rowan-walsh/BruteforceIgnorance/README.md

BruteforceIgnorance
===================

This repository is for all things related to the BruteforceIgnorance team.
Commit here, commit often: stuff saved here will be visible to all team members.

Keep the files well organised too.  Add, sort, use subfolders.
