rowan-walsh/BruteforceIgnorance/Documentation/Design Proposal/Hardware Design/Drive System Graphic.png

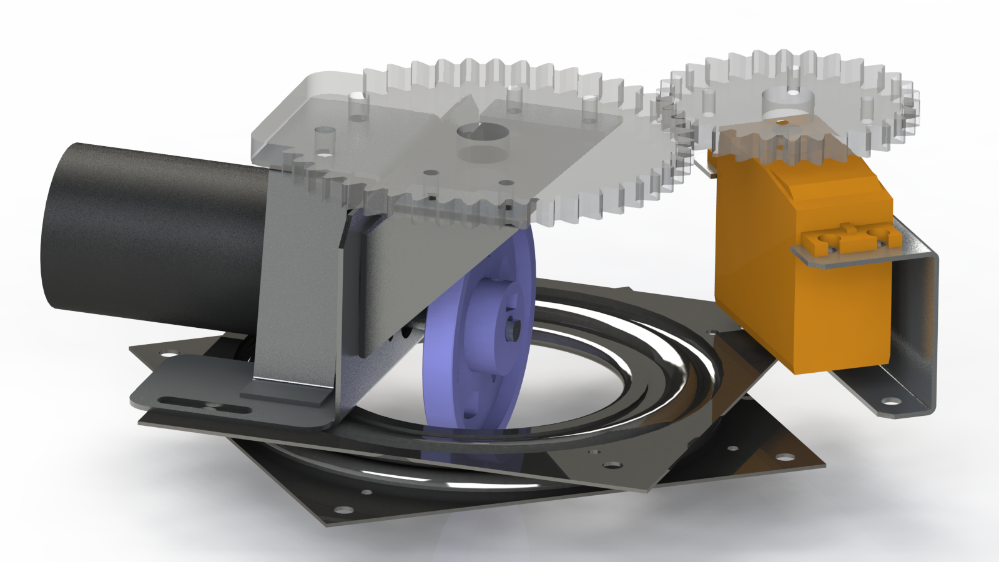
Documentation/Design Proposal/Hardware Design/Drive System Graphic.png
