rowan-walsh/BruteforceIgnorance/Documentation/Design Proposal/Hardware Design/Lazy Susan Bearing Graphic.png

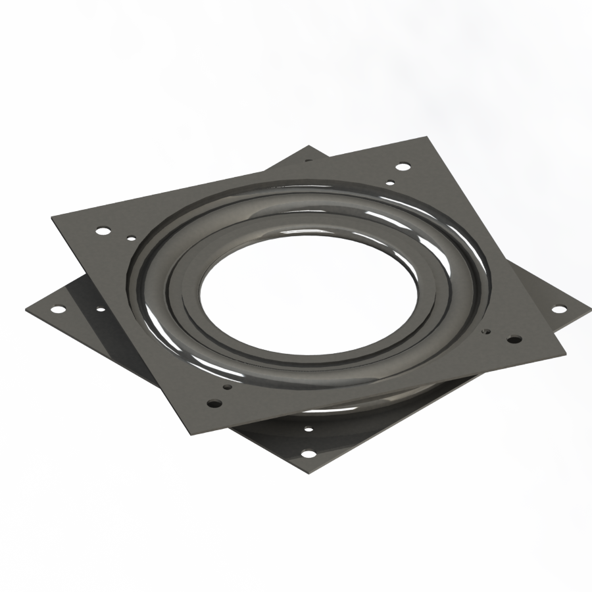
Documentation/Design Proposal/Hardware Design/Lazy Susan Bearing Graphic.png
