rowan-walsh/BruteforceIgnorance/Documentation/Design Proposal/Software Code and Algorithm/Scott Robot State Diagram.png

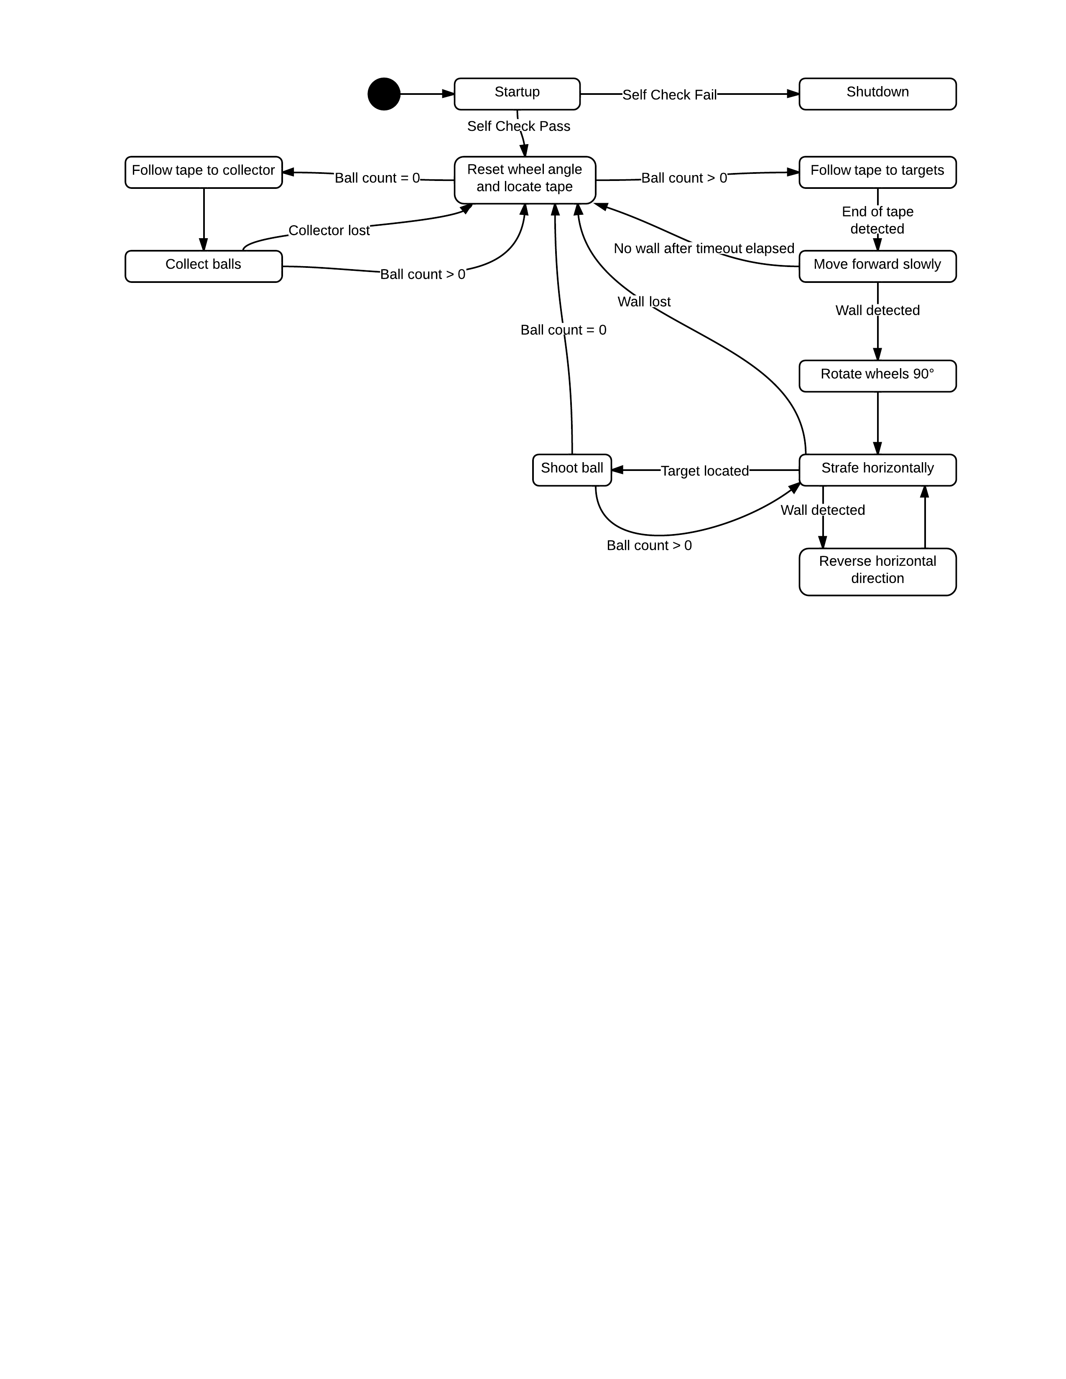
Documentation/Design Proposal/Software Code and Algorithm/Scott Robot State Diagram.png
