rowan-walsh/BruteforceIgnorance/Documentation/Design Proposal/Software Code and Algorithm/ShootingFlowchart.png

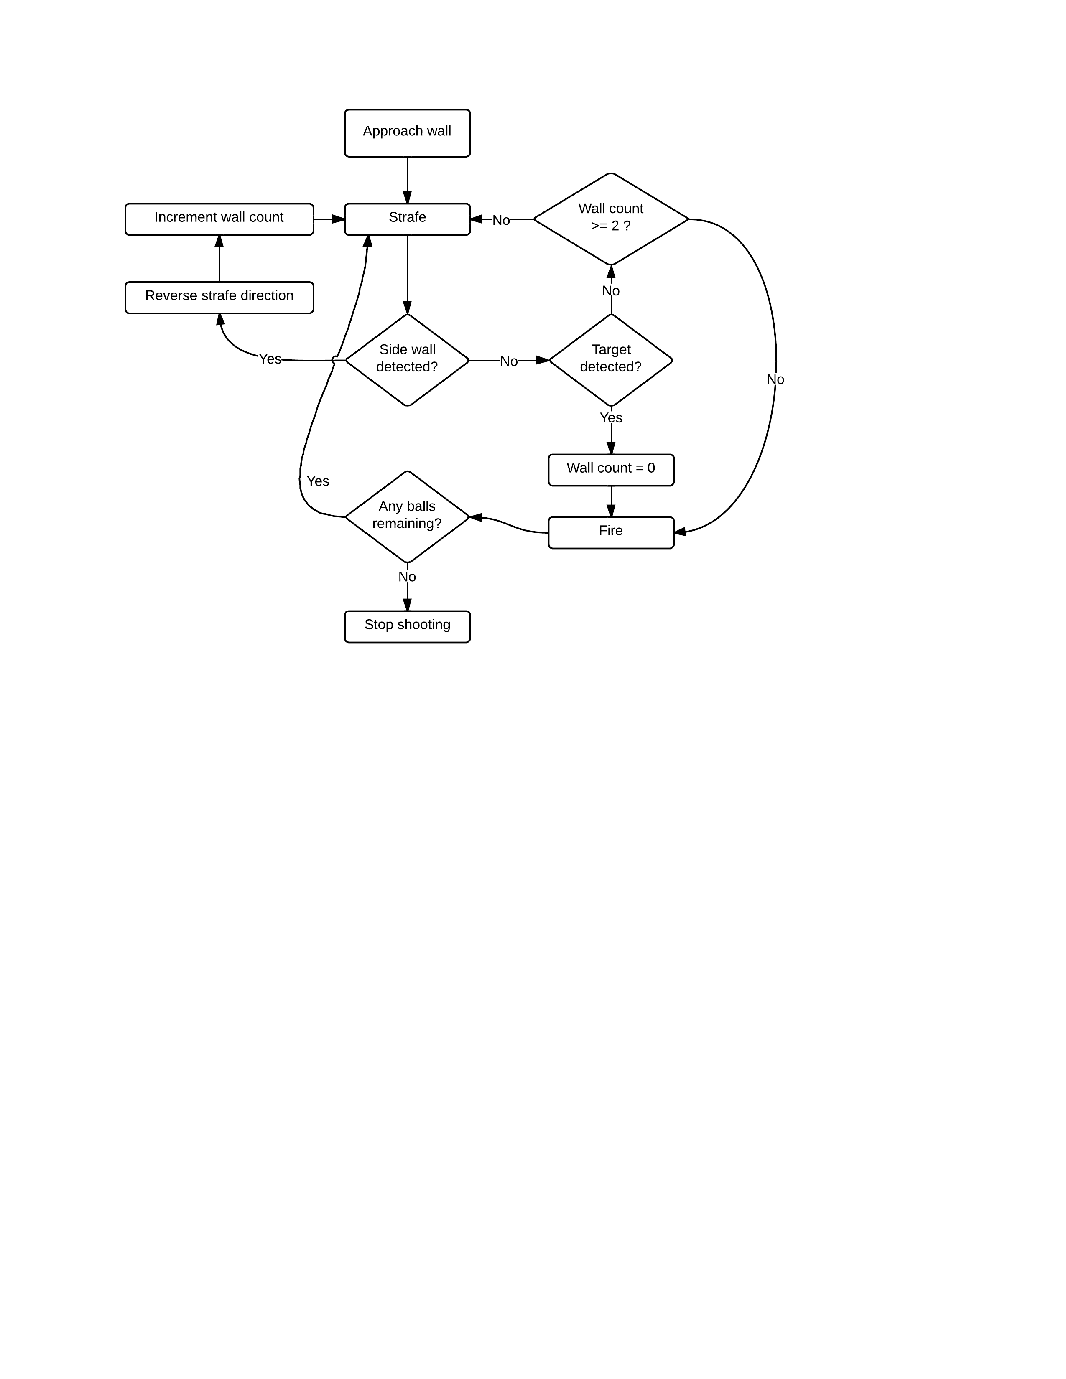
Documentation/Design Proposal/Software Code and Algorithm/ShootingFlowchart.png
