rowan-walsh/BruteforceIgnorance/Documentation/Liam's photos/Brush Closeup.jpg

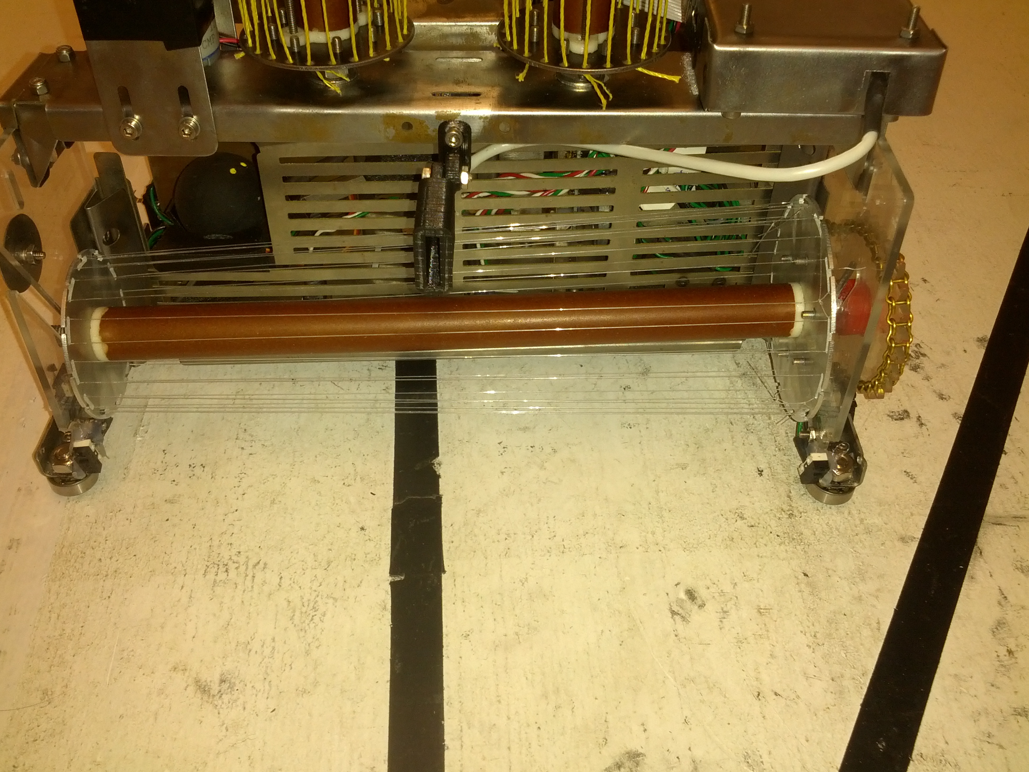
Documentation/Liam's photos/Brush Closeup.jpg
