rowan-walsh/BruteforceIgnorance/Documentation/Liam's photos/Drive closeup.jpg

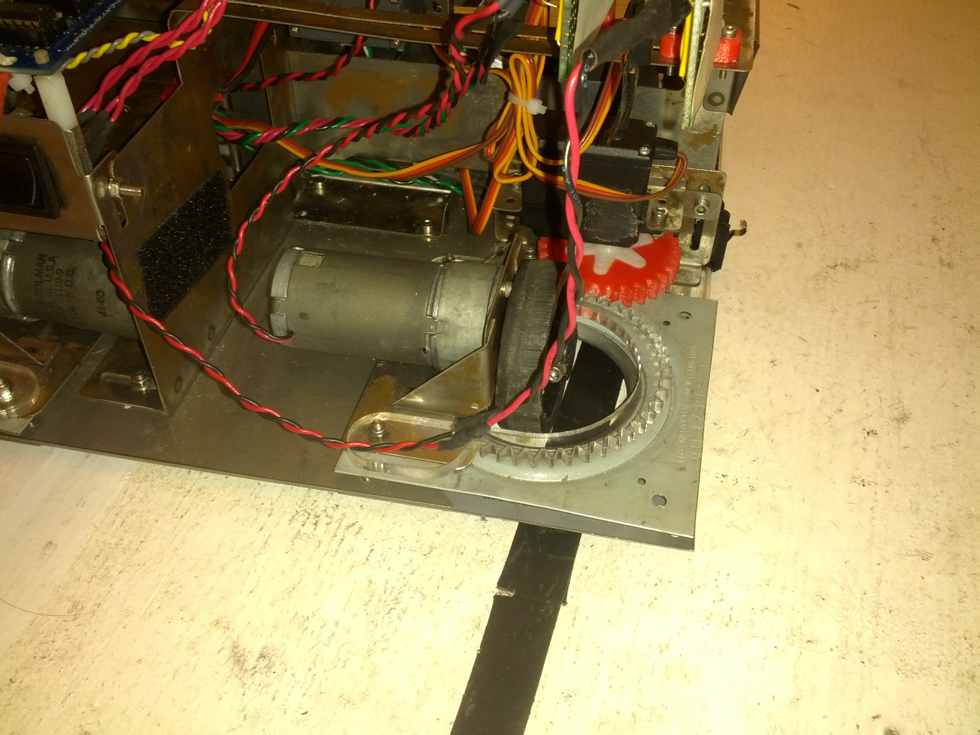
Documentation/Liam's photos/Drive closeup.jpg
