rowan-walsh/BruteforceIgnorance/Documentation/Liam's photos/Firing closeup.jpg

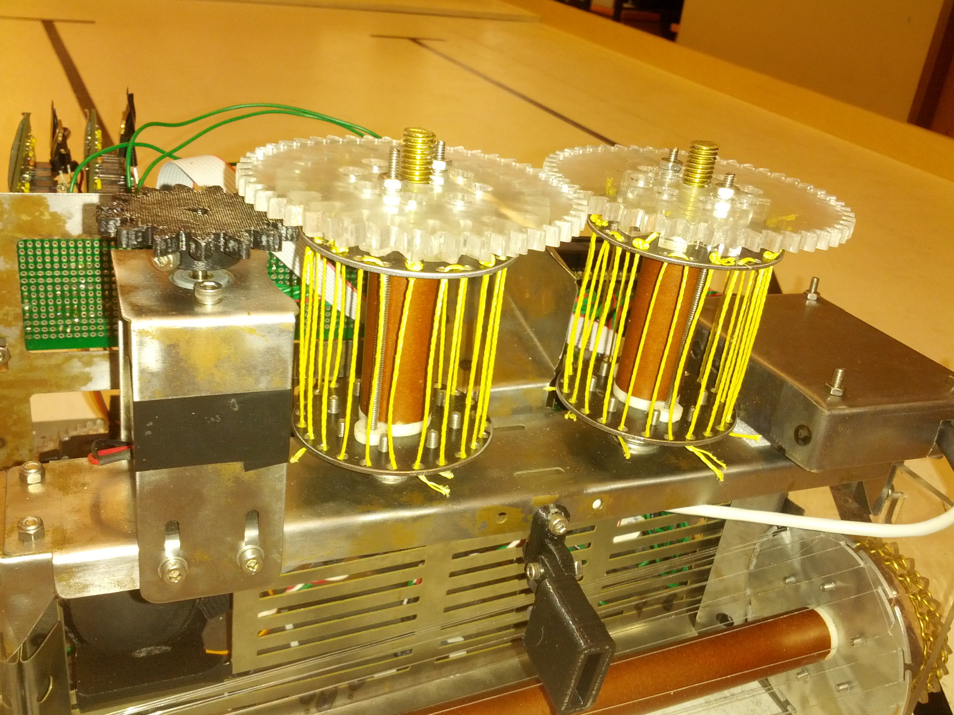
Documentation/Liam's photos/Firing closeup.jpg
