rowan-walsh/BruteforceIgnorance/Documentation/Liam's photos/Iso back.jpg

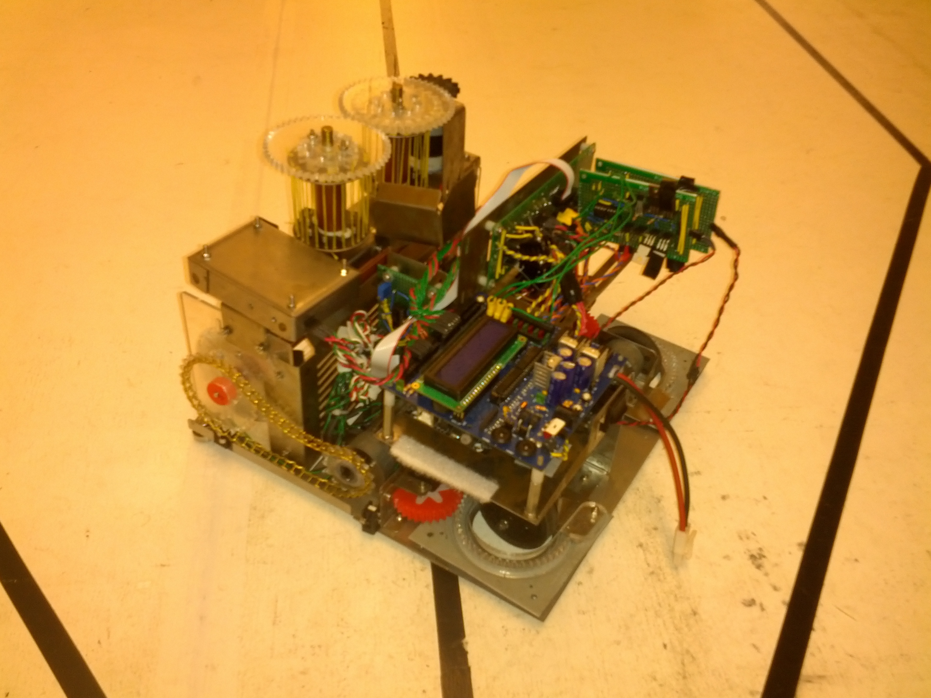
Documentation/Liam's photos/Iso back.jpg
