rowan-walsh/BruteforceIgnorance/Documentation/Liam's photos/Iso front.jpg

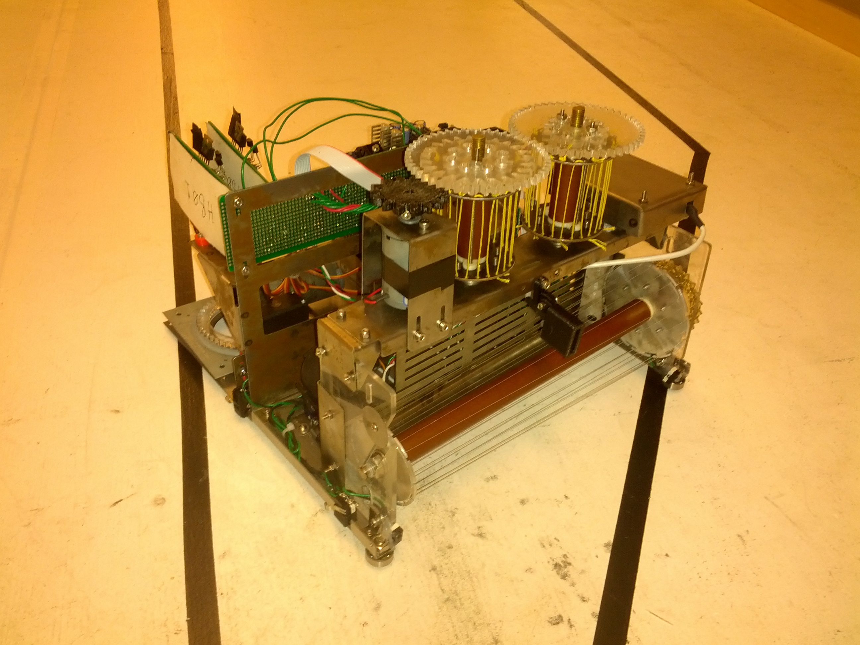
Documentation/Liam's photos/Iso front.jpg
