rowan-walsh/BruteforceIgnorance/Documentation/Liam's photos/Loading closeup.jpg

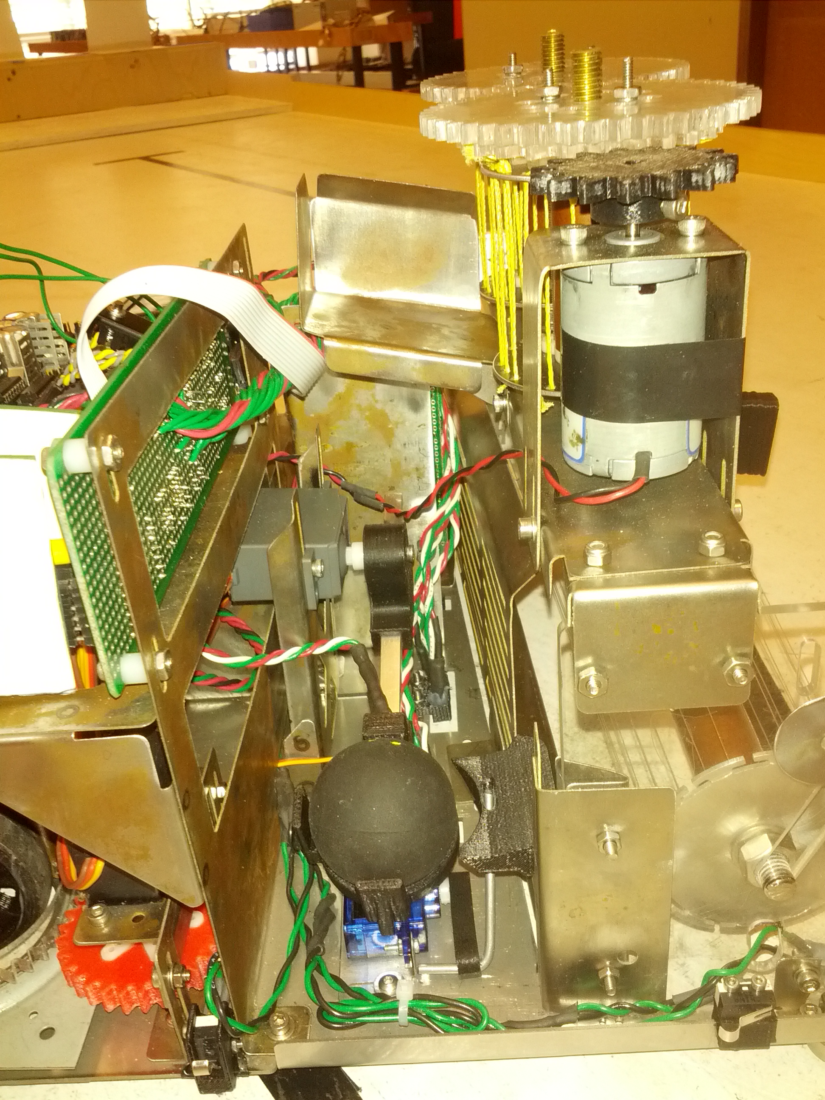
Documentation/Liam's photos/Loading closeup.jpg
