rowan-walsh/BruteforceIgnorance/Documentation/Liam's photos/Top.jpg

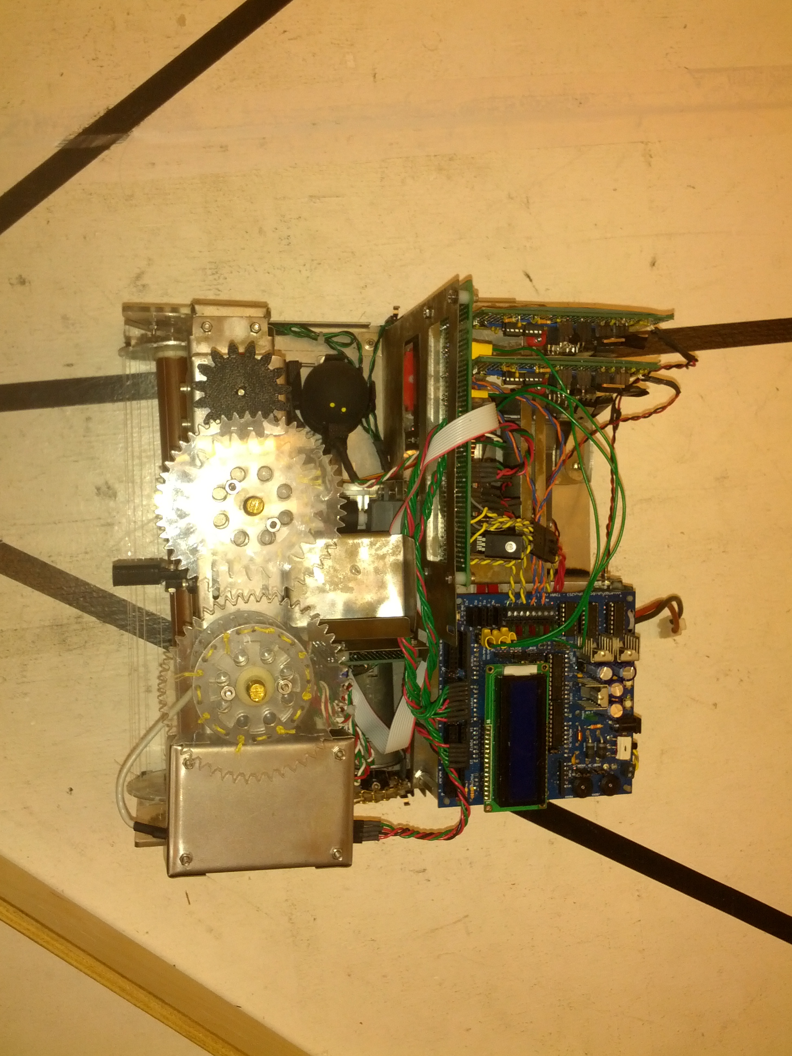
Documentation/Liam's photos/Top.jpg
