rowan-walsh/BruteforceIgnorance/Documentation/Liam's photos/Transparent.png

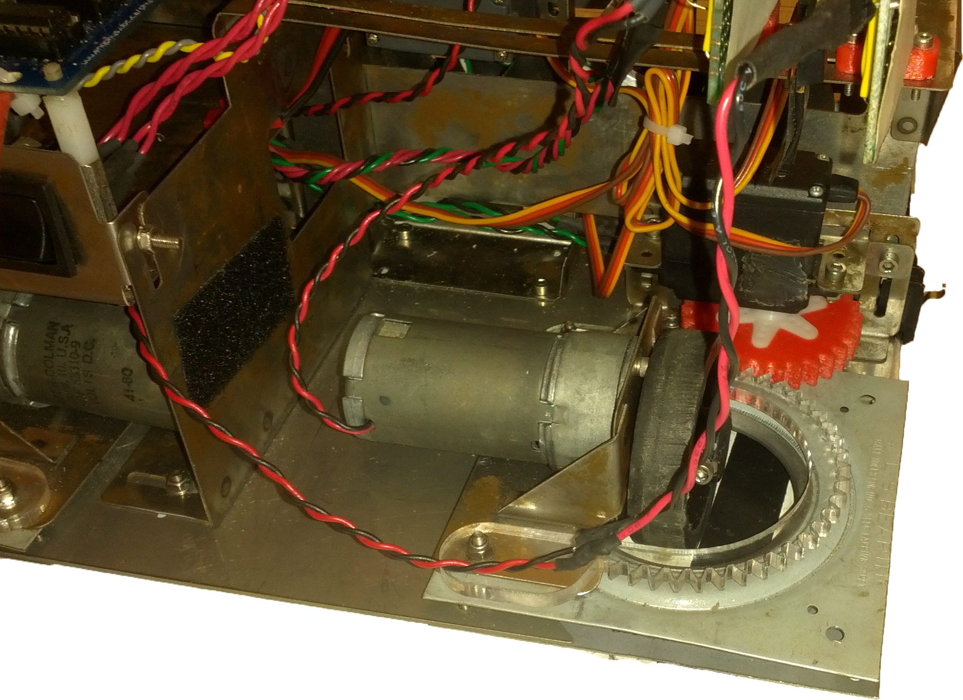
Documentation/Liam's photos/Transparent.png
