rowan-walsh/BruteforceIgnorance/Documentation/Renders/Early Firing System.png

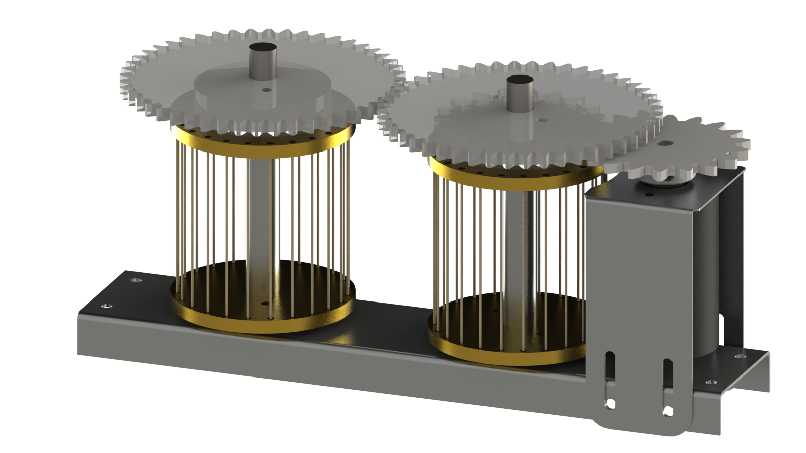
Documentation/Renders/Early Firing System.png
