rowan-walsh/BruteforceIgnorance/Documentation/Scott's photos/IMG_20130802_181802.jpg

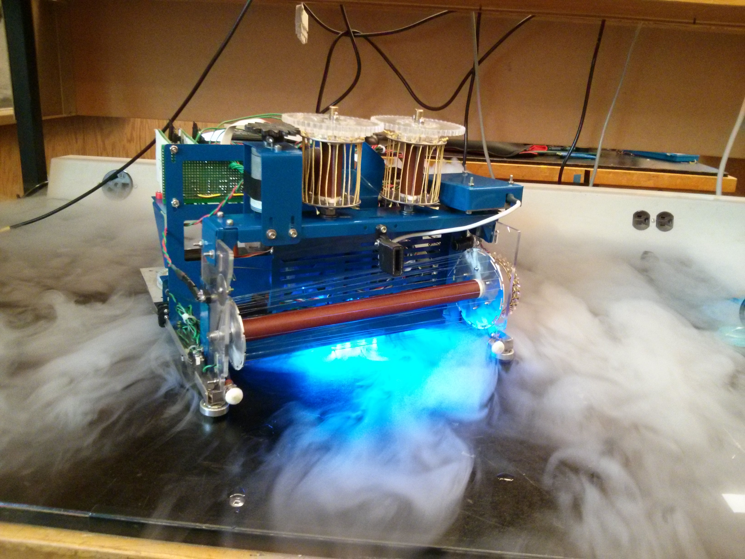
Documentation/Scott's photos/IMG_20130802_181802.jpg
