rowan-walsh/BruteforceIgnorance/Documentation/Scott's photos/IMG_20130802_181812.jpg

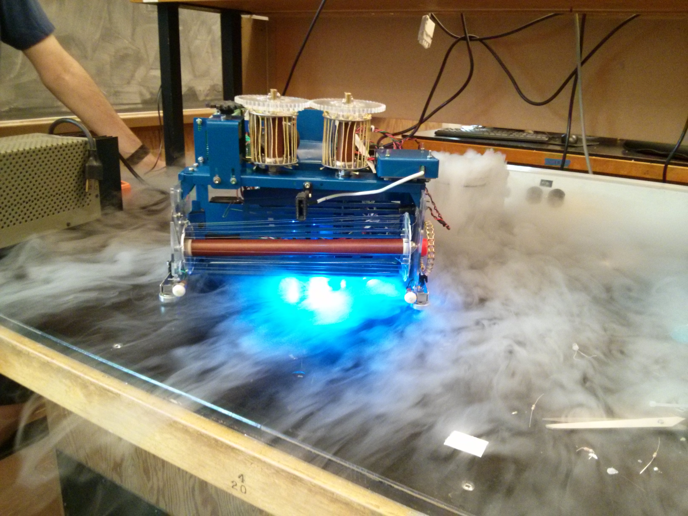
Documentation/Scott's photos/IMG_20130802_181812.jpg
