rowan-walsh/BruteforceIgnorance/Documentation/Scott's photos/IMG_20130802_181825.jpg

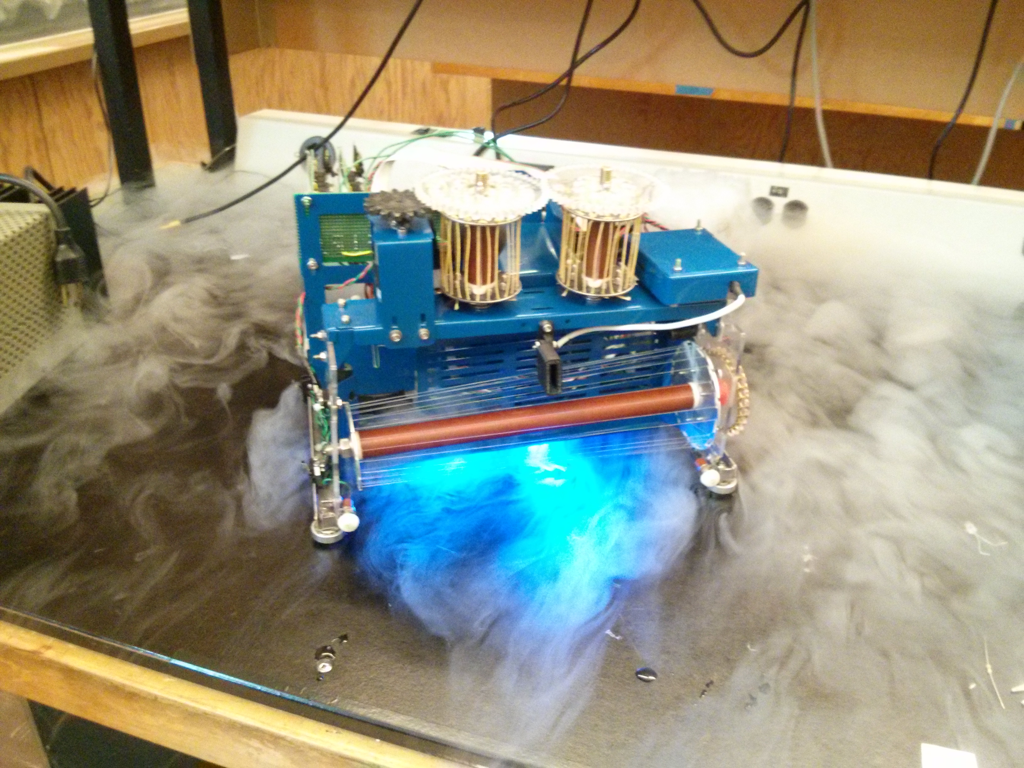
Documentation/Scott's photos/IMG_20130802_181825.jpg
