rowan-walsh/BruteforceIgnorance/Documentation/Scott's photos/IMG_20130802_181956.jpg

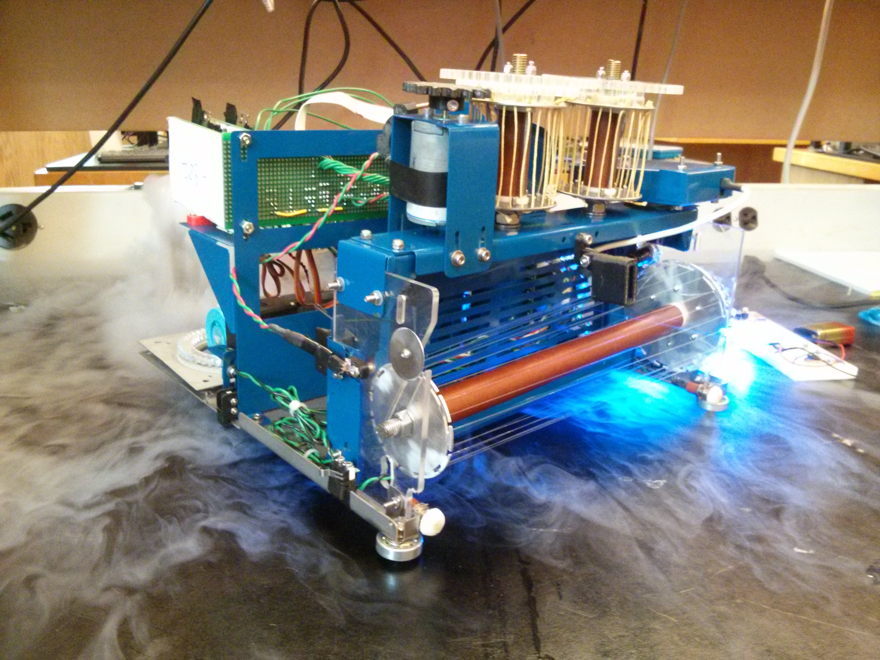
Documentation/Scott's photos/IMG_20130802_181956.jpg
