rowan-walsh/BruteforceIgnorance/Documentation/Scott's photos/IMG_20130802_182054.jpg

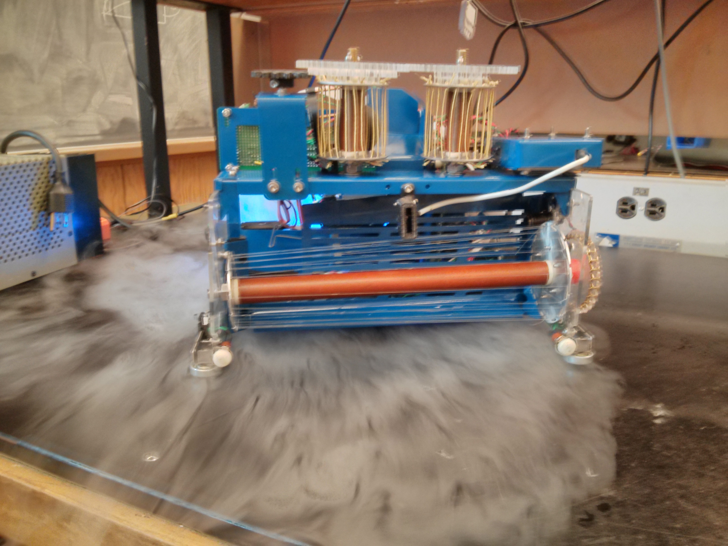
Documentation/Scott's photos/IMG_20130802_182054.jpg
