rowan-walsh/BruteforceIgnorance/Documentation/Scott's photos/IMG_20130802_182110.jpg

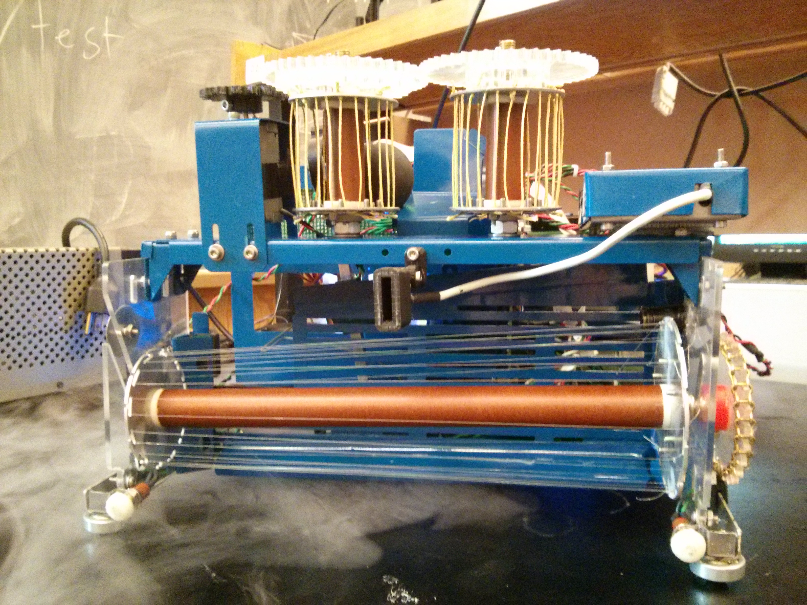
Documentation/Scott's photos/IMG_20130802_182110.jpg
