rowan-walsh/BruteforceIgnorance/Documentation/Scott's photos/IMG_20130802_182121.jpg

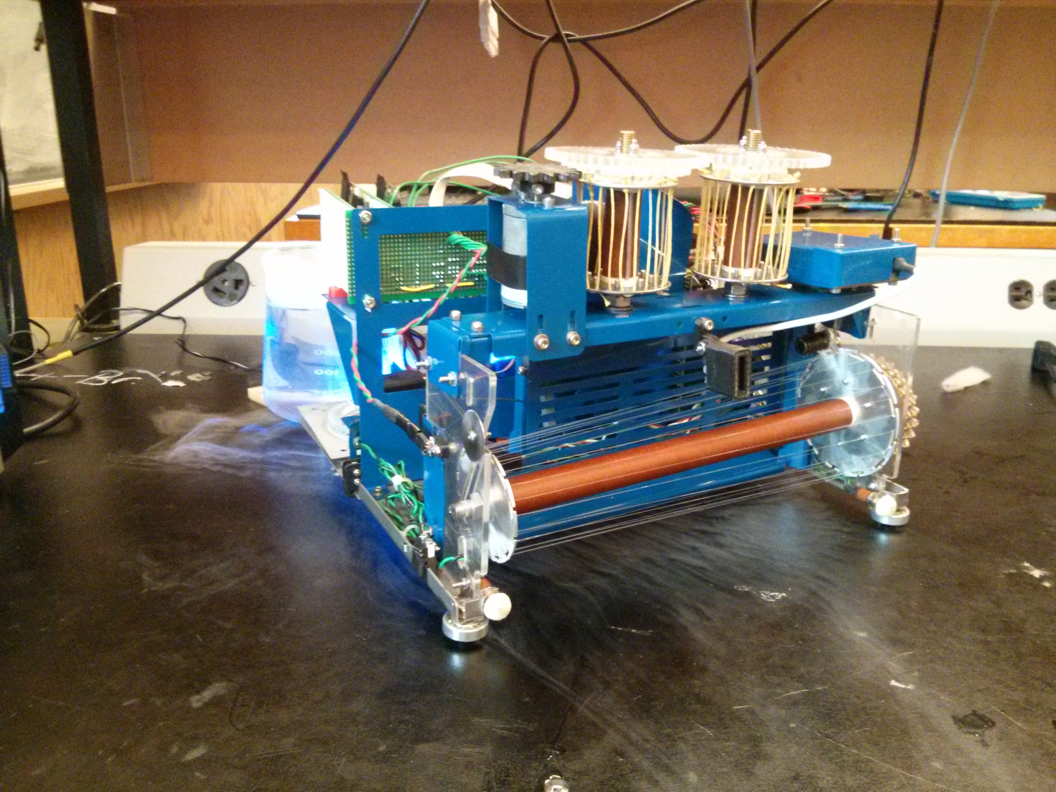
Documentation/Scott's photos/IMG_20130802_182121.jpg
