rowan-walsh/BruteforceIgnorance/Documentation/Scott's photos/IMG_20130802_185343.jpg

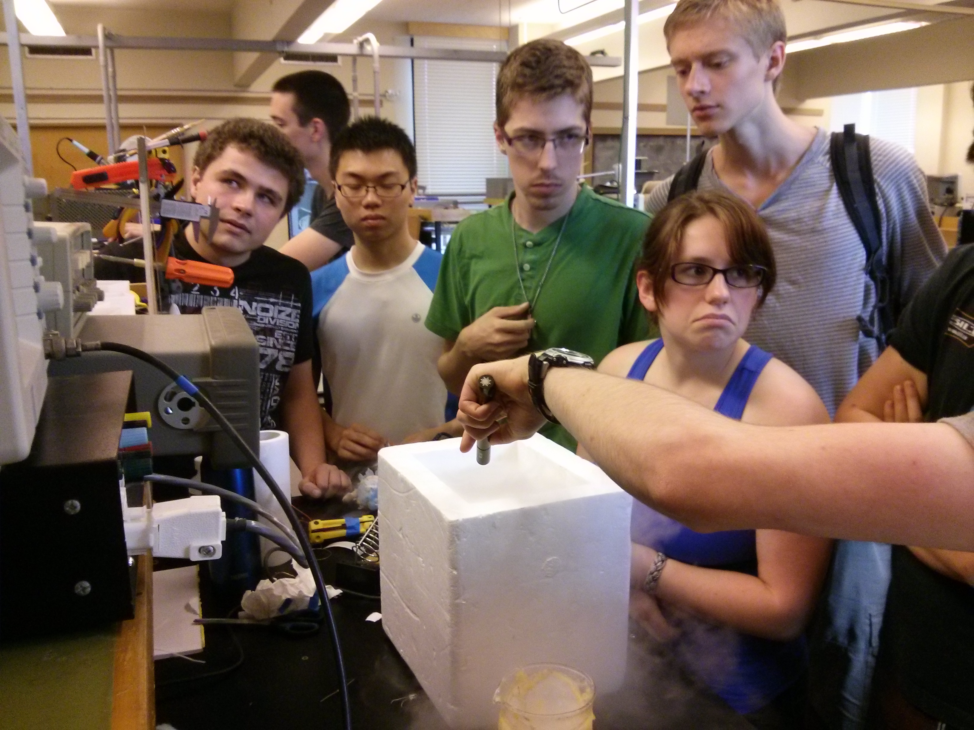
Documentation/Scott's photos/IMG_20130802_185343.jpg
