rowan-walsh/BruteforceIgnorance/Documentation/Scott's videos/Random wall follow picture.jpg

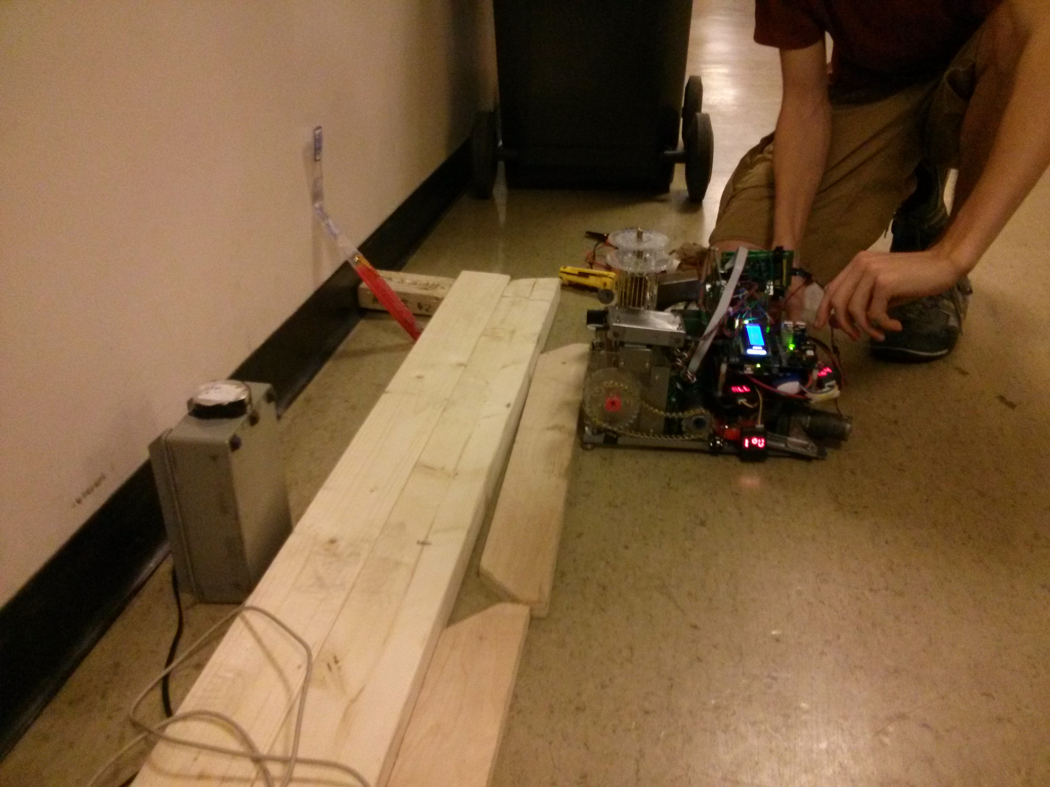
Documentation/Scott's videos/Random wall follow picture.jpg
