rowan-walsh/BruteforceIgnorance/Hardware/Supplied Component Models/solarbotics-gm7-solid-model/Solarbotics_GM7.jpg

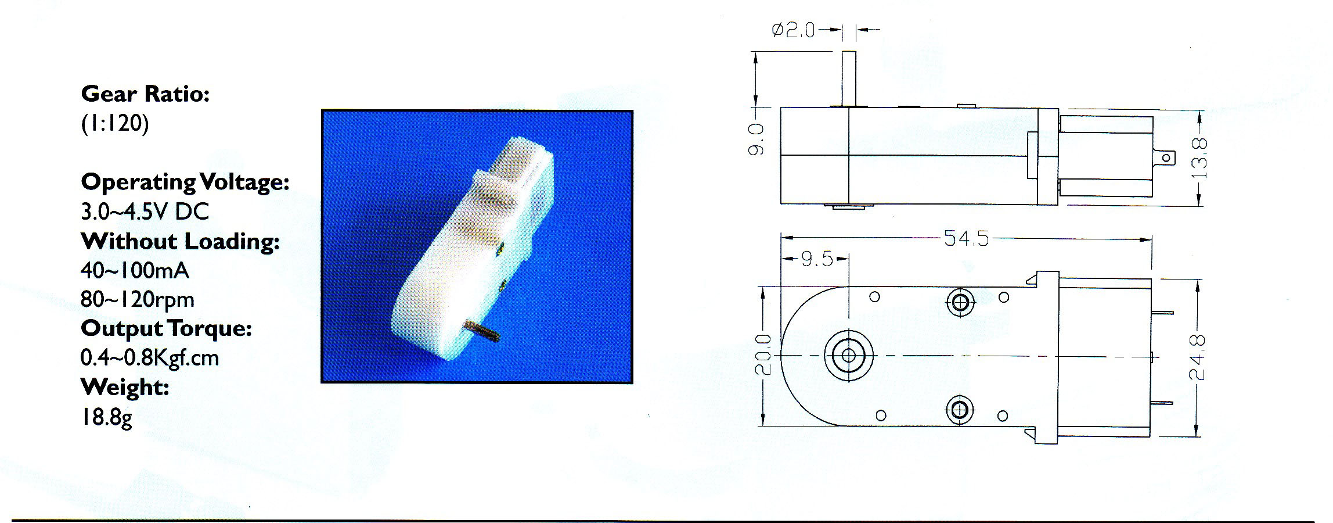
Hardware/Supplied Component Models/solarbotics-gm7-solid-model/Solarbotics_GM7.jpg
