rowan-walsh/BruteforceIgnorance/Hardware/Firing mechanism/00 Emitter.SLDASM

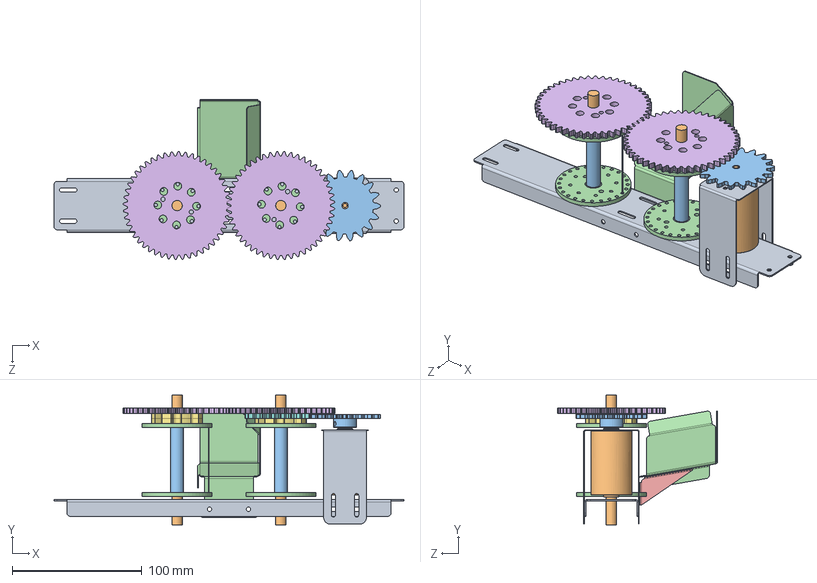
[picture p50: CAD file, 2013-07-26]
Hardware/Firing mechanism/00 Emitter.SLDASM
270.0 x 100.0 x 123.6 mm
Roller Bracket
Roller Axle x 2
Roller Spacer x 2
Roller Plate x 4
Roller Gear x 2
Roller Gear Spacer x 3
Motor-Roller Gear
Upright Motor Bracket
Motor BarbCole Ungeared
Printed Motor-Roller Gear
Upper Ramp 2
Ramp Brace
