rowan-walsh/BruteforceIgnorance/Hardware/IR Sensor/OP 805 Blinder/Blinder.SLDASM

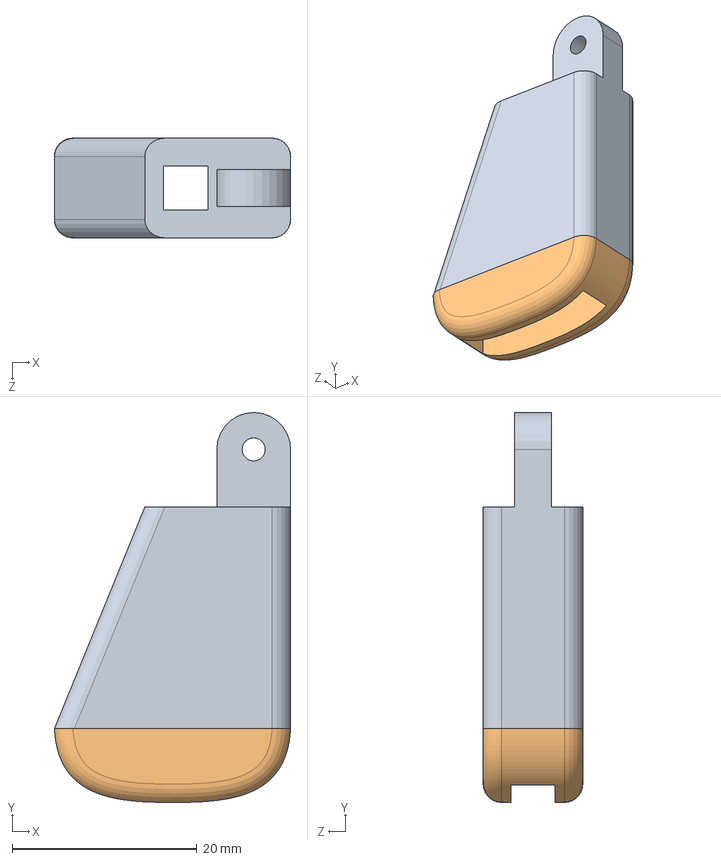
[picture p51: CAD file, 2013-07-30]
Hardware/IR Sensor/OP 805 Blinder/Blinder.SLDASM
25.6 x 42.2 x 10.8 mm
GLaDOS blinder
GLaDOS faceplate
