rowan-walsh/BruteforceIgnorance/Hardware/Laser range finder/Laser range finder assembly.SLDASM

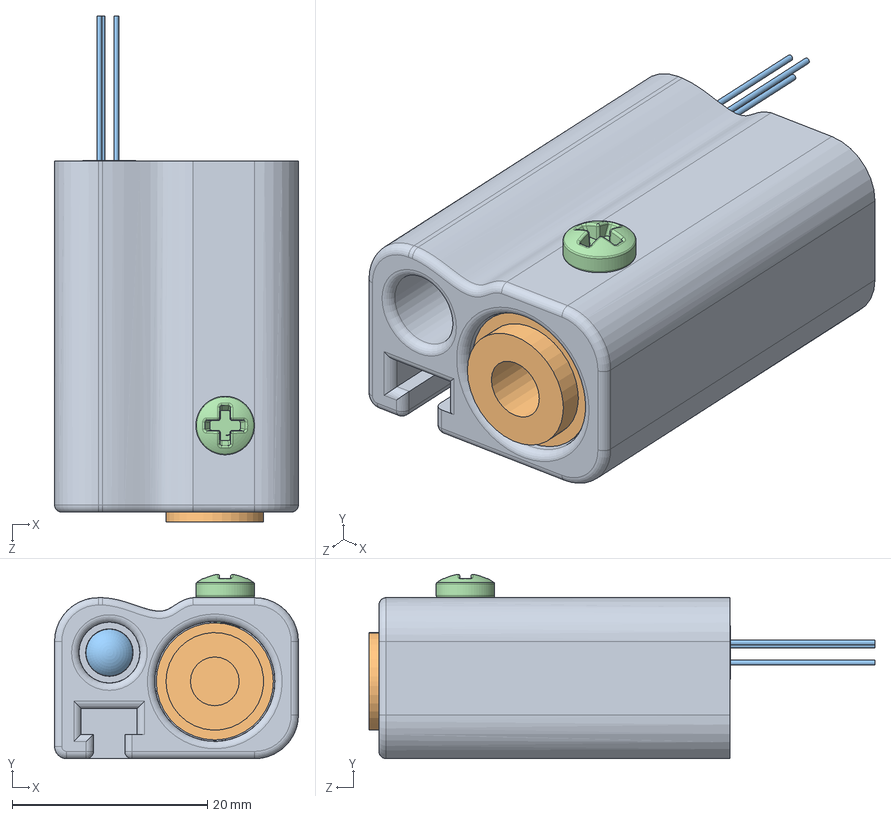
[picture p52: CAD file, 2013-06-26]
Hardware/Laser range finder/Laser range finder assembly.SLDASM
25.0 x 18.9 x 51.8 mm
Laser Range Finder
Laser pointer
OP805
Screw UNI8112_M3
