rowan-walsh/BruteforceIgnorance/Hardware/Robot Assembly.SLDASM

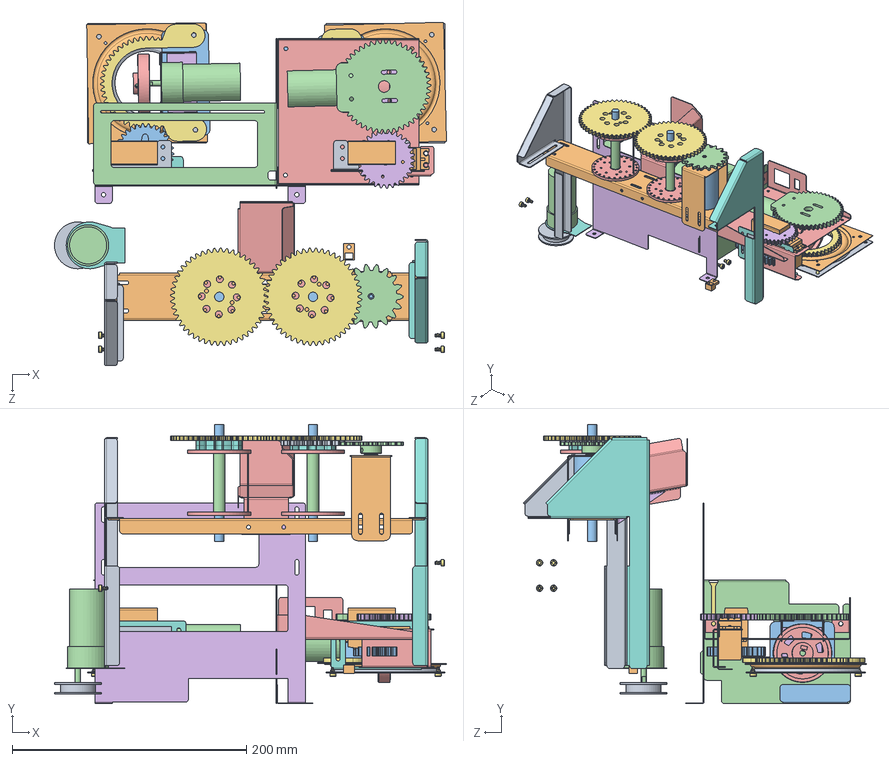
[picture p53: CAD file, 2013-07-30]
Hardware/Robot Assembly.SLDASM
334.5 x 238.5 x 293.1 mm
4inch Turntable Bottom x 2
4inch Turntable Top x 2
Motor Bracket x 2
Motor Barber Coleman geared x 3
Wheel x 2
Gear Bracket x 4
Lower Turntable Gear x 2
Servo Bracket 2.1 x 2
Servo Bracket 2.2 x 2
Servo Futaba S3003 x 3
Printed Servo Gear x 2
Turntable Gear
Servo Bracket
Servo Gear (30t)
Screw SC M3 x 5 x 10
Brush Drive Motor Mount
Brush Motor Belt Gear
QRD Holder
base right flange
battery harness mount
battery tinah mount
back support
end support
Firing Mounting Bracket
Mirrored Firing Mounting Bracket
Roller Bracket
Roller Axle x 2
Roller Spacer x 2
Roller Plate x 4
Roller Gear x 2
Roller Gear Spacer x 3
Motor-Roller Gear
Upright Motor Bracket
Motor BarbCole Ungeared
Printed Motor-Roller Gear
Upper Ramp 2
Ramp Brace
