rowan-walsh/BruteforceIgnorance/Hardware/Supplied Component Models/solarbotics_gm2_solid_models/GM2_assembly.IGS

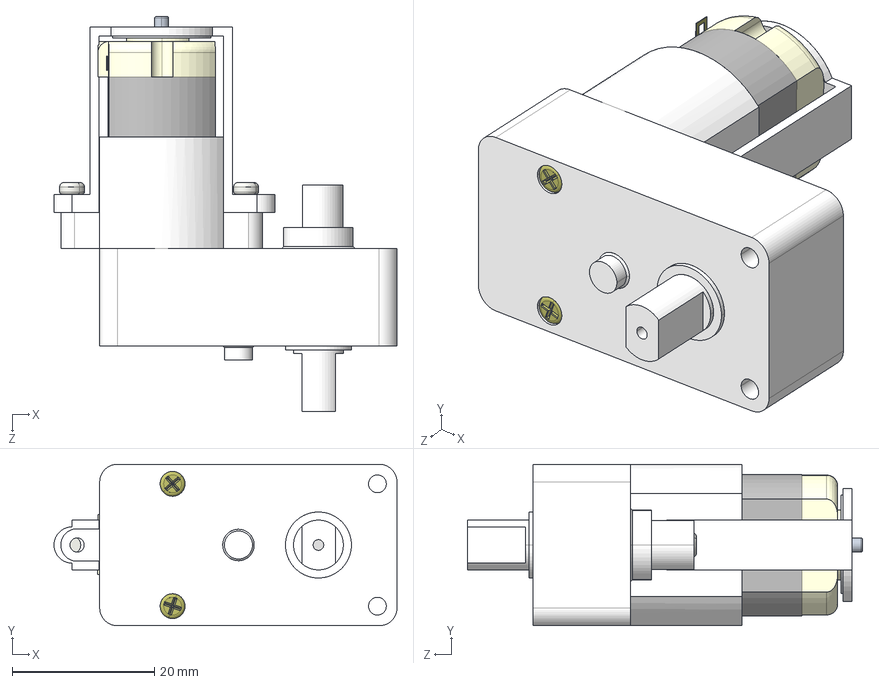
[picture p54: CAD file, 2013-05-31]
Hardware/Supplied Component Models/solarbotics_gm2_solid_models/GM2_assembly.IGS
48.2 x 22.7 x 55.6 mm
