rowan-walsh/BruteforceIgnorance/Hardware/Ball Collector/Brush_Assembly.SLDASM

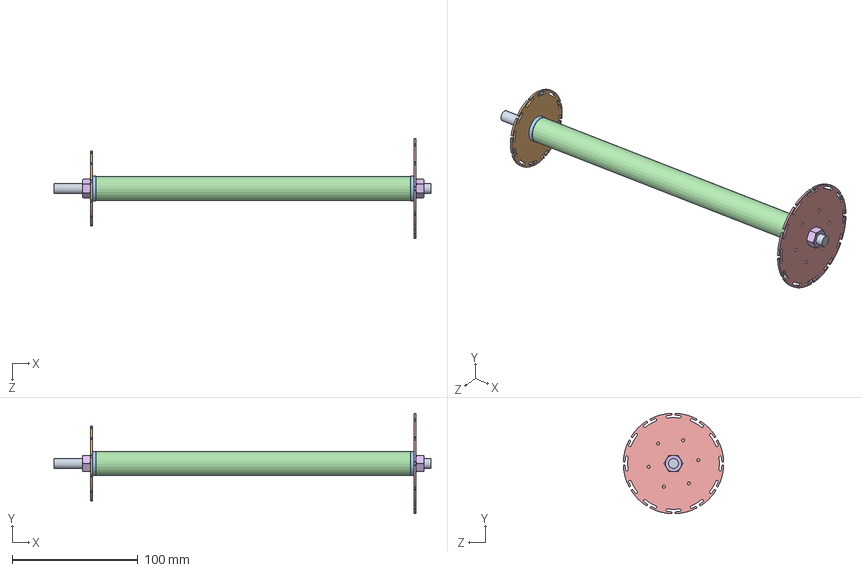
[picture p55: CAD file, 2013-07-25]
Hardware/Ball Collector/Brush_Assembly.SLDASM
300.0 x 80.0 x 80.0 mm
Brush_Rod
Brush_Wheel_Small
Space Rod Cap x 2
Spacer Tube
Brush_Wheel_Tensioner
M8 Washer x 2
