rowan-walsh/BruteforceIgnorance/Hardware/Ferris Wheel/Ferris Assembly.SLDASM

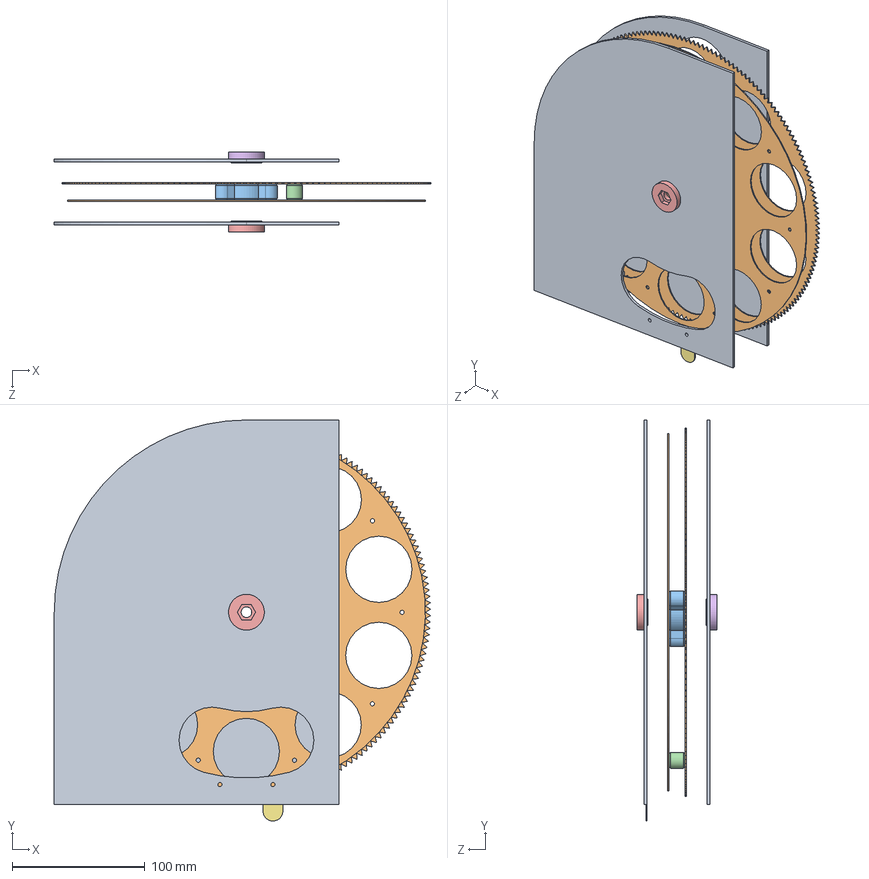
[picture p56: CAD file, 2013-06-09]
Hardware/Ferris Wheel/Ferris Assembly.SLDASM
284.0 x 302.5 x 60.0 mm
Containment Plate
Axle Bolt Head Holder
Insertion Ramp
