rowan-walsh/BruteforceIgnorance/Hardware/Firing mechanism/01 Firing Assembly.SLDASM

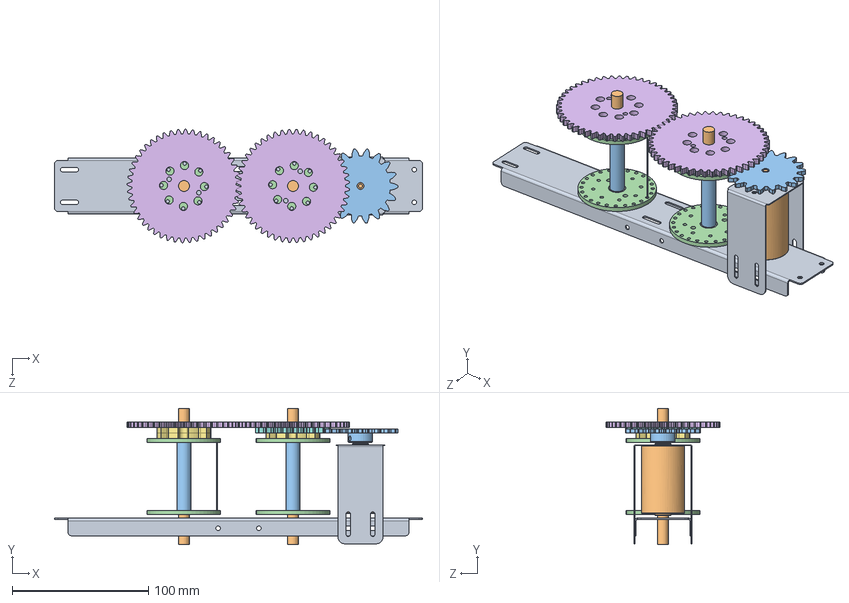
[picture p57: CAD file, 2013-07-26]
Hardware/Firing mechanism/01 Firing Assembly.SLDASM
270.0 x 100.0 x 83.3 mm
Roller Bracket
Roller Axle x 2
Roller Spacer x 2
Roller Plate x 4
Roller Gear x 2
Roller Gear Spacer x 3
Motor-Roller Gear
Upright Motor Bracket
Motor BarbCole Ungeared
Printed Motor-Roller Gear
