rowan-walsh/BruteforceIgnorance/Hardware/IR Sensor/IR Box.SLDASM

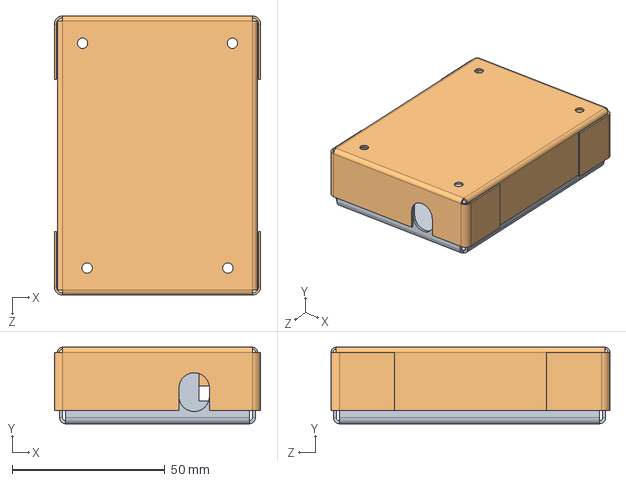
[picture p58: CAD file, 2013-08-08]
Hardware/IR Sensor/IR Box.SLDASM
67.5 x 25.1 x 91.2 mm
IR Box Bottom
IR Box Top
