rowan-walsh/BruteforceIgnorance/Hardware/Mars Rover Wheels/00 Mars Rover Wheel Assembly.SLDASM

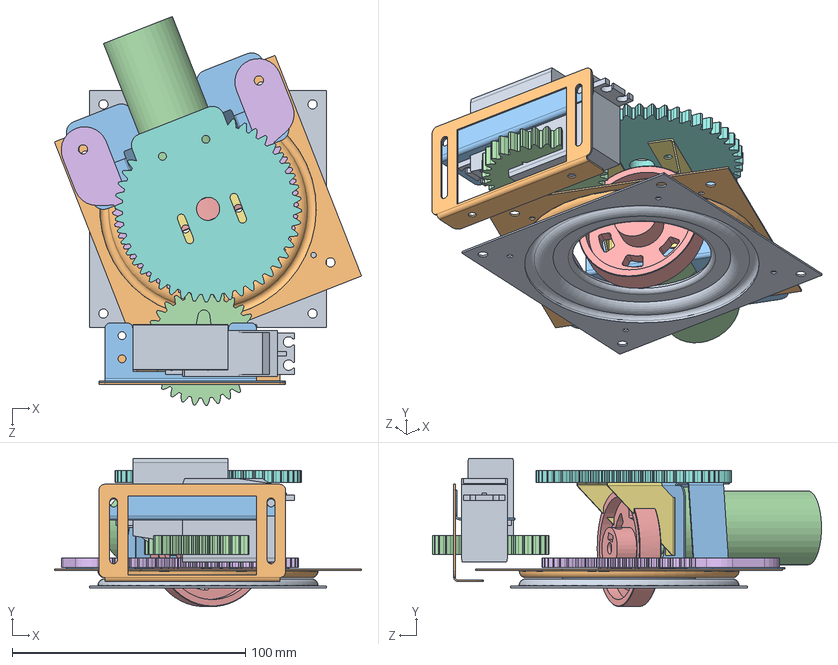
[picture p59: CAD file, 2013-07-16]
Hardware/Mars Rover Wheels/00 Mars Rover Wheel Assembly.SLDASM
131.7 x 63.5 x 166.8 mm
4inch Turntable Bottom
4inch Turntable Top
Motor Bracket
Motor Barber Coleman geared
Wheel
Lower Turntable Gear
Gear Bracket x 2
Turntable Gear
Servo Futaba S3003 x 2
Servo Bracket 2.1
Servo Bracket 2.2
Printed Servo Gear
