rowan-walsh/BruteforceIgnorance/Hardware/Wall Bearing/Wall Bearing Assembly.SLDASM

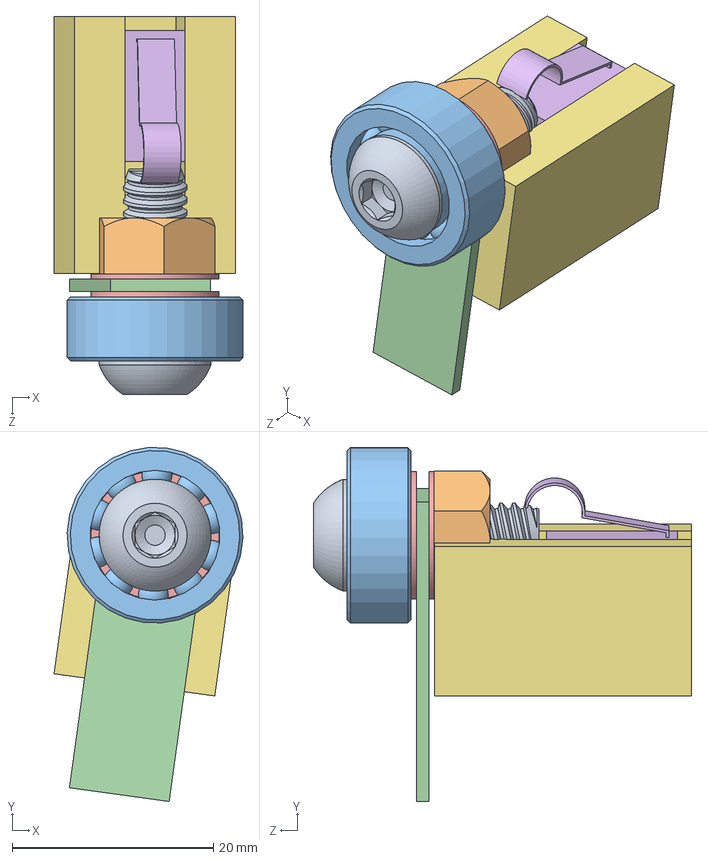
[picture p60: CAD file, 2013-07-25]
Hardware/Wall Bearing/Wall Bearing Assembly.SLDASM
18.8 x 35.1 x 37.5 mm
Screw 1-4in 3-4in long
Nut 1-4-20
Bearing 1-4in ID 11-16in OD
chassis arm
Washer 0.26ID 0.5OD x 2
Touch Sensor
Touch Sensor Holder
