rowan-walsh/BruteforceIgnorance/Hardware/Firing mechanism/Camshaft loader/Camshaft circle.SLDASM

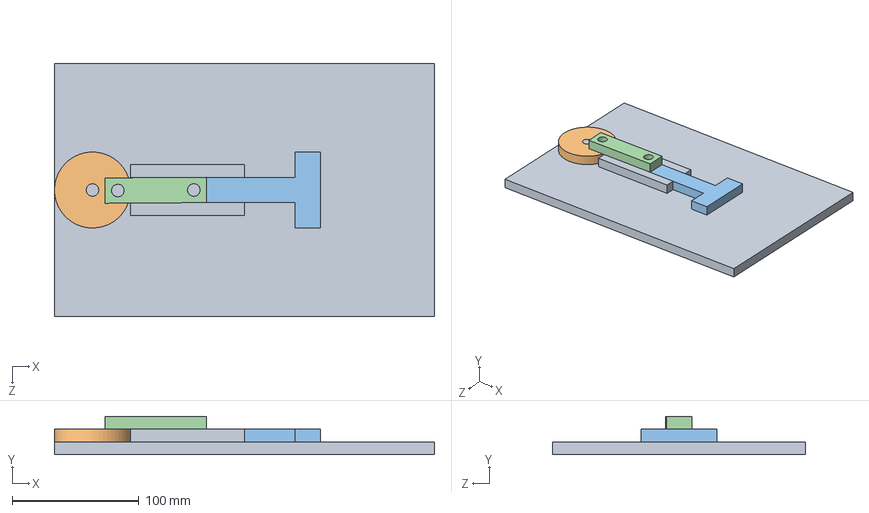
[picture p61: CAD file, 2013-06-15]
Hardware/Firing mechanism/Camshaft loader/Camshaft circle.SLDASM
300.0 x 30.0 x 200.0 mm
Camshaft base
Cam
Pusher
Shaft
