rowan-walsh/BruteforceIgnorance/Hardware/Mars Rover Wheels/01 Motor Assembly.SLDASM

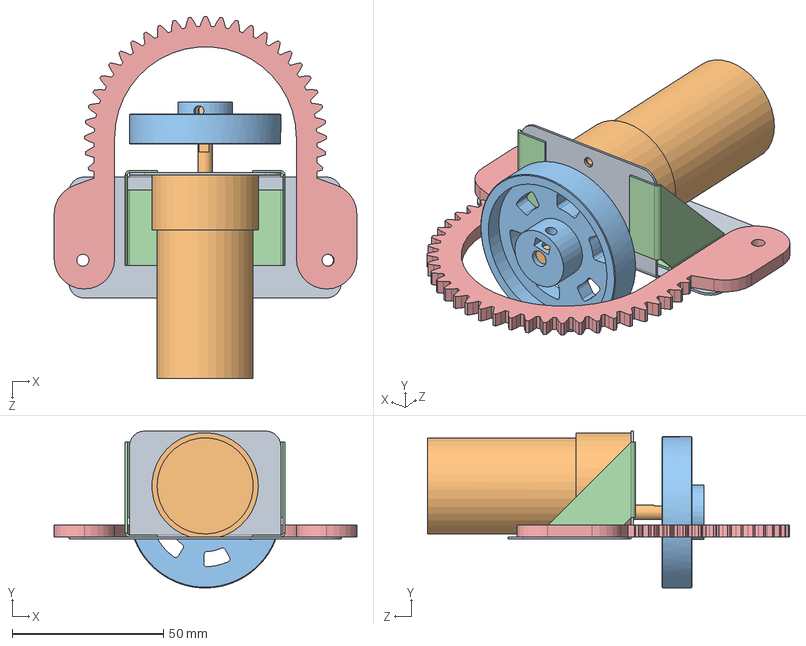
[picture p62: CAD file, 2013-07-06]
Hardware/Mars Rover Wheels/01 Motor Assembly.SLDASM
100.0 x 51.8 x 119.6 mm
Motor Bracket
Motor Barber Coleman geared
Wheel
Gear Bracket x 2
Lower Turntable Gear
