rowan-walsh/BruteforceIgnorance/Hardware/Rough Layout/Collection 2 Rough Assembly.SLDASM

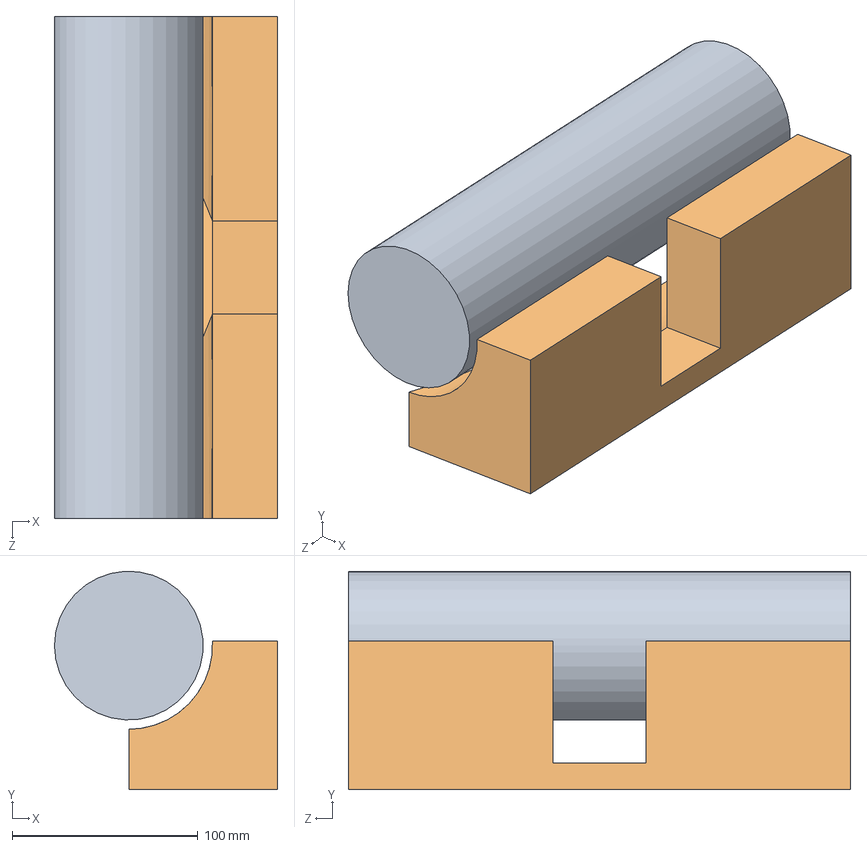
[picture p63: CAD file, 2013-06-08]
Hardware/Rough Layout/Collection 2 Rough Assembly.SLDASM
120.0 x 117.5 x 270.0 mm
Brush - rough
Ball Guide 2 - rough
