rowan-walsh/BruteforceIgnorance/Hardware/Supplied Component Models/Servo/Servo Assembly Futaba S3003.SLDASM

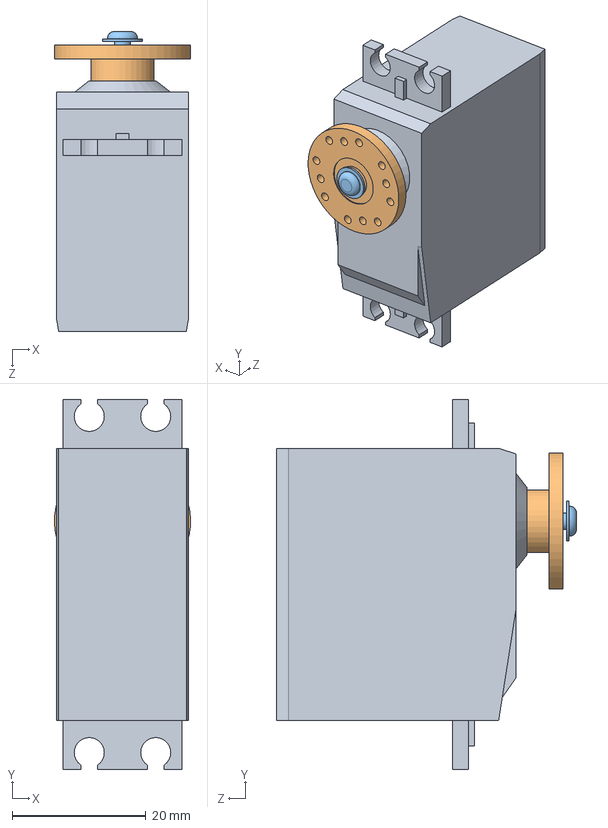
[picture p64: CAD file, 2013-06-15]
Hardware/Supplied Component Models/Servo/Servo Assembly Futaba S3003.SLDASM
20.3 x 55.3 x 44.8 mm
Servo Futaba S3003
Servo Rotor
Servo Spindle
