rowan-walsh/BruteforceIgnorance/Hardware/Supplied Component Models/worm and gear assembly.SLDASM

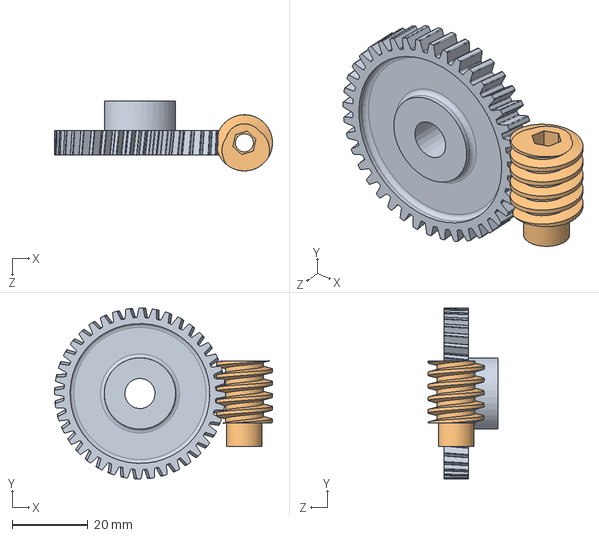
[picture p65: CAD file, 2013-06-15]
Hardware/Supplied Component Models/worm and gear assembly.SLDASM
57.4 x 45.0 x 18.4 mm
helical gear 40 teeth
worm for helical gear
