rowan-walsh/BruteforceIgnorance/Hardware/Ball Collector/Brush Drive.SLDASM

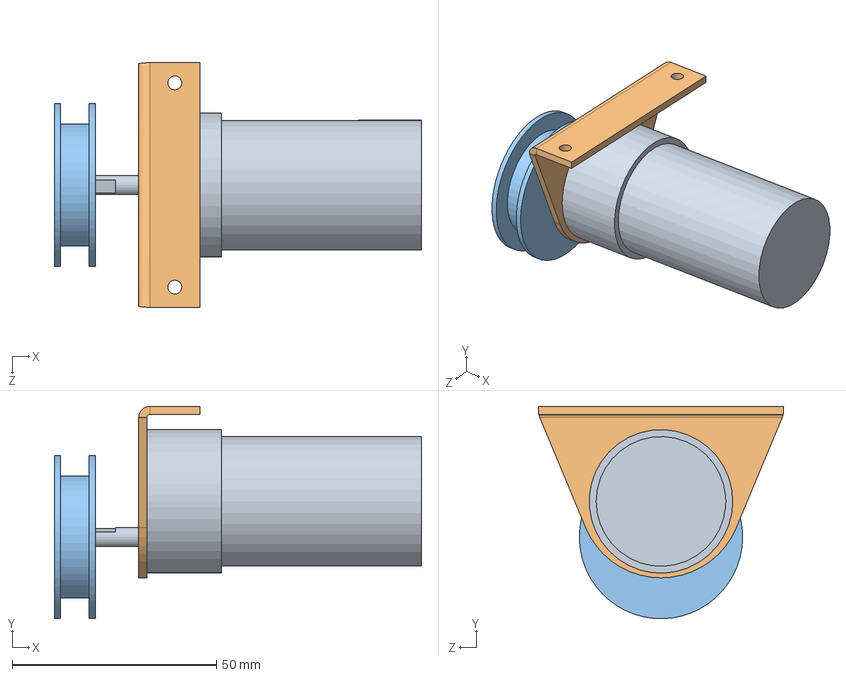
[picture p66: CAD file, 2013-07-09]
Hardware/Ball Collector/Brush Drive.SLDASM
89.9 x 52.0 x 60.0 mm
Motor Barber Coleman geared
Brush Drive Motor Mount
Brush Motor Belt Gear
