rowan-walsh/BruteforceIgnorance/Hardware/Firing mechanism/02 Roller Assembly.SLDASM

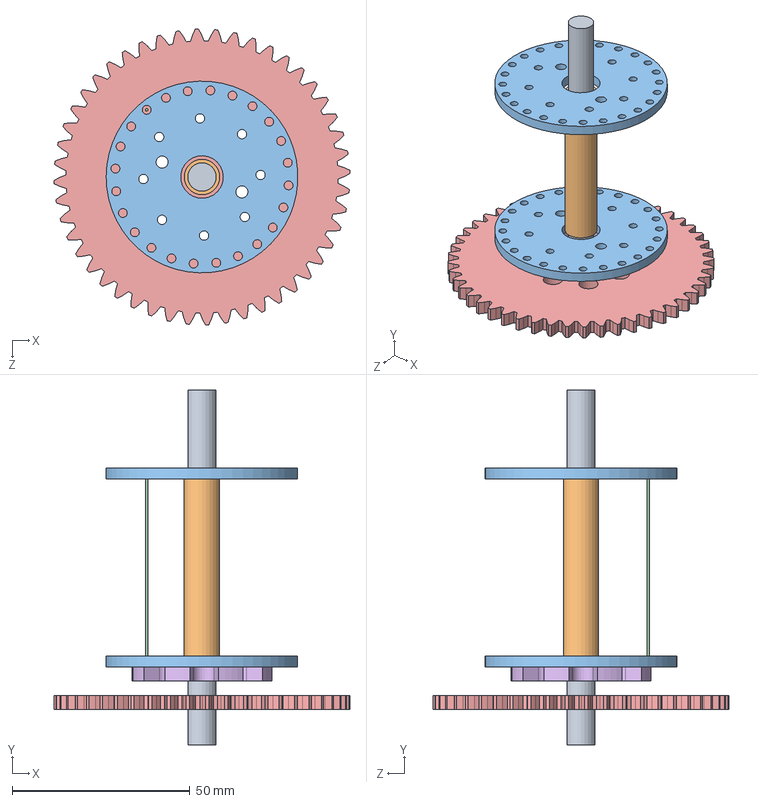
[picture p67: CAD file, 2013-07-25]
Hardware/Firing mechanism/02 Roller Assembly.SLDASM
83.3 x 100.0 x 83.3 mm
Roller Axle
Roller Spacer
Roller Plate x 2
Roller Gear
Roller Gear Spacer
