rowan-walsh/BruteforceIgnorance/Hardware/Rough Layout/Drive Wheel Rough Assembly.SLDASM

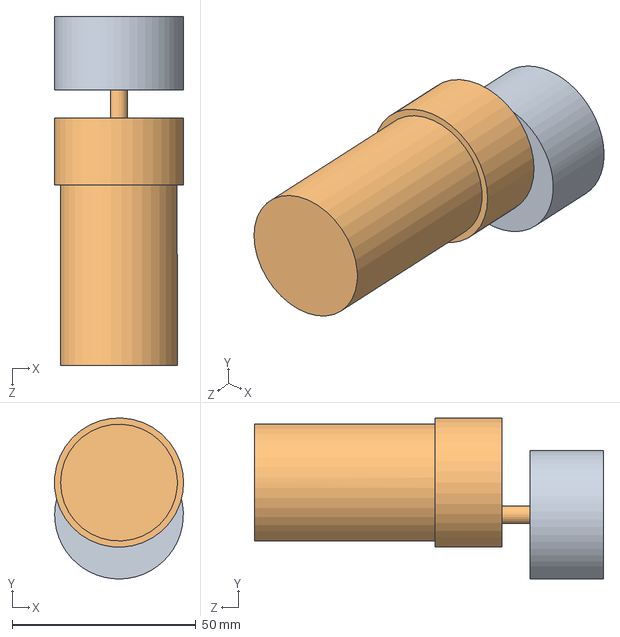
[picture p68: CAD file, 2013-06-06]
Hardware/Rough Layout/Drive Wheel Rough Assembly.SLDASM
35.1 x 43.8 x 94.9 mm
Wheel - rough
Motor Barber Coleman geared
