rowan-walsh/BruteforceIgnorance/Hardware/Chassis/000 Chassis Assembly.SLDASM

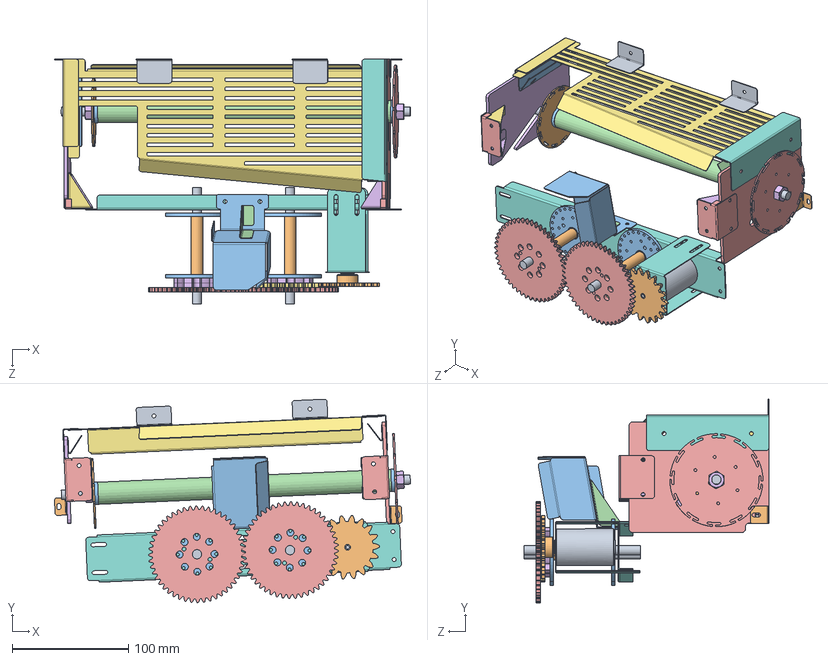
[picture p69: CAD file, 2013-07-26]
Hardware/Chassis/000 Chassis Assembly.SLDASM
305.8 x 174.8 x 210.1 mm
Brush_Rod
Brush_Wheel_Small
Space Rod Cap x 2
Spacer Tube
Brush_Wheel_Tensioner
M8 Washer x 2
021 Collector Wall Back
031 Big Corner Flange
flange wall back x 2
flange wall side x 2
small corner guard
large corner guard
022 Brush Shaft Holder Large
023 Brush Shaft Holder Small
Small Corner Flange
Roller Bracket
Roller Axle x 2
Roller Spacer x 2
Roller Plate x 4
Roller Gear x 2
Roller Gear Spacer x 3
Motor-Roller Gear
Upright Motor Bracket
Motor BarbCole Ungeared
Printed Motor-Roller Gear
Upper Ramp 2
Ramp Brace
Firing Support x 2
Firing Support Support x 2
Firing Support Support (mirror) x 2
