rowan-walsh/BruteforceIgnorance/Hardware/Ferris Wheel/Wheel Assembly.SLDASM

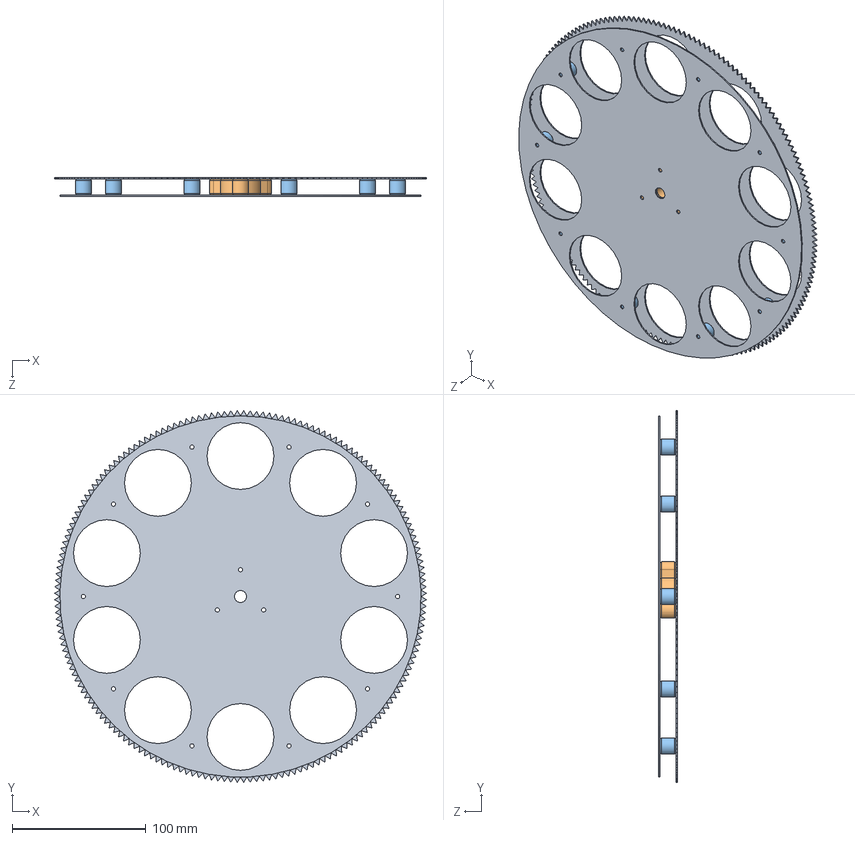
[picture p70: CAD file, 2013-06-09]
Hardware/Ferris Wheel/Wheel Assembly.SLDASM
278.1 x 278.1 x 14.0 mm
Ferris Plate x 2
Center Spacer
Perimeter Spacer x 10
