rowan-walsh/BruteforceIgnorance/Hardware/Mars Rover Wheels/01 Servo Assembly v2.SLDASM

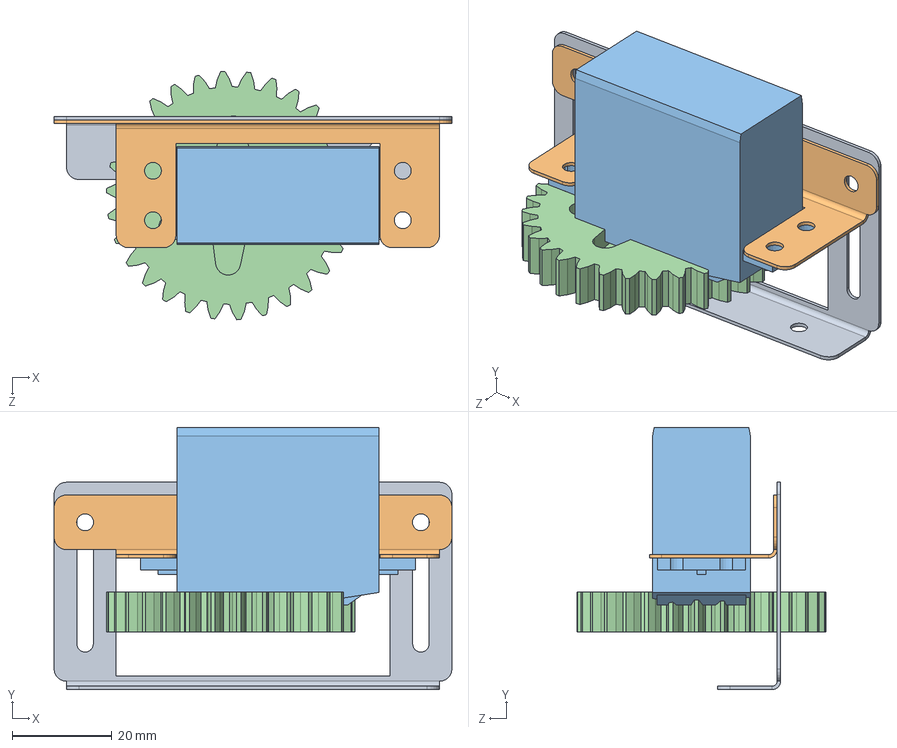
[picture p71: CAD file, 2013-07-06]
Hardware/Mars Rover Wheels/01 Servo Assembly v2.SLDASM
80.0 x 52.7 x 50.0 mm
Servo Bracket 2.1
Servo Bracket 2.2
Servo Futaba S3003
Printed Servo Gear
