rowan-walsh/BruteforceIgnorance/Hardware/Electrical Mounting/electrical mounting assembly.SLDASM

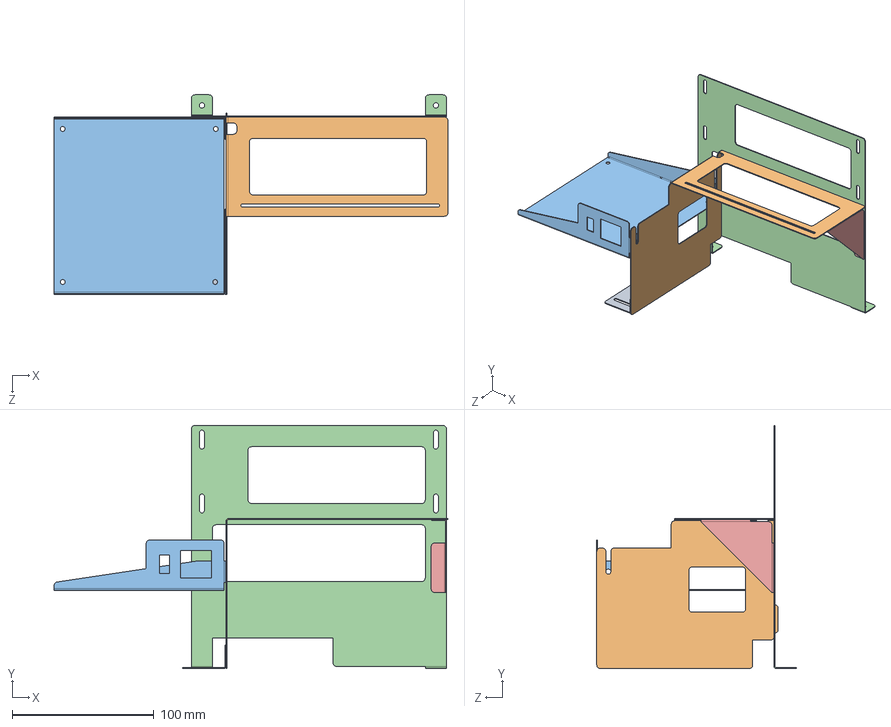
[picture p72: CAD file, 2013-07-19]
Hardware/Electrical Mounting/electrical mounting assembly.SLDASM
277.9 x 171.4 x 140.7 mm
base right flange
battery harness mount
battery tinah mount
back support
end support
