rowan-walsh/BruteforceIgnorance/Hardware/Rough Layout/Collection Rough Assembly.SLDASM

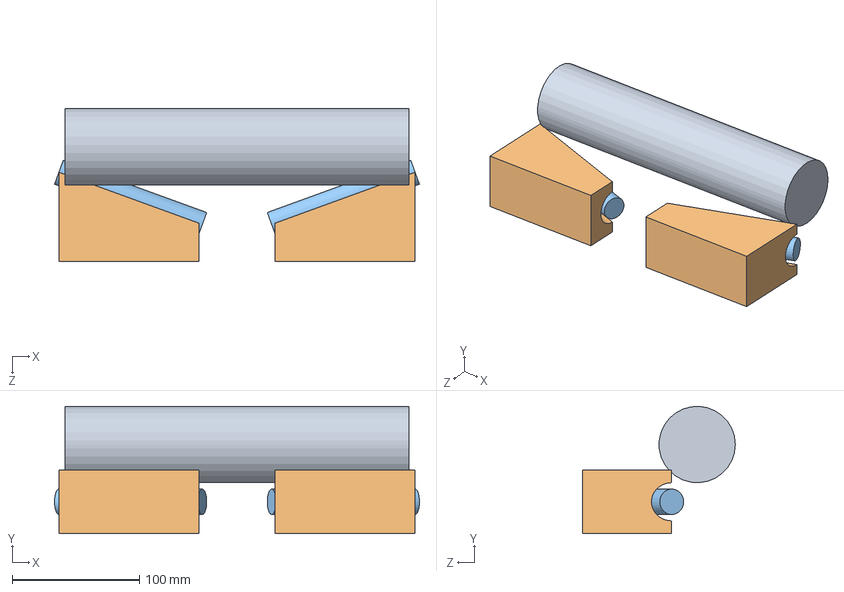
[picture p73: CAD file, 2013-06-06]
Hardware/Rough Layout/Collection Rough Assembly.SLDASM
286.8 x 100.0 x 120.0 mm
Brush - rough
Ball Guides - rough x 2
Ball Guide Roller - rough x 2
