rowan-walsh/BruteforceIgnorance/Hardware/Chassis/020 Collector Assembly.SLDASM

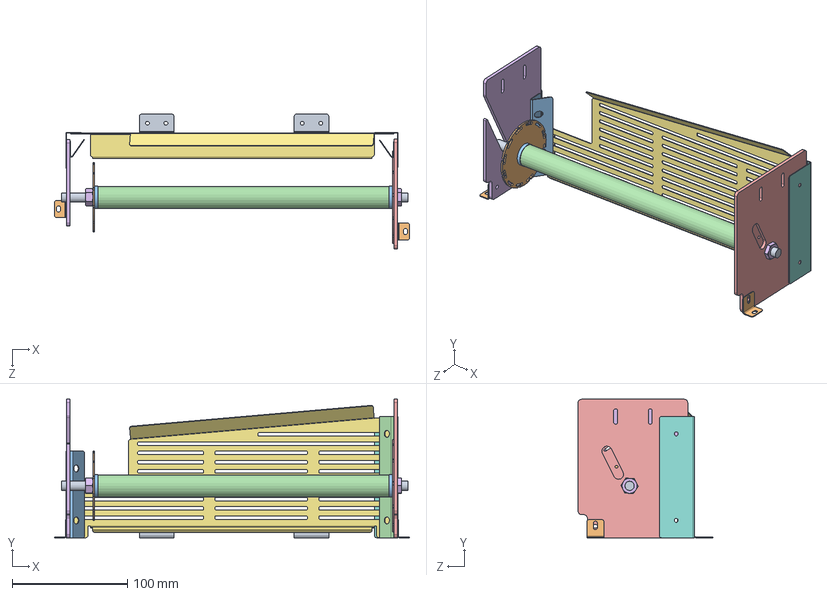
[picture p74: CAD file, 2013-07-26]
Hardware/Chassis/020 Collector Assembly.SLDASM
307.5 x 120.0 x 116.8 mm
Brush_Rod
Brush_Wheel_Small
Space Rod Cap x 2
Spacer Tube
Brush_Wheel_Tensioner
M8 Washer x 2
021 Collector Wall Back
031 Big Corner Flange
flange wall back x 2
flange wall side x 2
small corner guard
large corner guard
022 Brush Shaft Holder Large
023 Brush Shaft Holder Small
Small Corner Flange
