rowan-walsh/BruteforceIgnorance/Hardware/Internal Ball Handling/00 Ball Handler 2.SLDASM

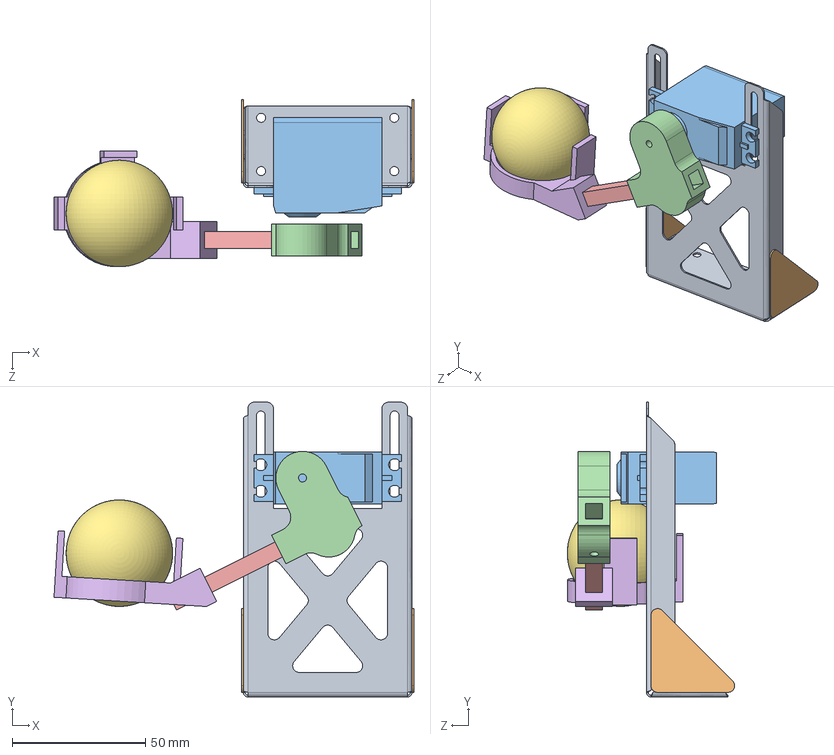
[picture p75: CAD file, 2013-07-30]
Hardware/Internal Ball Handling/00 Ball Handler 2.SLDASM
135.2 x 110.7 x 62.9 mm
Lifting Servo Bracket 2
Corner Brace x 2
Servo Futaba S3003
Arm-Servo Mount
Arm Rod
Arm Hoop
SquashBall
