rowan-walsh/BruteforceIgnorance/Hardware/Rough Layout/Rough Layout Assembly.SLDASM

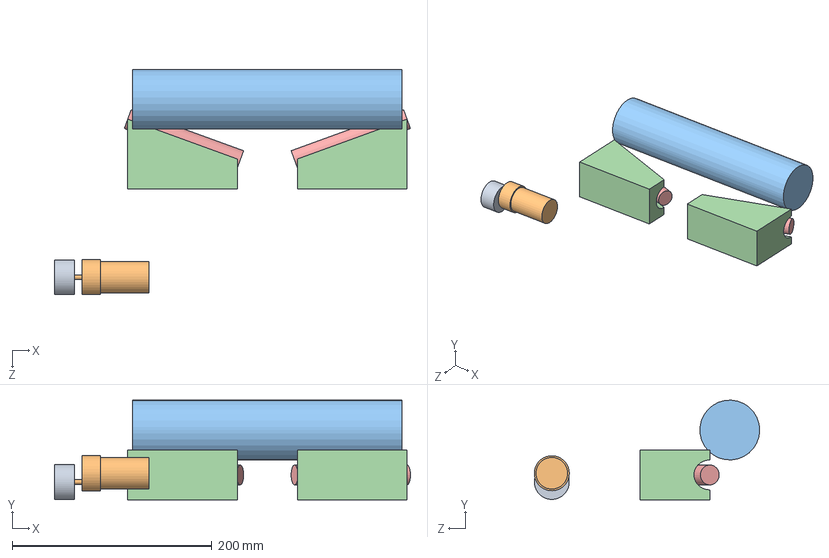
[picture p76: CAD file, 2013-06-06]
Hardware/Rough Layout/Rough Layout Assembly.SLDASM
356.8 x 100.0 x 225.9 mm
Wheel - rough
Motor Barber Coleman geared
Brush - rough
Ball Guides - rough x 2
Ball Guide Roller - rough x 2
