rowan-walsh/BruteforceIgnorance/Hardware/Firing mechanism/02 Motor Assembly.SLDASM

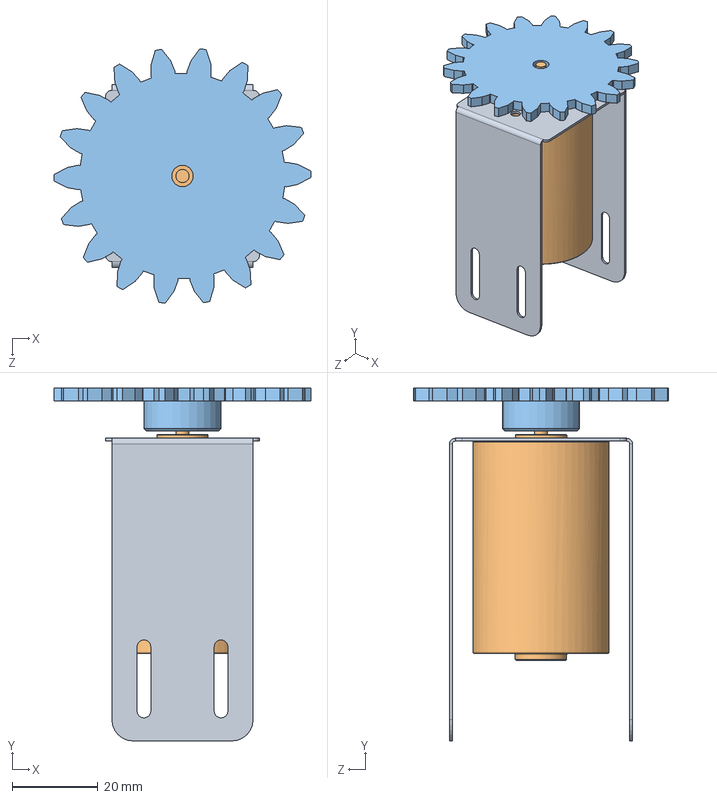
[picture p77: CAD file, 2013-07-05]
Hardware/Firing mechanism/02 Motor Assembly.SLDASM
60.0 x 82.4 x 59.4 mm
Upright Motor Bracket
Motor BarbCole Ungeared
Printed Motor-Roller Gear
