rowan-walsh/BruteforceIgnorance/Hardware/Internal Ball Handling/02 Arm Assembly.SLDASM

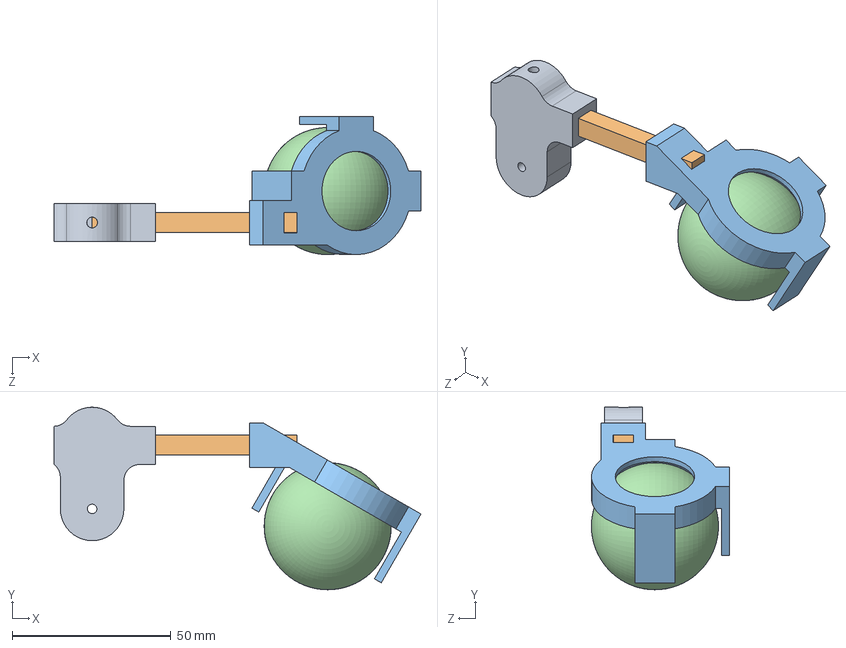
[picture p78: CAD file, 2013-07-16]
Hardware/Internal Ball Handling/02 Arm Assembly.SLDASM
115.5 x 57.4 x 43.5 mm
Arm-Servo Mount
Arm Rod
Arm Hoop
SquashBall
