rowan-walsh/BruteforceIgnorance/Hardware/Electrical Mounting/main vertical support.SLDPRT

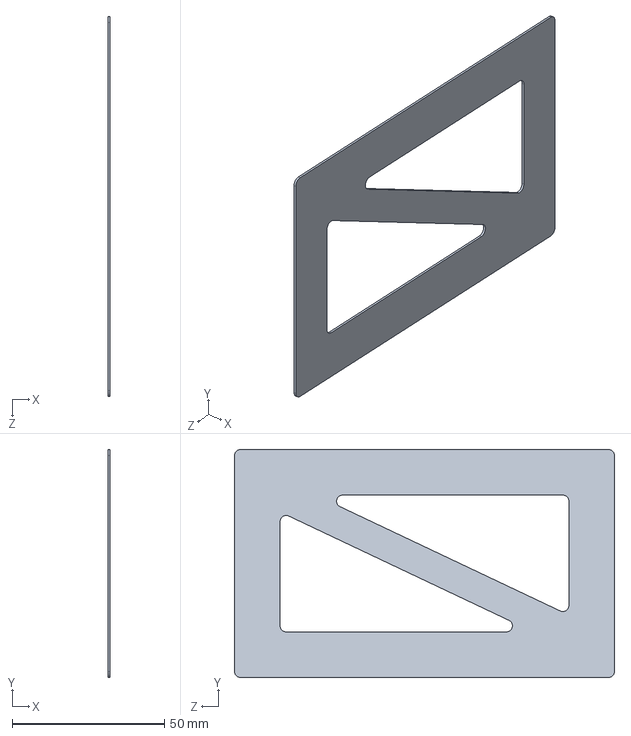
[picture p79: CAD file, 2013-06-26]
Hardware/Electrical Mounting/main vertical support.SLDPRT
0.7 x 75.0 x 125.0 mm
