rowan-walsh/BruteforceIgnorance/Hardware/Mars Rover Wheels/01 4inch Turntable Assembly.SLDASM

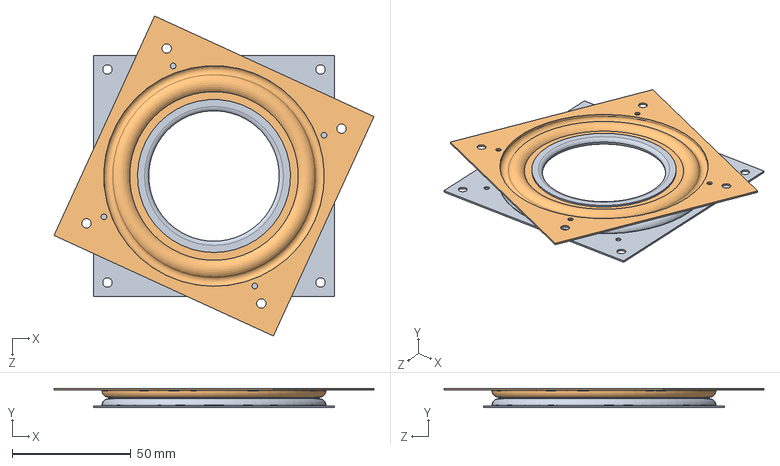
[picture p80: CAD file, 2013-06-16]
Hardware/Mars Rover Wheels/01 4inch Turntable Assembly.SLDASM
134.7 x 8.13 x 134.7 mm
4inch Turntable Bottom
4inch Turntable Top
