rowan-walsh/BruteforceIgnorance/Hardware/Internal Ball Handling/01 Lifting Assembly.SLDASM

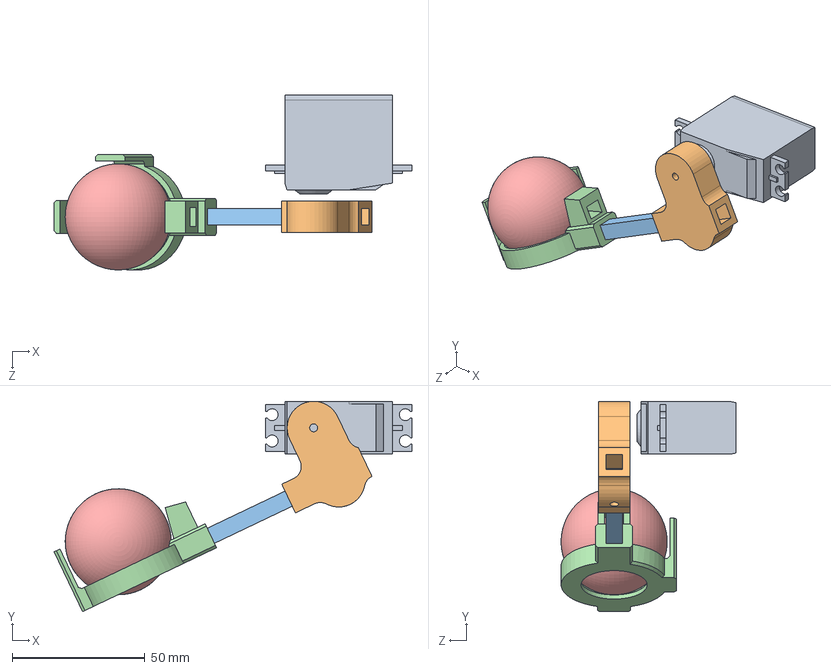
[picture p81: CAD file, 2013-07-11]
Hardware/Internal Ball Handling/01 Lifting Assembly.SLDASM
135.0 x 79.3 x 65.9 mm
Servo Futaba S3003
Arm-Servo Mount
Arm Rod
Arm Hoop
SquashBall
