rowan-walsh/BruteforceIgnorance/Hardware/Internal Ball Handling/00 Ball Handler.SLDASM

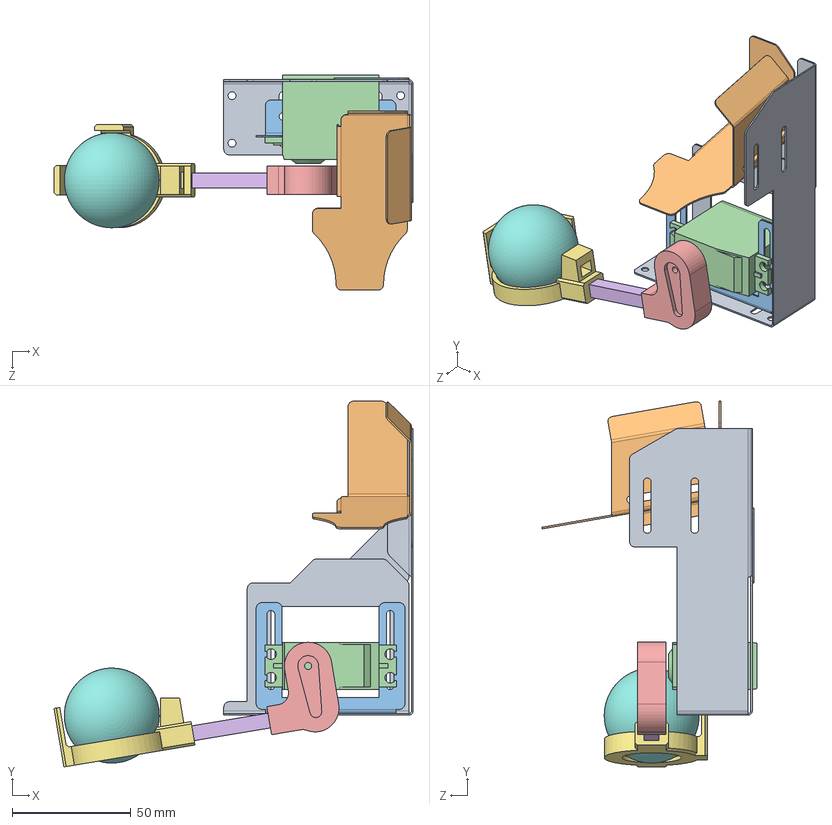
[picture p82: CAD file, 2013-07-09]
Hardware/Internal Ball Handling/00 Ball Handler.SLDASM
151.1 x 154.1 x 90.7 mm
Base Plate
Upper Ramp
Lifting Servo Bracket
Servo Futaba S3003
Arm-Servo Mount
Arm Rod
Arm Hoop
SquashBall
Corner Brace
