rowan-walsh/BruteforceIgnorance/Hardware/Ball Collector/Omni_Bearing.SLDASM

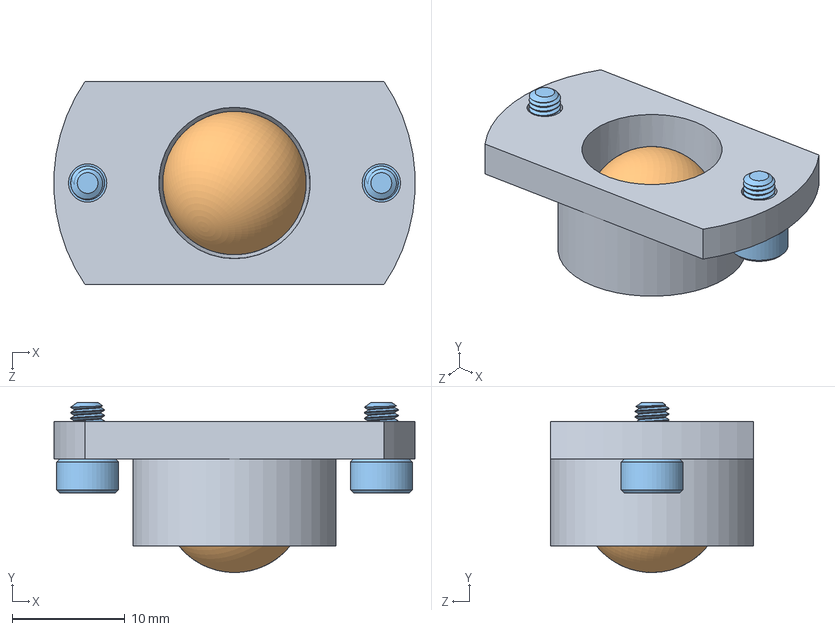
[picture p83: CAD file, 2013-06-25]
Hardware/Ball Collector/Omni_Bearing.SLDASM
32.0 x 15.0 x 18.0 mm
Omni_Bearing_Holder
Ball Bearing 1cm
Screw SC M3 x 5 x 2
