rowan-walsh/BruteforceIgnorance/Hardware/Firing mechanism/Roller Assembly.SLDASM

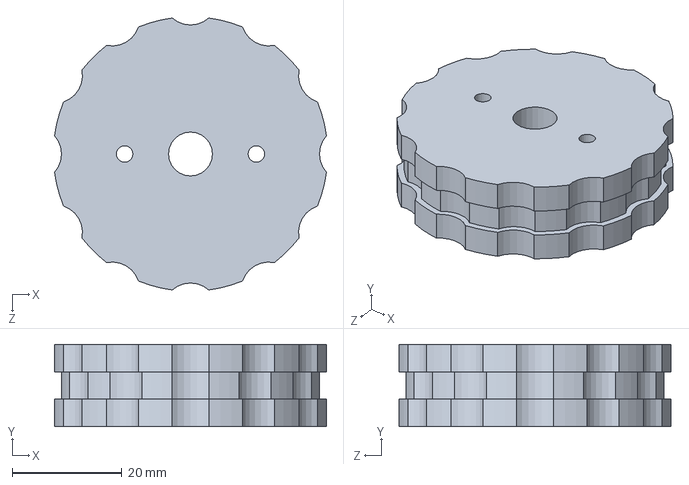
[picture p84: CAD file, 2013-06-15]
Hardware/Firing mechanism/Roller Assembly.SLDASM
49.6 x 15.0 x 49.6 mm
Roller Section x 3
