rowan-walsh/BruteforceIgnorance/Hardware/Ball Collector/Fancy Brush Assembly.SLDASM

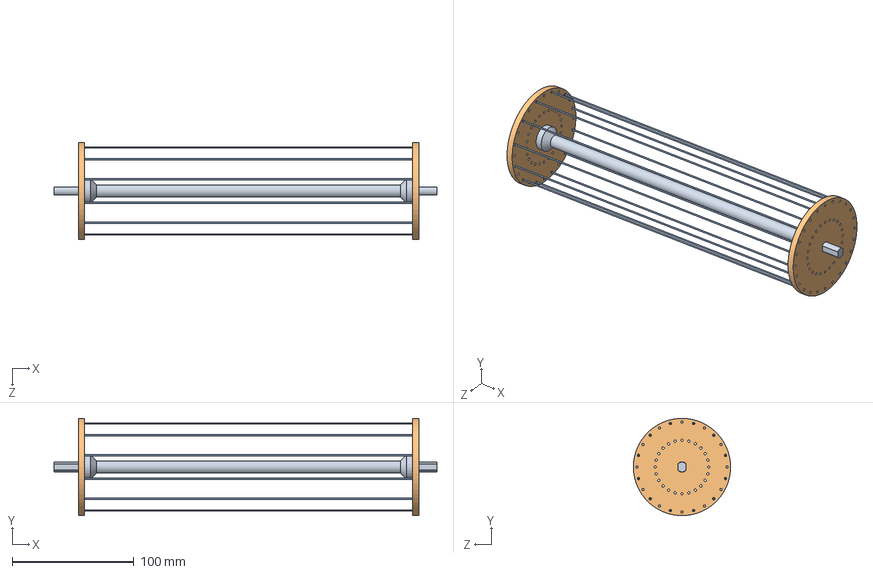
[picture p85: CAD file, 2013-06-09]
Hardware/Ball Collector/Fancy Brush Assembly.SLDASM
315.0 x 80.0 x 80.0 mm
Brush Axle
Brush Wheel x 2
String x 12
