rowan-walsh/BruteforceIgnorance/Base Plate.SLDPRT

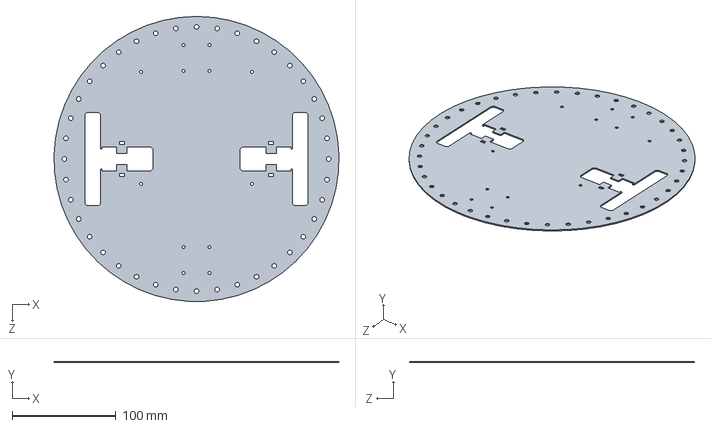
[picture p86: CAD file, 2013-06-01]
Base Plate.SLDPRT
274.9 x 1.20 x 275.0 mm
