rowan-walsh/BruteforceIgnorance/Enviroment/SquashBall.SLDPRT

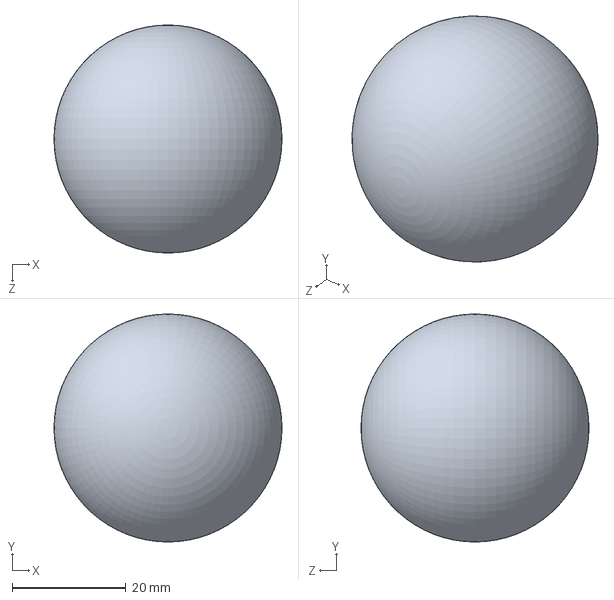
[picture p87: CAD file, 2013-06-17]
Enviroment/SquashBall.SLDPRT
40.0 x 40.0 x 40.0 mm
