rowan-walsh/BruteforceIgnorance/Hardware/Ball Collector/Brush Drive Motor Mount.SLDPRT

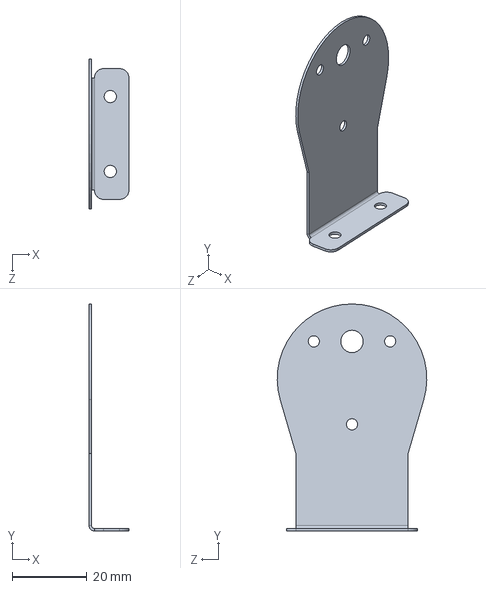
[picture p88: CAD file, 2013-07-31]
Hardware/Ball Collector/Brush Drive Motor Mount.SLDPRT
10.7 x 60.7 x 40.0 mm
