rowan-walsh/BruteforceIgnorance/Hardware/Chassis/Small Corner Flange.SLDPRT

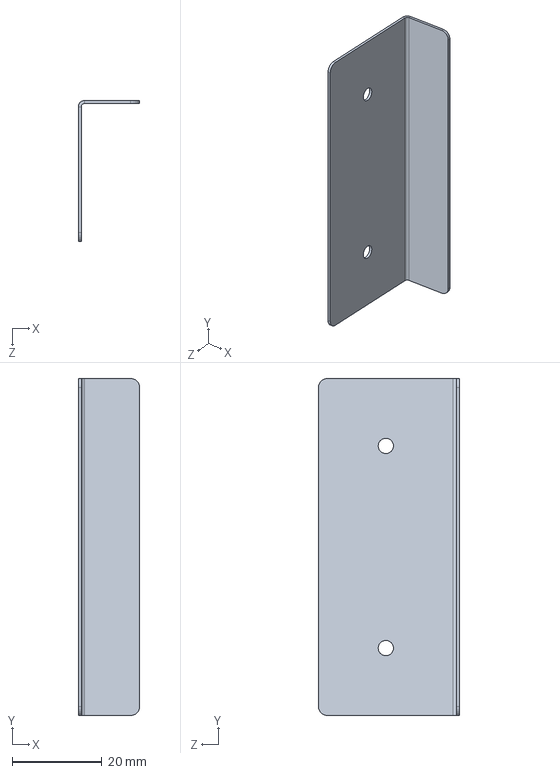
[picture p89: CAD file, 2013-07-26]
Hardware/Chassis/Small Corner Flange.SLDPRT
13.7 x 75.0 x 31.4 mm
