rowan-walsh/BruteforceIgnorance/Hardware/Deployable Microswitch holder/DeployableMicroswitchHolder.SLDPRT

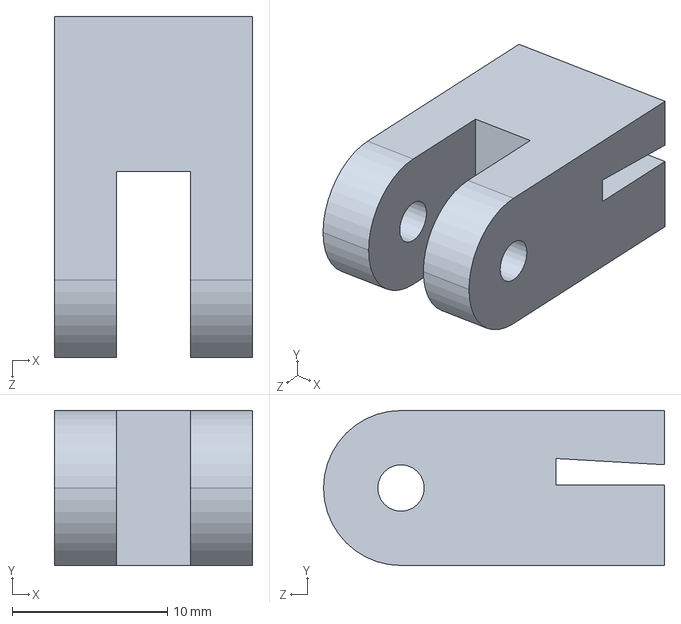
[picture p90: CAD file, 2013-08-06]
Hardware/Deployable Microswitch holder/DeployableMicroswitchHolder.SLDPRT
12.8 x 10.0 x 22.0 mm
