rowan-walsh/BruteforceIgnorance/Hardware/Electrical Mounting/Capacitor mount.SLDPRT

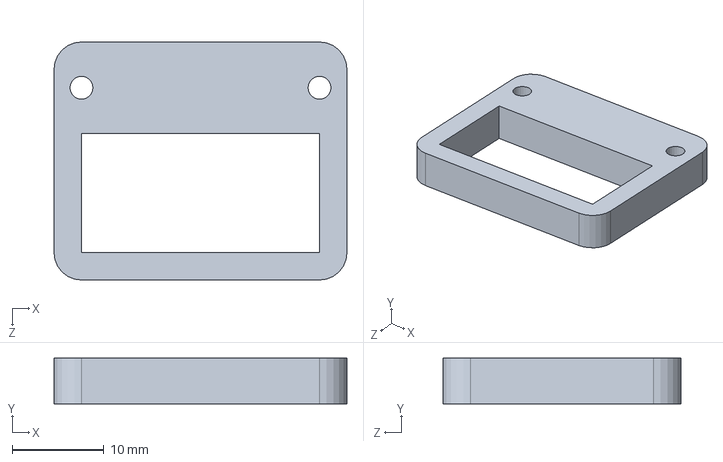
[picture p91: CAD file, 2013-08-07]
Hardware/Electrical Mounting/Capacitor mount.SLDPRT
32.0 x 5.00 x 26.0 mm
