rowan-walsh/BruteforceIgnorance/Hardware/Firing mechanism/Camshaft loader/Pusher.SLDPRT

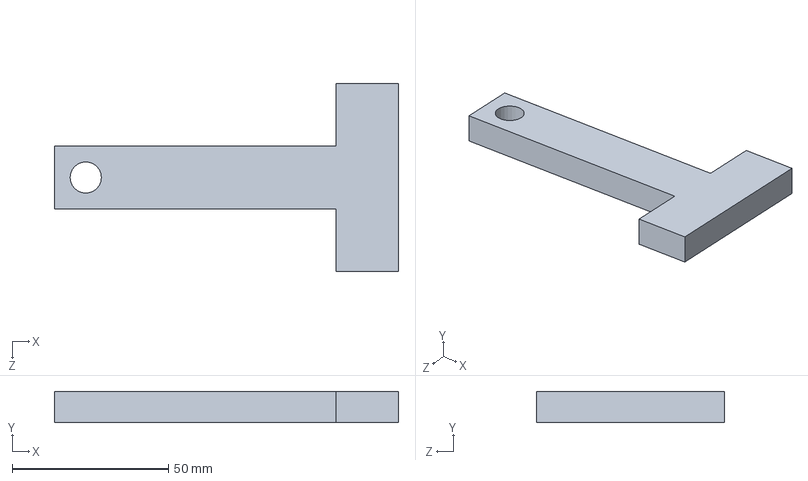
[picture p92: CAD file, 2013-06-15]
Hardware/Firing mechanism/Camshaft loader/Pusher.SLDPRT
110.0 x 10.0 x 60.0 mm
