rowan-walsh/BruteforceIgnorance/Hardware/Firing mechanism/Kicker Tests/Kicker arm test bed.SLDPRT

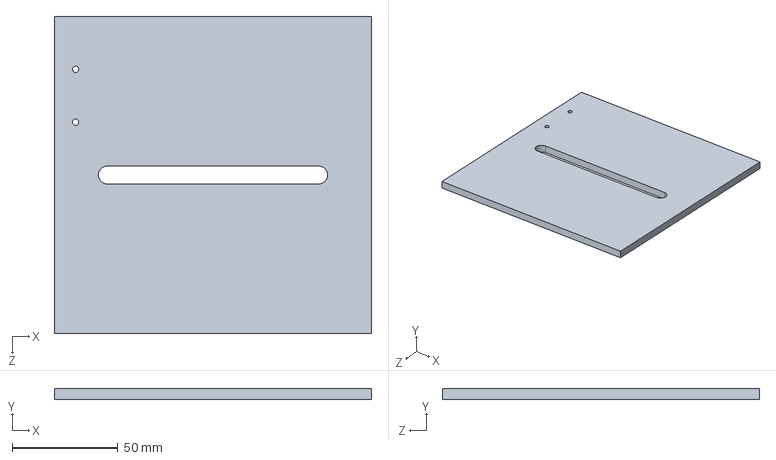
[picture p93: CAD file, 2013-06-15]
Hardware/Firing mechanism/Kicker Tests/Kicker arm test bed.SLDPRT
150.0 x 5.00 x 150.0 mm
