rowan-walsh/BruteforceIgnorance/Hardware/Internal Ball Handling/Lower Ramp 5.SLDPRT

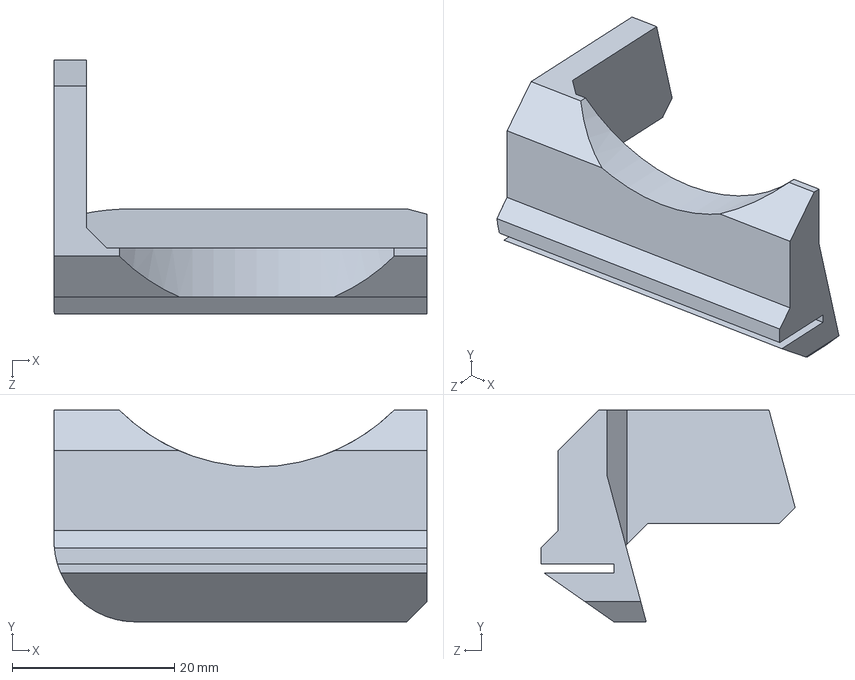
[picture p94: CAD file, 2013-08-06]
Hardware/Internal Ball Handling/Lower Ramp 5.SLDPRT
46.0 x 26.1 x 31.4 mm
