rowan-walsh/BruteforceIgnorance/Hardware/IR Sensor/IR Box Bottom.SLDPRT

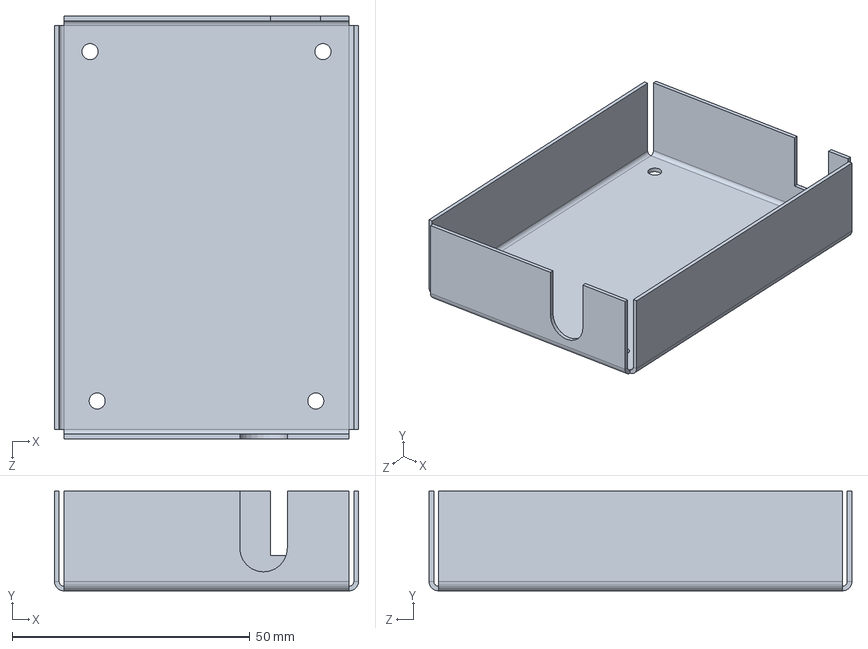
[picture p95: CAD file, 2013-08-08]
Hardware/IR Sensor/IR Box Bottom.SLDPRT
64.0 x 21.0 x 89.0 mm
