rowan-walsh/BruteforceIgnorance/Hardware/Mars Rover Wheels/Lower Turntable Gear.SLDPRT

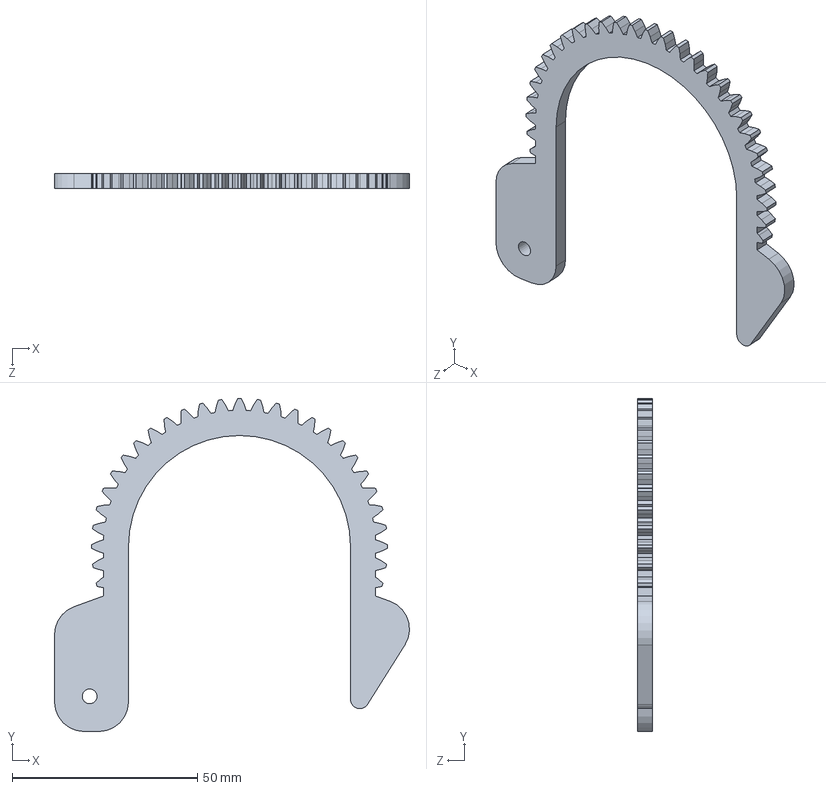
[picture p96: CAD file, 2013-08-06]
Hardware/Mars Rover Wheels/Lower Turntable Gear.SLDPRT
95.9 x 90.0 x 4.00 mm
