rowan-walsh/BruteforceIgnorance/Hardware/Microswitch holder/MicroswitchHolder.SLDPRT

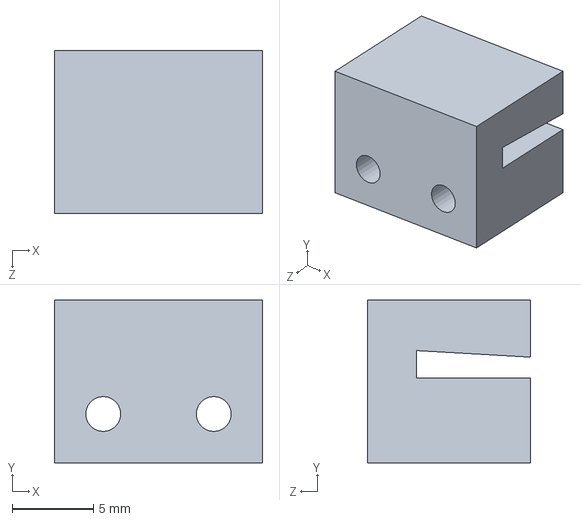
[picture p97: CAD file, 2013-07-31]
Hardware/Microswitch holder/MicroswitchHolder.SLDPRT
12.8 x 10.0 x 10.0 mm
