rowan-walsh/BruteforceIgnorance/Hardware/Rough Layout/Ball Guide 2 - rough.SLDPRT

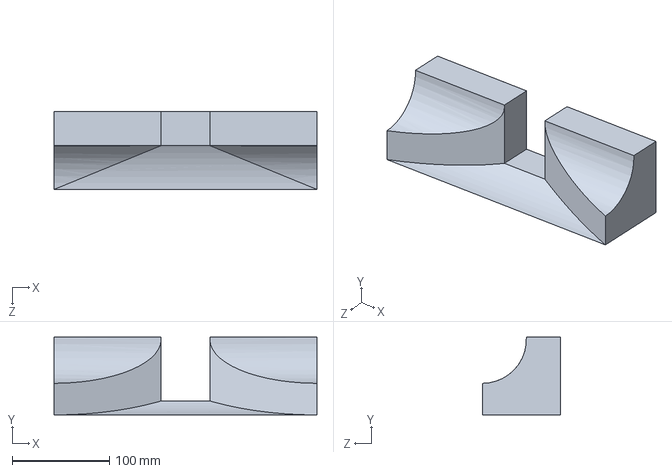
[picture p98: CAD file, 2013-06-09]
Hardware/Rough Layout/Ball Guide 2 - rough.SLDPRT
270.0 x 80.0 x 80.0 mm
