rowan-walsh/BruteforceIgnorance/Hardware/Supplied Component Models/Motor BarbCole Ungeared.SLDPRT

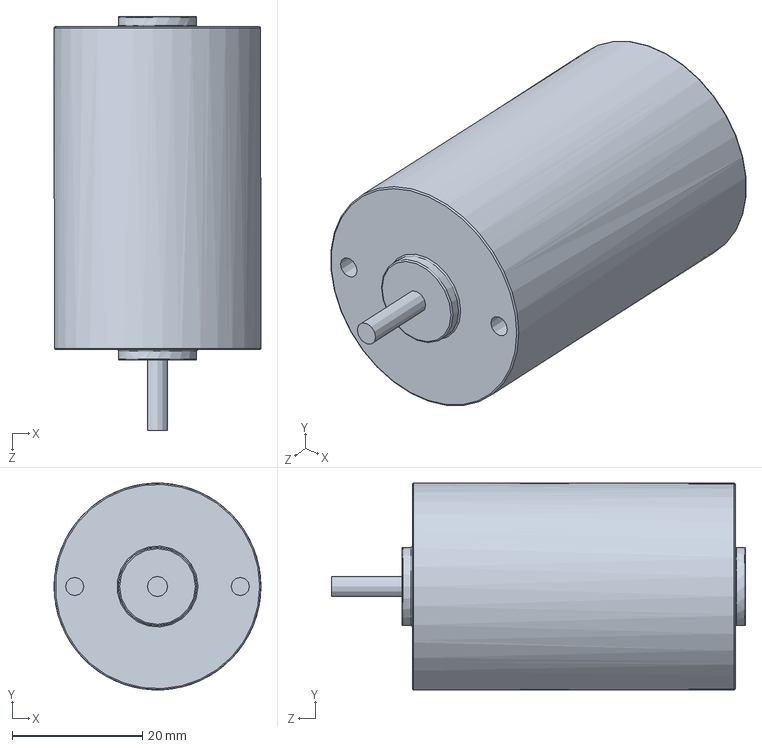
[picture p99: CAD file, 2013-06-25]
Hardware/Supplied Component Models/Motor BarbCole Ungeared.SLDPRT
31.8 x 31.7 x 63.6 mm
