rowan-walsh/BruteforceIgnorance/Hardware/Supplied Component Models/Servo/Servo Futaba S3003.SLDPRT

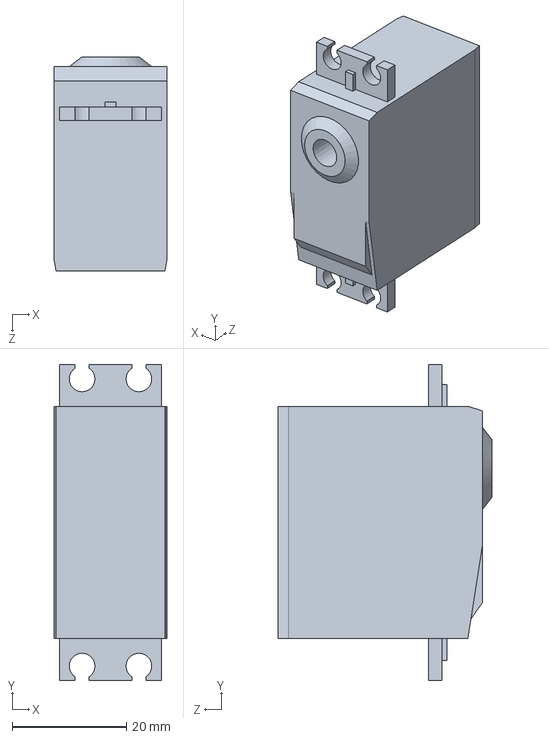
[picture p100: CAD file, 2013-07-06]
Hardware/Supplied Component Models/Servo/Servo Futaba S3003.SLDPRT
19.7 x 55.3 x 37.4 mm
