rowan-walsh/BruteforceIgnorance/Enviroment/Official Play Surface/side shape 19mm.SLDPRT

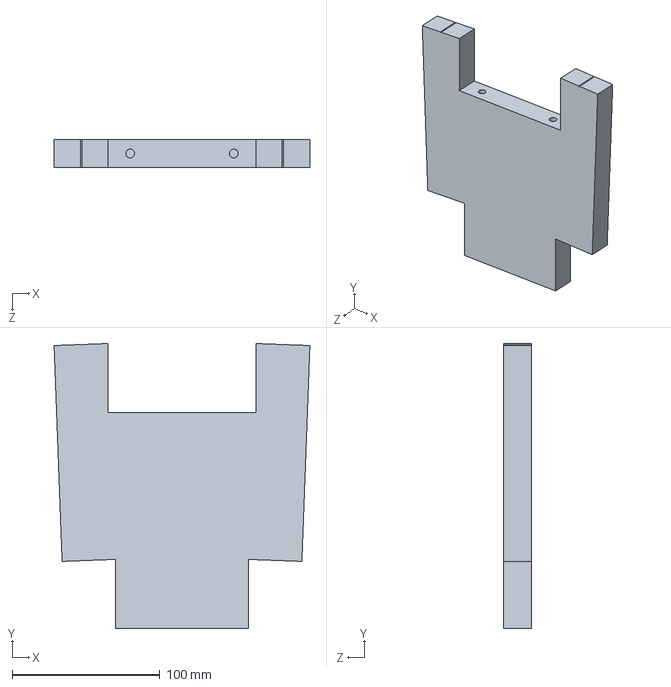
[picture p101: CAD file, 2013-06-11]
Enviroment/Official Play Surface/side shape 19mm.SLDPRT
173.0 x 192.7 x 19.0 mm
