rowan-walsh/BruteforceIgnorance/Enviroment/PlaySurfaceToScale.SLDPRT

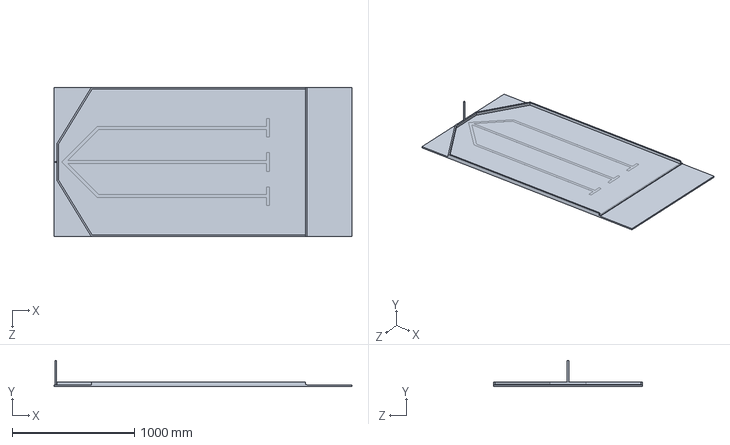
[picture p102: CAD file, 2013-06-01]
Enviroment/PlaySurfaceToScale.SLDPRT
2438.4 x 215.9 x 1219.2 mm
