rowan-walsh/BruteforceIgnorance/Hardware/Chassis/Firing Support Support.SLDPRT

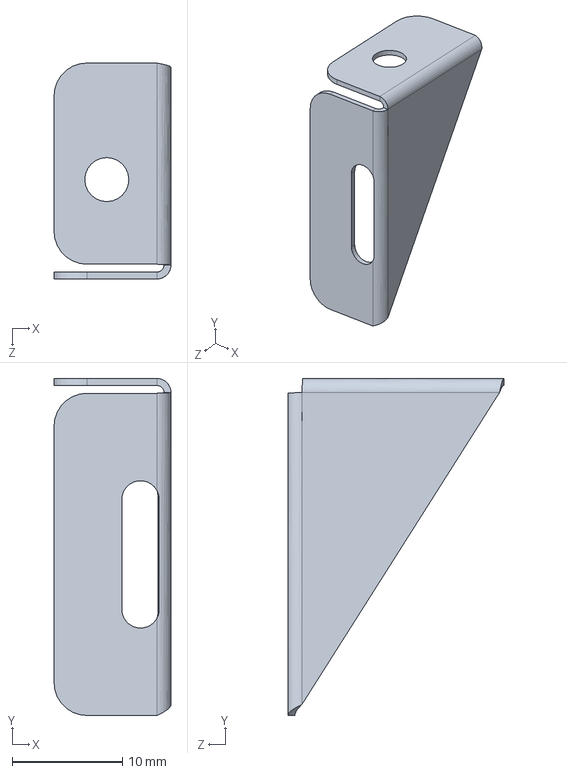
[picture p103: CAD file, 2013-07-26]
Hardware/Chassis/Firing Support Support.SLDPRT
10.6 x 30.6 x 19.6 mm
