rowan-walsh/BruteforceIgnorance/Hardware/Deployable Microswitch holder/DeployableMicroswitch.SLDPRT

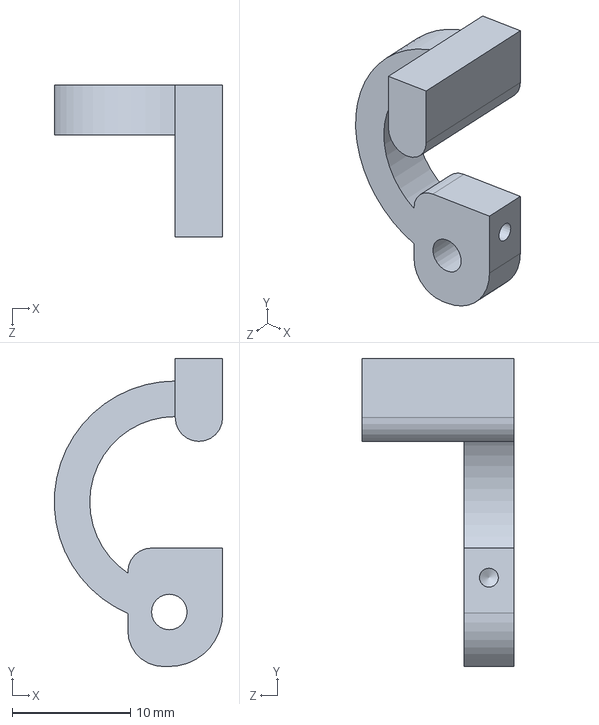
[picture p104: CAD file, 2013-08-06]
Hardware/Deployable Microswitch holder/DeployableMicroswitch.SLDPRT
14.2 x 26.0 x 12.8 mm
