rowan-walsh/BruteforceIgnorance/Hardware/Electrical Mounting/Regulator mount.SLDPRT

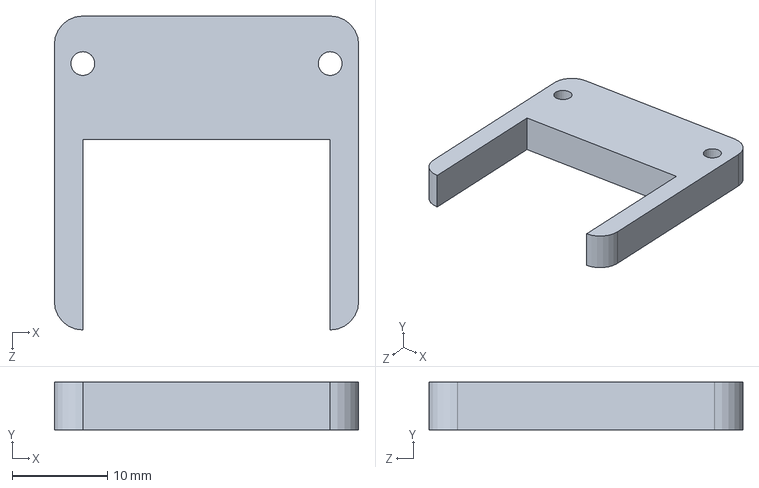
[picture p105: CAD file, 2013-08-07]
Hardware/Electrical Mounting/Regulator mount.SLDPRT
32.0 x 5.00 x 33.0 mm
