rowan-walsh/BruteforceIgnorance/Hardware/Firing mechanism/Camshaft loader/Shaft.SLDPRT

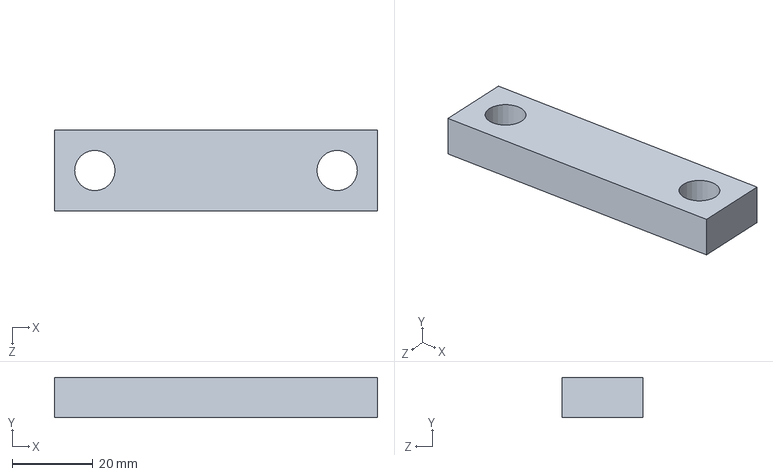
[picture p106: CAD file, 2013-06-15]
Hardware/Firing mechanism/Camshaft loader/Shaft.SLDPRT
80.0 x 10.0 x 20.0 mm
