rowan-walsh/BruteforceIgnorance/Hardware/Firing mechanism/Kicker Tests/Kicker arm.SLDPRT

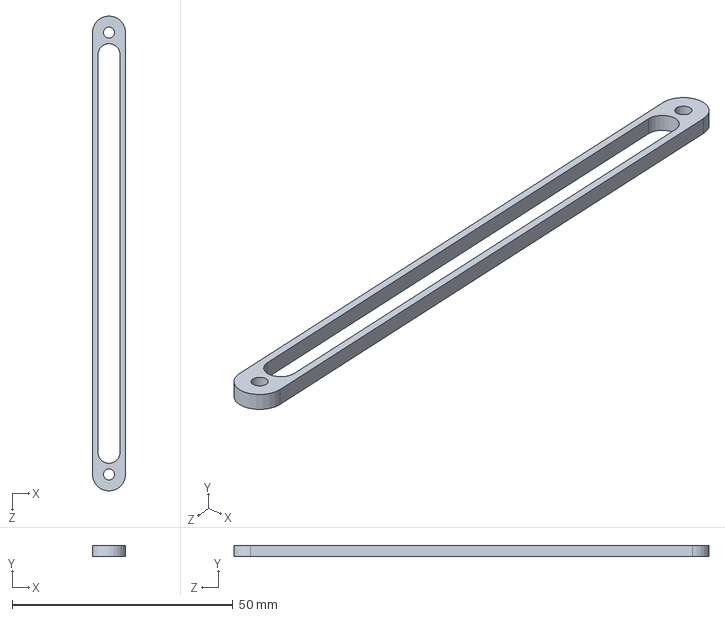
[picture p107: CAD file, 2013-06-15]
Hardware/Firing mechanism/Kicker Tests/Kicker arm.SLDPRT
7.50 x 2.50 x 107.5 mm
