rowan-walsh/BruteforceIgnorance/Hardware/Internal Ball Handling/Breakbeam Laser Holder.SLDPRT

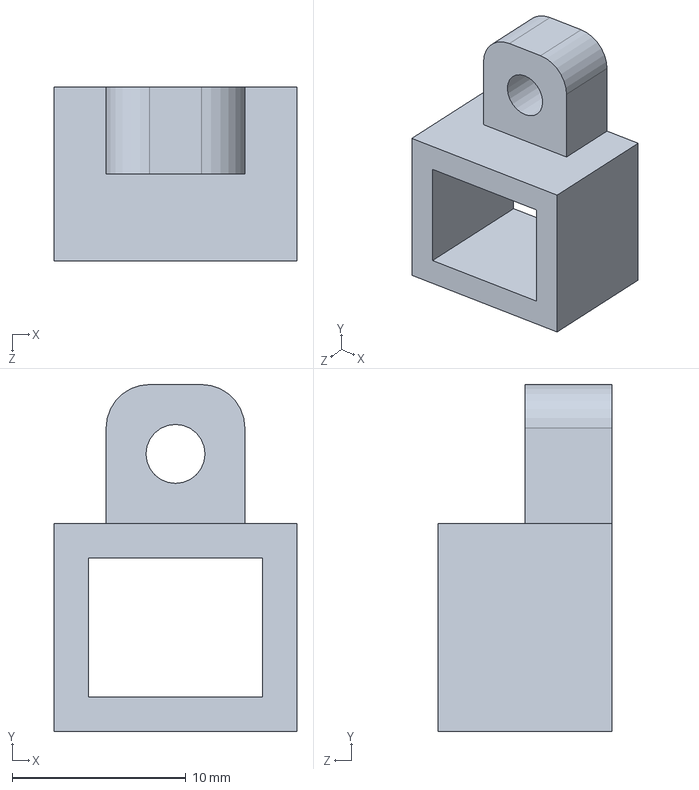
[picture p108: CAD file, 2013-08-02]
Hardware/Internal Ball Handling/Breakbeam Laser Holder.SLDPRT
14.0 x 20.0 x 10.0 mm
