rowan-walsh/BruteforceIgnorance/Hardware/IR Sensor/OP 805 Blinder/GLaDOS blinder.SLDPRT

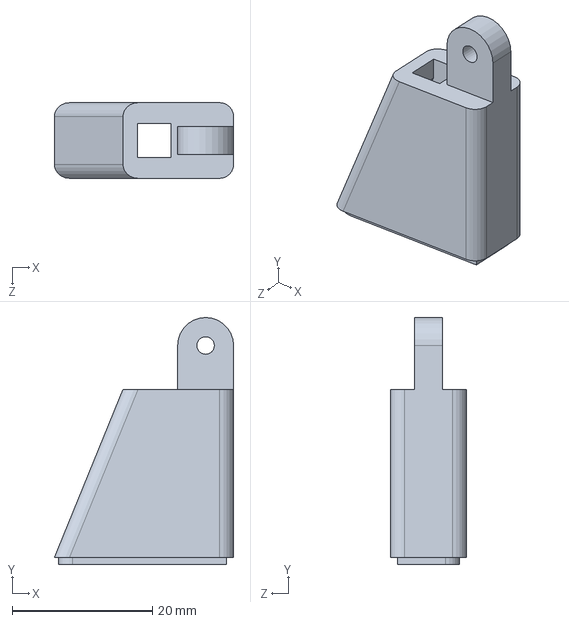
[picture p109: CAD file, 2013-07-30]
Hardware/IR Sensor/OP 805 Blinder/GLaDOS blinder.SLDPRT
25.6 x 35.2 x 10.8 mm
