rowan-walsh/BruteforceIgnorance/Hardware/Laser range finder/Laser Range Finder.SLDPRT

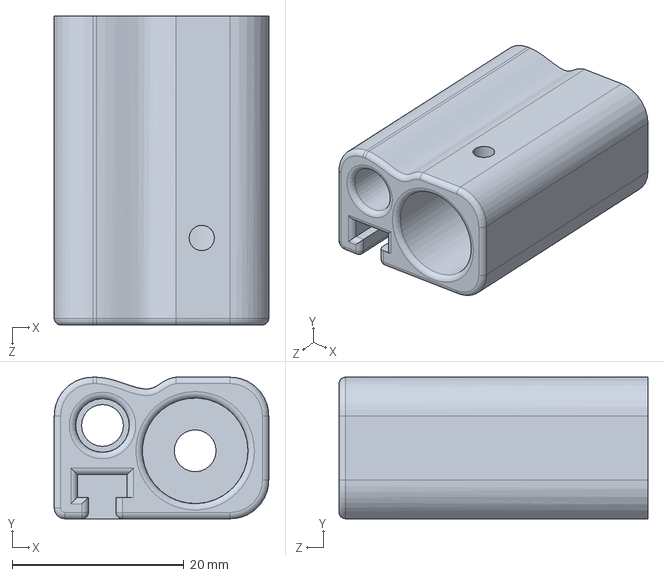
[picture p110: CAD file, 2013-06-26]
Hardware/Laser range finder/Laser Range Finder.SLDPRT
25.0 x 16.5 x 36.0 mm
