rowan-walsh/BruteforceIgnorance/Hardware/Rough Layout/String Wheel.DXF

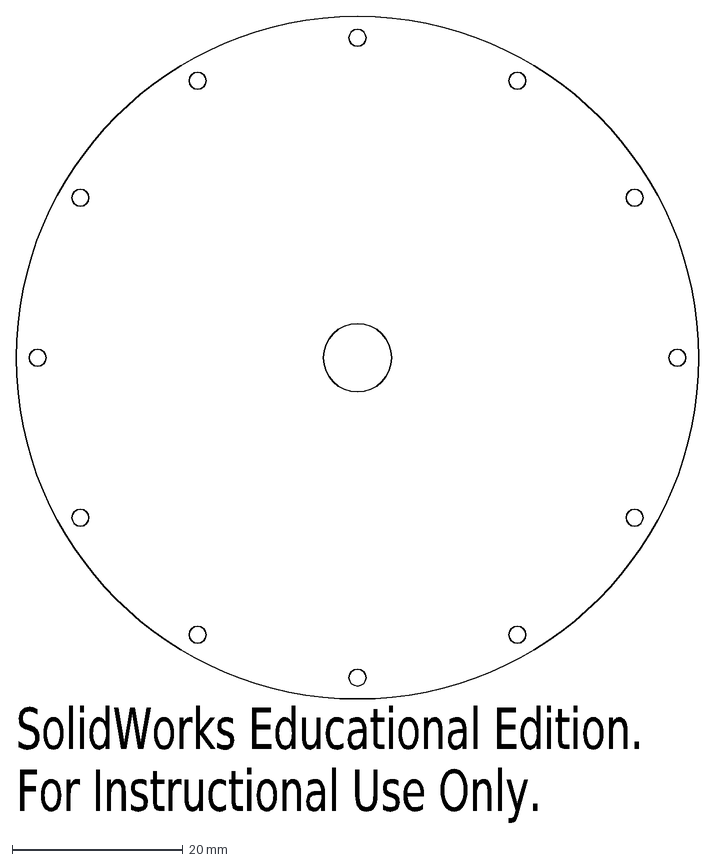
[picture p111: CAD file, 2013-06-08]
Hardware/Rough Layout/String Wheel.DXF
SolidWorks Educational Edition.
For Instructional Use Only.
