rowan-walsh/BruteforceIgnorance/Hardware/Supplied Component Models/Servo/Servo Rotor.SLDPRT

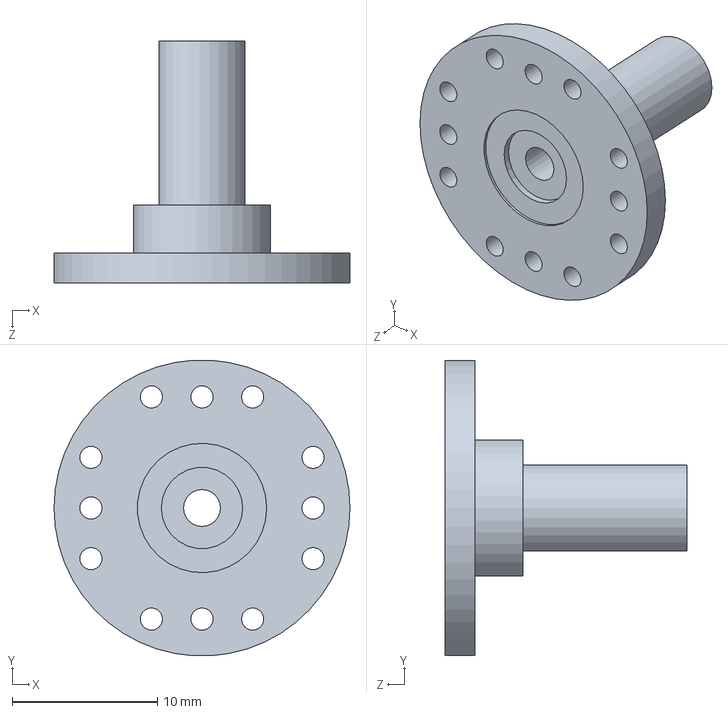
[picture p112: CAD file, 2013-06-15]
Hardware/Supplied Component Models/Servo/Servo Rotor.SLDPRT
20.3 x 20.3 x 16.7 mm
