rowan-walsh/BruteforceIgnorance/Hardware/Supplied Component Models/solarbotics_gm2_solid_models/Solarbotics gm2.STL

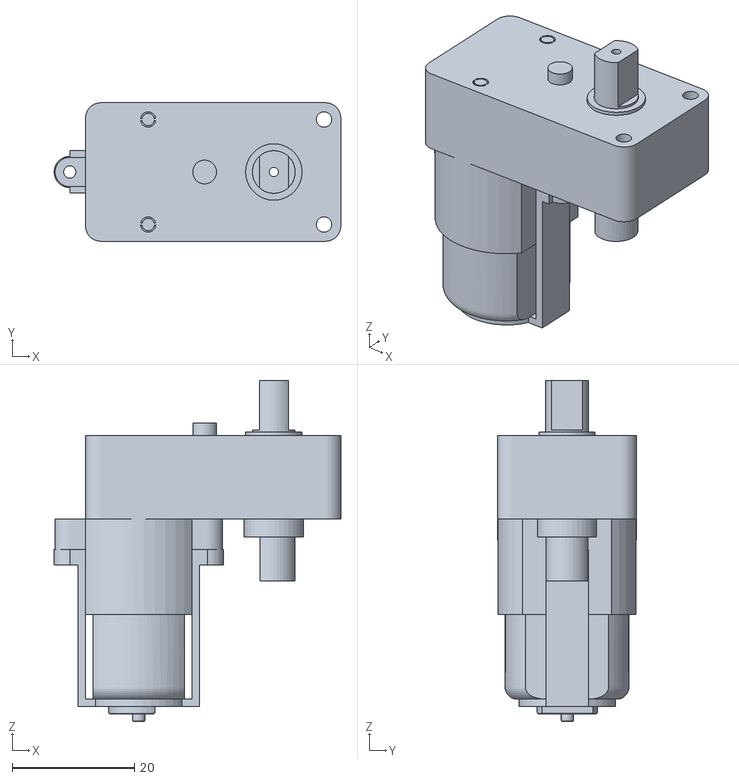
[picture p113: CAD file, 2013-05-31]
Hardware/Supplied Component Models/solarbotics_gm2_solid_models/Solarbotics gm2.STL
46.9 x 22.7 x 55.8
