rowan-walsh/BruteforceIgnorance/Hardware/Supplied Component Models/Tinah Board representation.SLDPRT

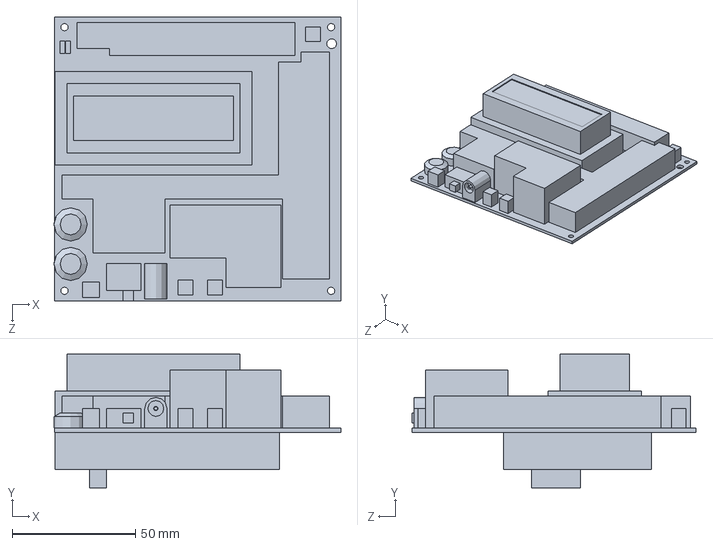
[picture p114: CAD file, 2013-06-16]
Hardware/Supplied Component Models/Tinah Board representation.SLDPRT
116.2 x 54.2 x 115.0 mm
