rowan-walsh/BruteforceIgnorance/Rough Shape 2.SLDPRT

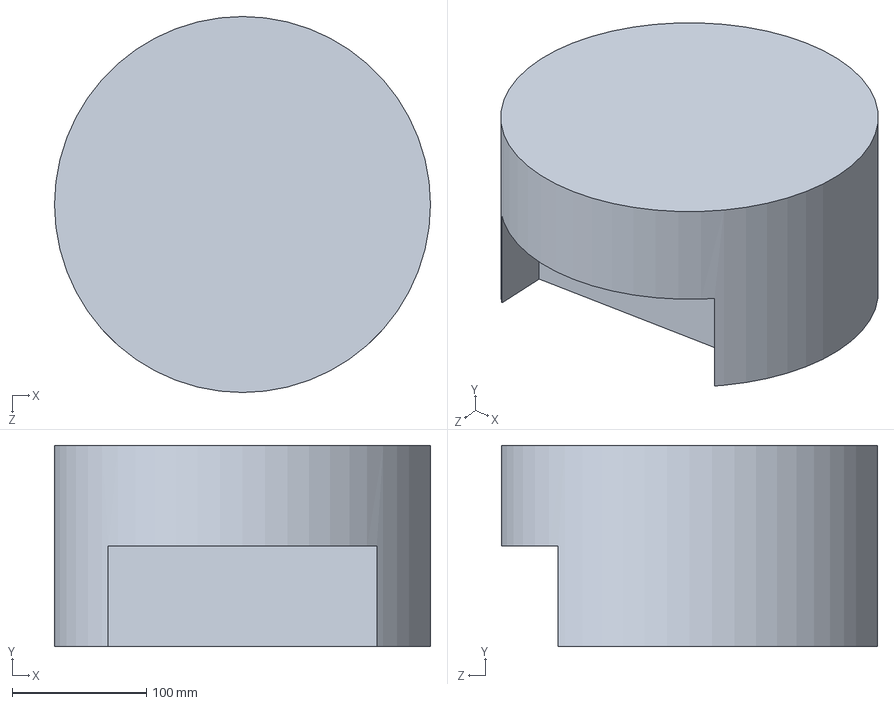
[picture p115: CAD file, 2013-05-31]
Rough Shape 2.SLDPRT
280.0 x 150.0 x 280.0 mm
