rowan-walsh/BruteforceIgnorance/Enviroment/Official Play Surface/LED holder 1.SLDPRT

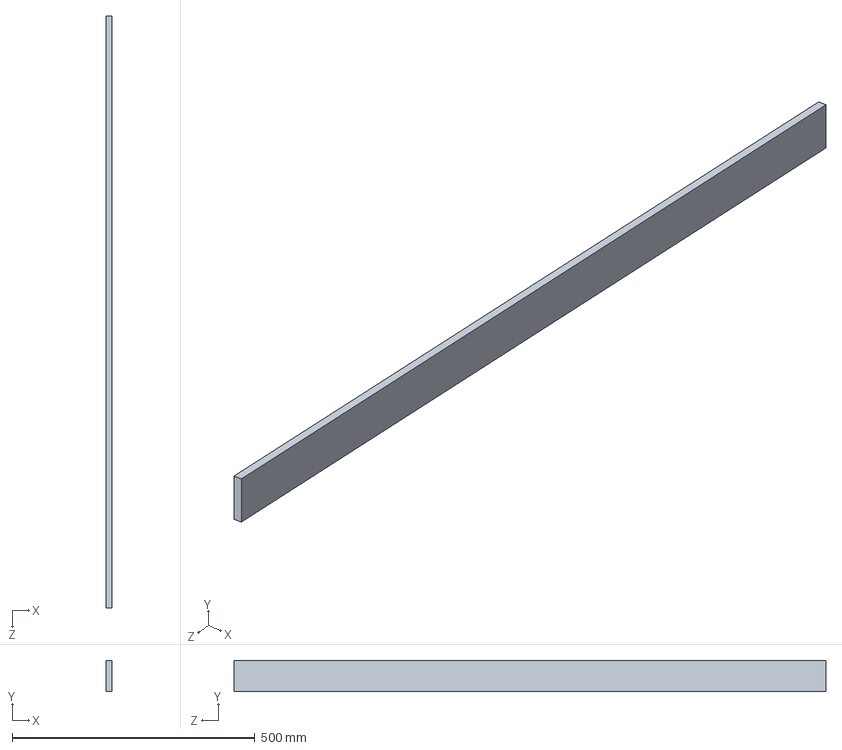
[picture p116: CAD file, 2013-06-11]
Enviroment/Official Play Surface/LED holder 1.SLDPRT
12.0 x 64.0 x 1220.0 mm
