rowan-walsh/BruteforceIgnorance/Hardware/Ball Collector/Brush_Rod.SLDPRT

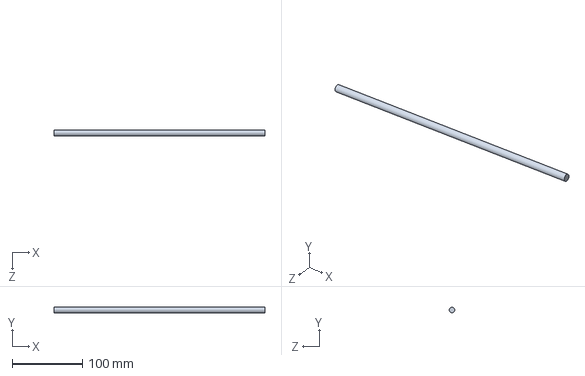
[picture p117: CAD file, 2013-07-25]
Hardware/Ball Collector/Brush_Rod.SLDPRT
300.0 x 8.00 x 8.00 mm
