rowan-walsh/BruteforceIgnorance/Hardware/Chassis/031 Big Corner Flange.SLDPRT

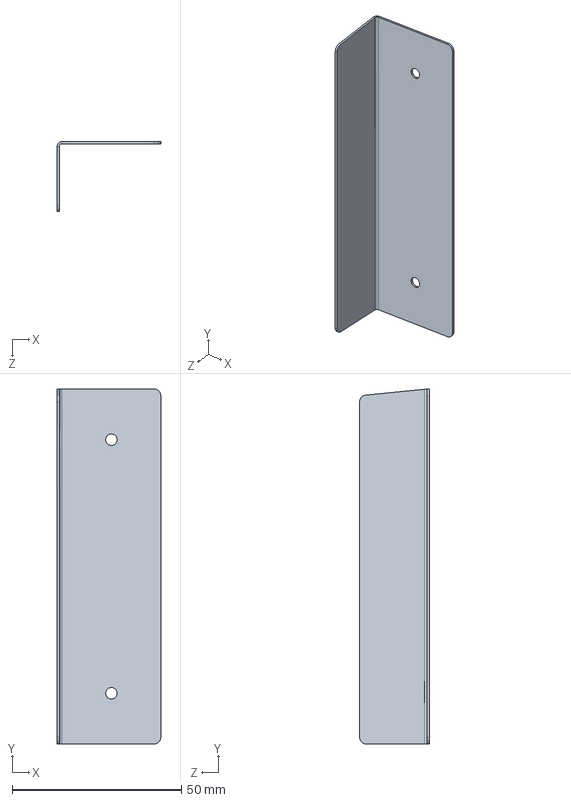
[picture p118: CAD file, 2013-07-26]
Hardware/Chassis/031 Big Corner Flange.SLDPRT
30.7 x 105.0 x 20.7 mm
