rowan-walsh/BruteforceIgnorance/Hardware/Electrical Mounting/Touch Sensor Button.SLDPRT

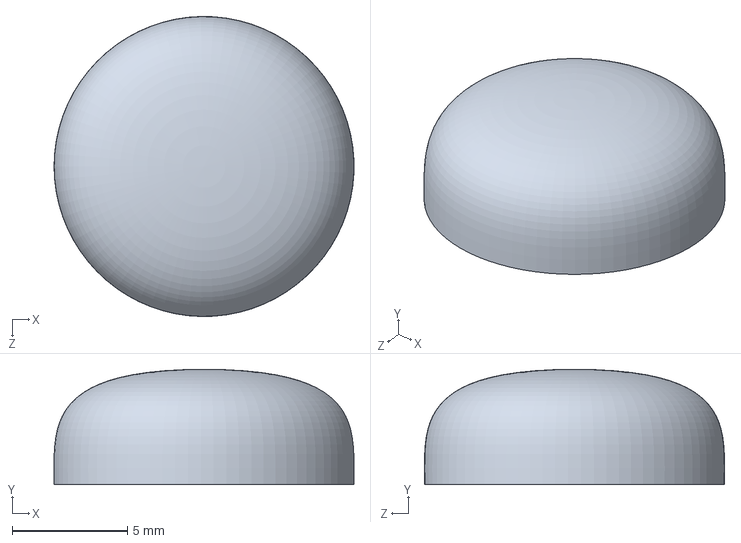
[picture p119: CAD file, 2013-08-02]
Hardware/Electrical Mounting/Touch Sensor Button.SLDPRT
13.0 x 5.00 x 13.0 mm
