rowan-walsh/BruteforceIgnorance/Hardware/Ferris Wheel/Containment Plate.SLDPRT

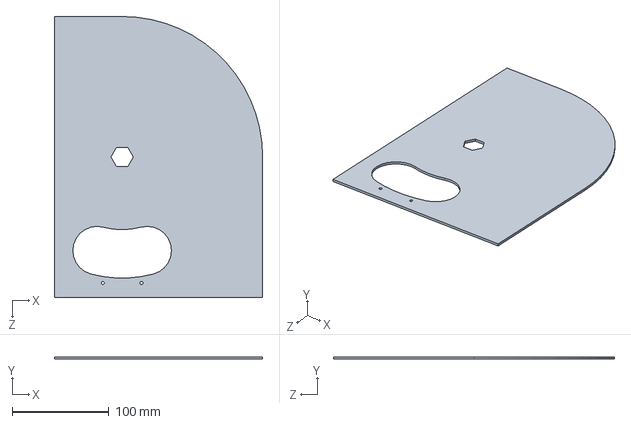
[picture p120: CAD file, 2013-06-09]
Hardware/Ferris Wheel/Containment Plate.SLDPRT
215.0 x 2.50 x 290.0 mm
