rowan-walsh/BruteforceIgnorance/Hardware/Firing mechanism/Roller Bracket.SLDPRT

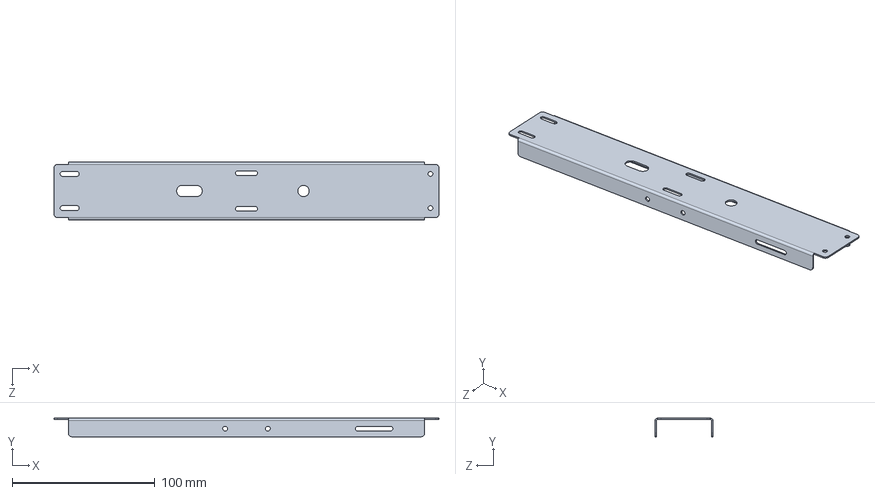
[picture p121: CAD file, 2013-07-26]
Hardware/Firing mechanism/Roller Bracket.SLDPRT
270.0 x 13.0 x 40.7 mm
