rowan-walsh/BruteforceIgnorance/Hardware/Internal Ball Handling/Breakbeam OP805 Holder.SLDPRT

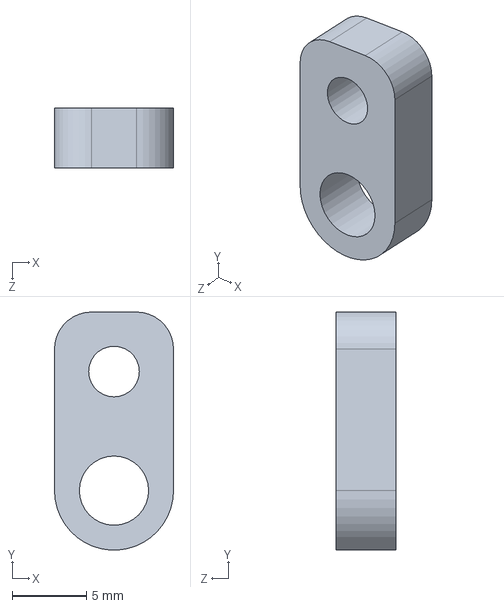
[picture p122: CAD file, 2013-08-02]
Hardware/Internal Ball Handling/Breakbeam OP805 Holder.SLDPRT
8.00 x 16.0 x 4.00 mm
