rowan-walsh/BruteforceIgnorance/Hardware/IR Sensor/IR Box Top.SLDPRT

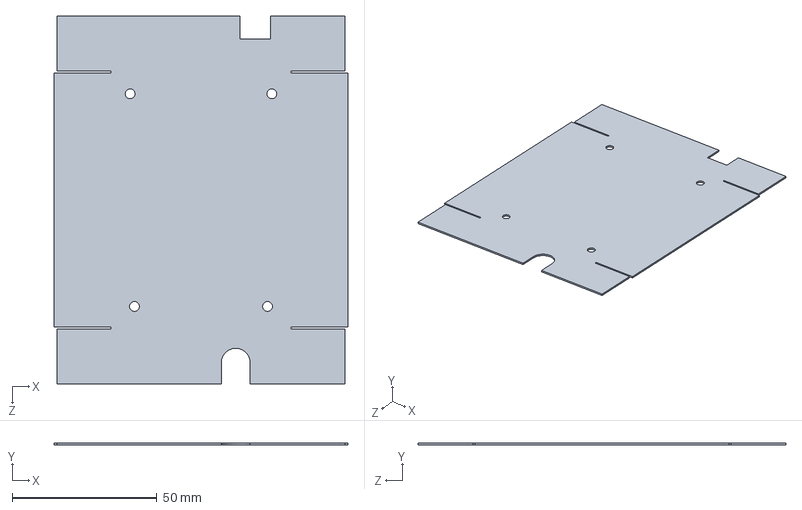
[picture p123: CAD file, 2013-08-08]
Hardware/IR Sensor/IR Box Top.SLDPRT
101.5 x 0.7 x 127.2 mm
