rowan-walsh/BruteforceIgnorance/Hardware/IR Sensor/OP 805 Blinder/GLaDOS faceplate.SLDPRT

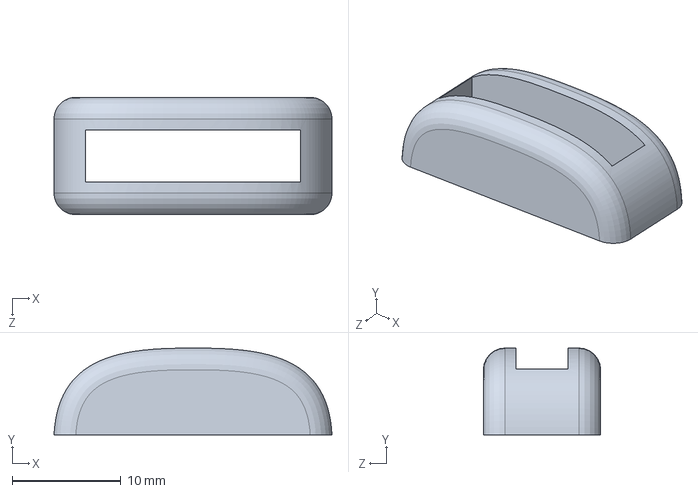
[picture p124: CAD file, 2013-07-30]
Hardware/IR Sensor/OP 805 Blinder/GLaDOS faceplate.SLDPRT
25.6 x 8.00 x 10.8 mm
