rowan-walsh/BruteforceIgnorance/Hardware/Laser range finder/OP805.SLDPRT

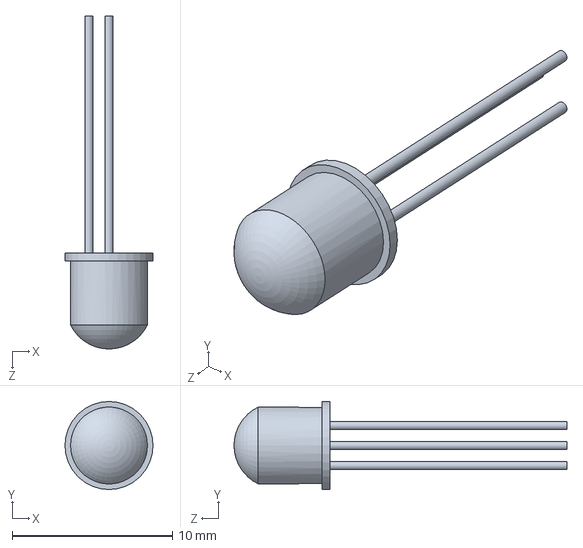
[picture p125: CAD file, 2013-06-26]
Hardware/Laser range finder/OP805.SLDPRT
5.50 x 5.50 x 20.8 mm
