rowan-walsh/BruteforceIgnorance/Hardware/Supplied Component Models/Motor Barber Coleman geared.SLDPRT

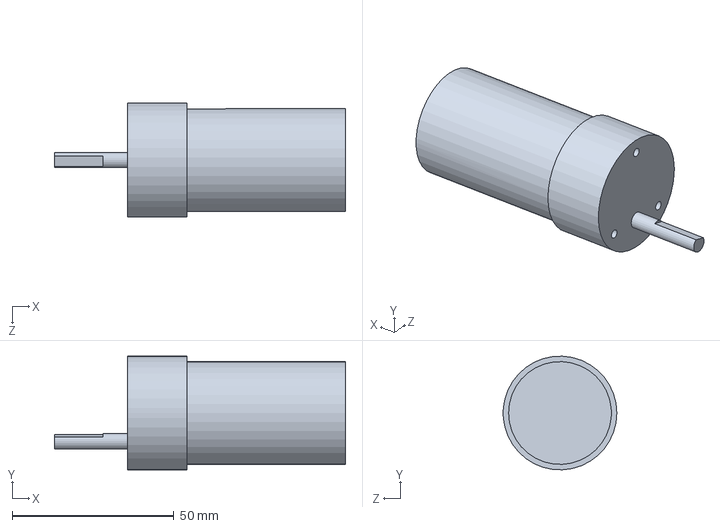
[picture p126: CAD file, 2013-06-16]
Hardware/Supplied Component Models/Motor Barber Coleman geared.SLDPRT
89.9 x 35.1 x 35.1 mm
