rowan-walsh/BruteforceIgnorance/Hardware/Supplied Component Models/Servo/Servo Spindle.SLDPRT

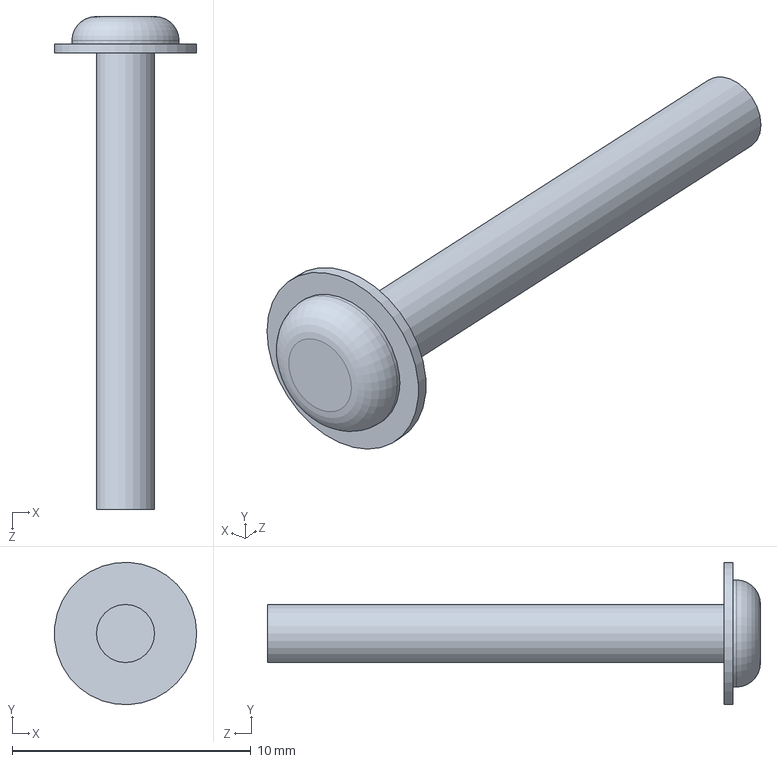
[picture p127: CAD file, 2013-06-15]
Hardware/Supplied Component Models/Servo/Servo Spindle.SLDPRT
5.97 x 5.96 x 20.7 mm
