rowan-walsh/BruteforceIgnorance/Hardware/Wall Bearing/Touch Sensor Holder.SLDPRT

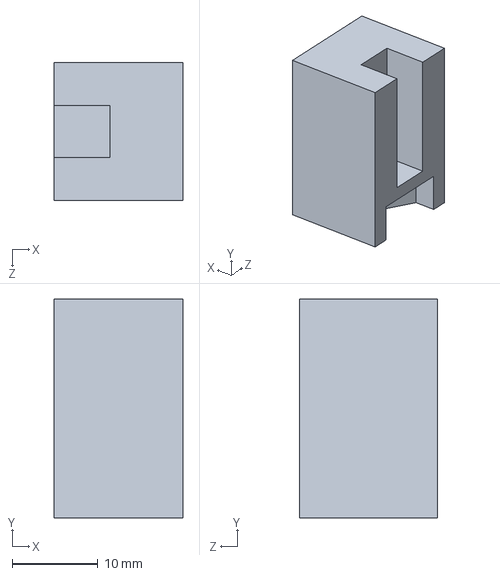
[picture p128: CAD file, 2013-07-25]
Hardware/Wall Bearing/Touch Sensor Holder.SLDPRT
15.0 x 25.5 x 16.1 mm
