rowan-walsh/BruteforceIgnorance/Rough Shape.SLDPRT

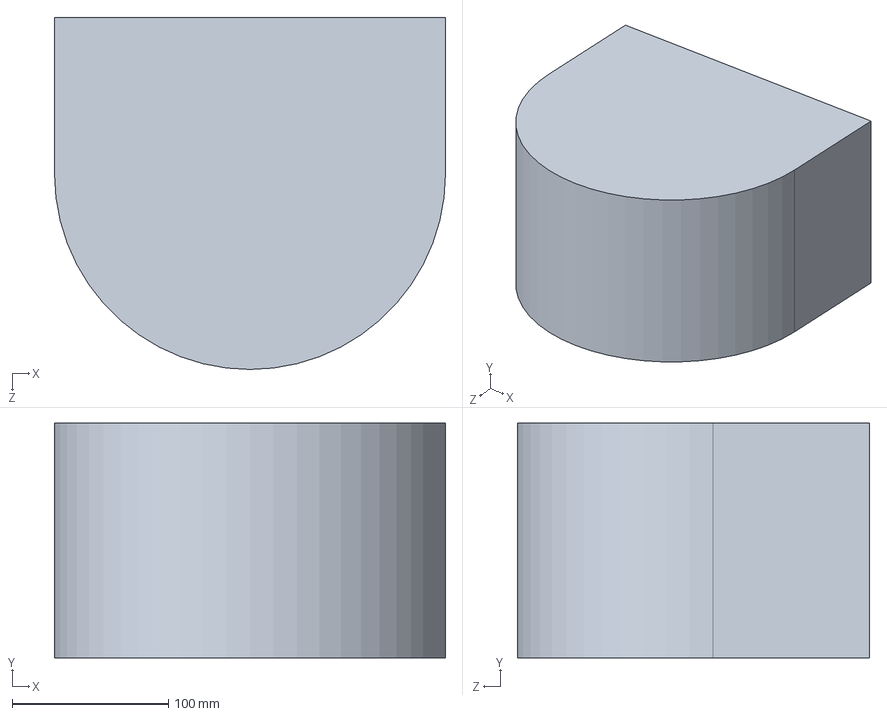
[picture p129: CAD file, 2013-05-31]
Rough Shape.SLDPRT
250.0 x 150.0 x 225.0 mm
