rowan-walsh/BruteforceIgnorance/Enviroment/Official Play Surface/whac target.SLDPRT

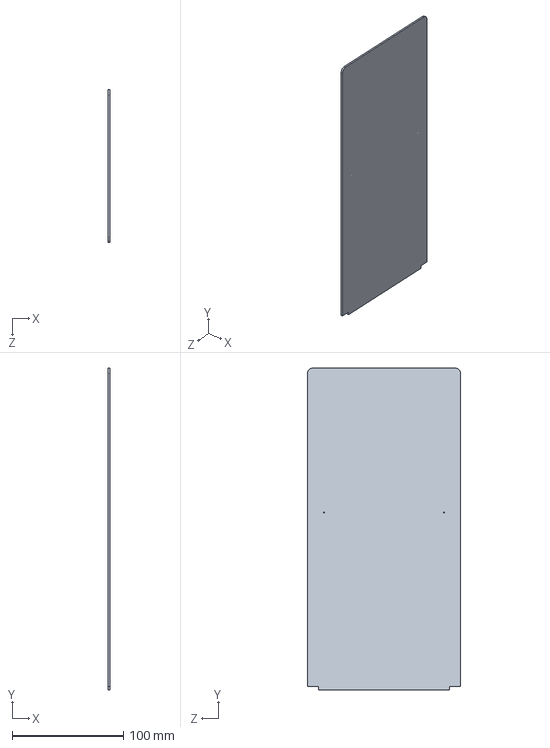
[picture p130: CAD file, 2013-06-11]
Enviroment/Official Play Surface/whac target.SLDPRT
1.80 x 290.0 x 138.0 mm
