rowan-walsh/BruteforceIgnorance/Hardware/Ball Collector/QRD Holder.SLDPRT

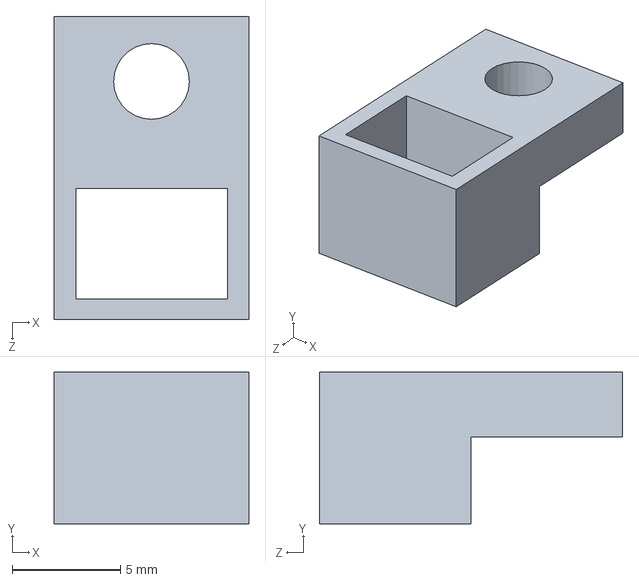
[picture p131: CAD file, 2013-07-22]
Hardware/Ball Collector/QRD Holder.SLDPRT
9.00 x 7.00 x 14.0 mm
