rowan-walsh/BruteforceIgnorance/Hardware/Chassis/flange wall back.SLDPRT

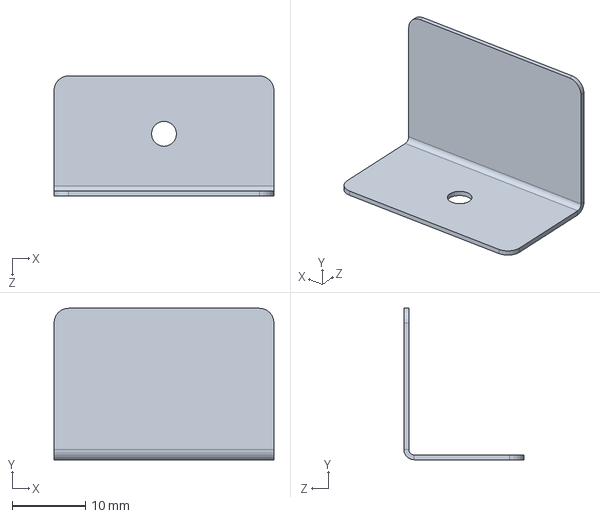
[picture p132: CAD file, 2013-07-26]
Hardware/Chassis/flange wall back.SLDPRT
30.0 x 20.7 x 16.4 mm
