rowan-walsh/BruteforceIgnorance/Hardware/Electrical Mounting/Touch Sensor Holder - Front.SLDPRT

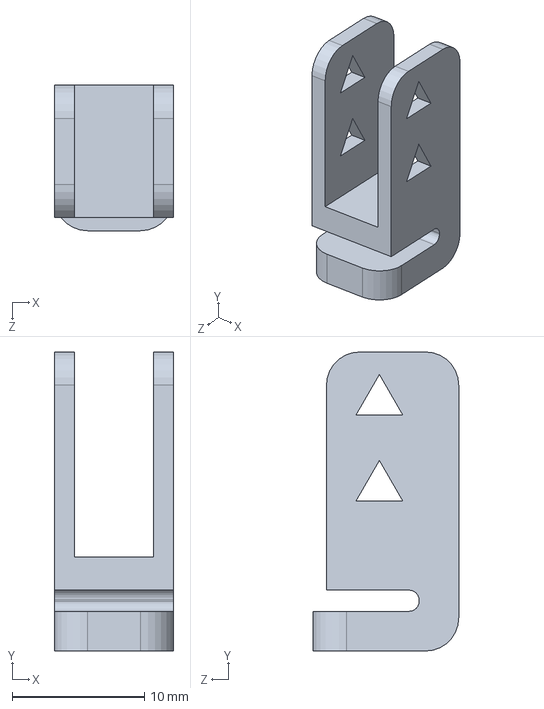
[picture p133: CAD file, 2013-07-23]
Hardware/Electrical Mounting/Touch Sensor Holder - Front.SLDPRT
9.00 x 22.6 x 11.0 mm
