rowan-walsh/BruteforceIgnorance/Hardware/Ferris Wheel/Insertion Ramp.SLDPRT

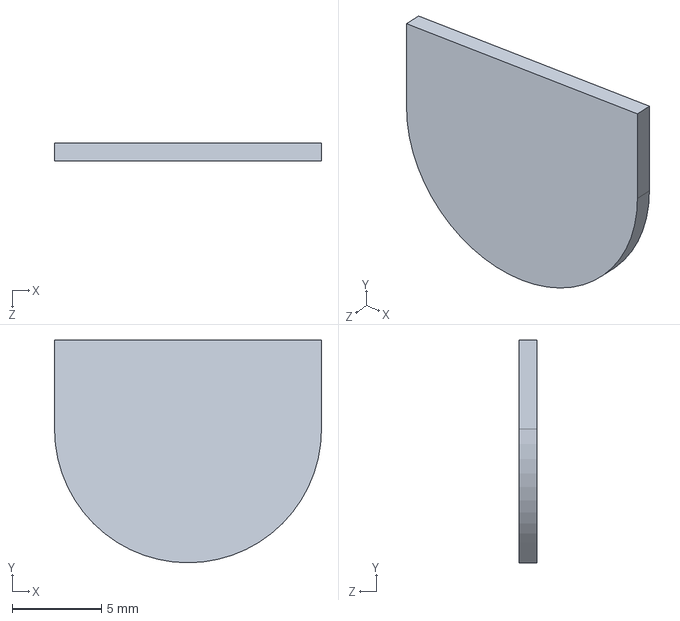
[picture p134: CAD file, 2013-06-09]
Hardware/Ferris Wheel/Insertion Ramp.SLDPRT
15.0 x 12.5 x 1.00 mm
