rowan-walsh/BruteforceIgnorance/Hardware/Firing mechanism/Camshaft loader/Cam.SLDPRT

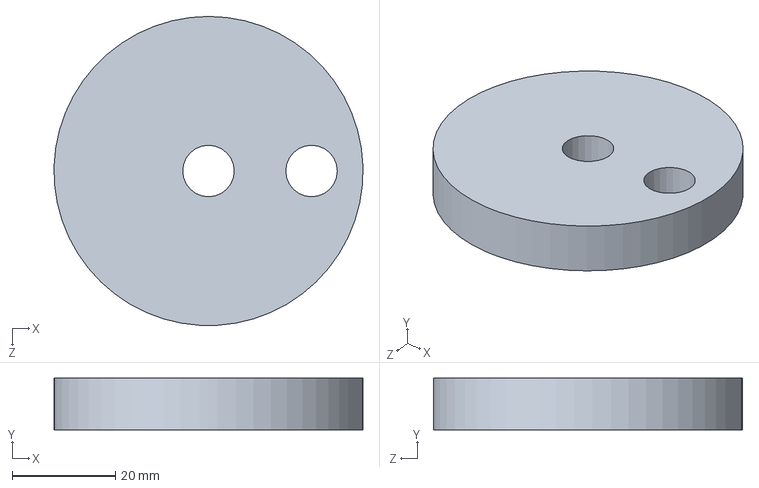
[picture p135: CAD file, 2013-06-15]
Hardware/Firing mechanism/Camshaft loader/Cam.SLDPRT
60.0 x 10.0 x 60.0 mm
