rowan-walsh/BruteforceIgnorance/Hardware/Internal Ball Handling/Lower Ramp 4.SLDPRT

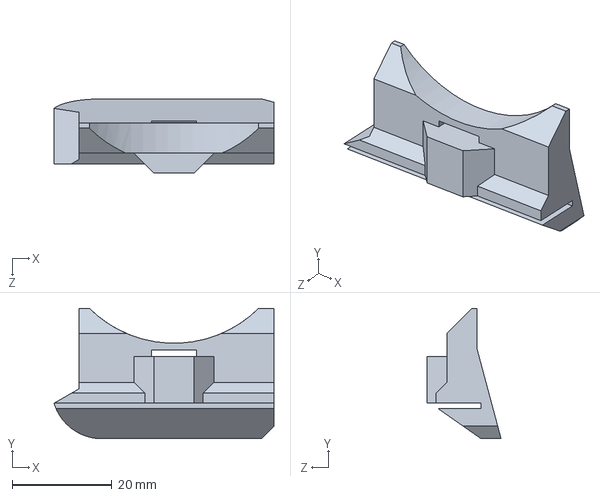
[picture p136: CAD file, 2013-08-02]
Hardware/Internal Ball Handling/Lower Ramp 4.SLDPRT
44.0 x 26.1 x 14.8 mm
