rowan-walsh/BruteforceIgnorance/Hardware/IR Sensor/OP 805 Blinder/Mounting bracket.SLDPRT

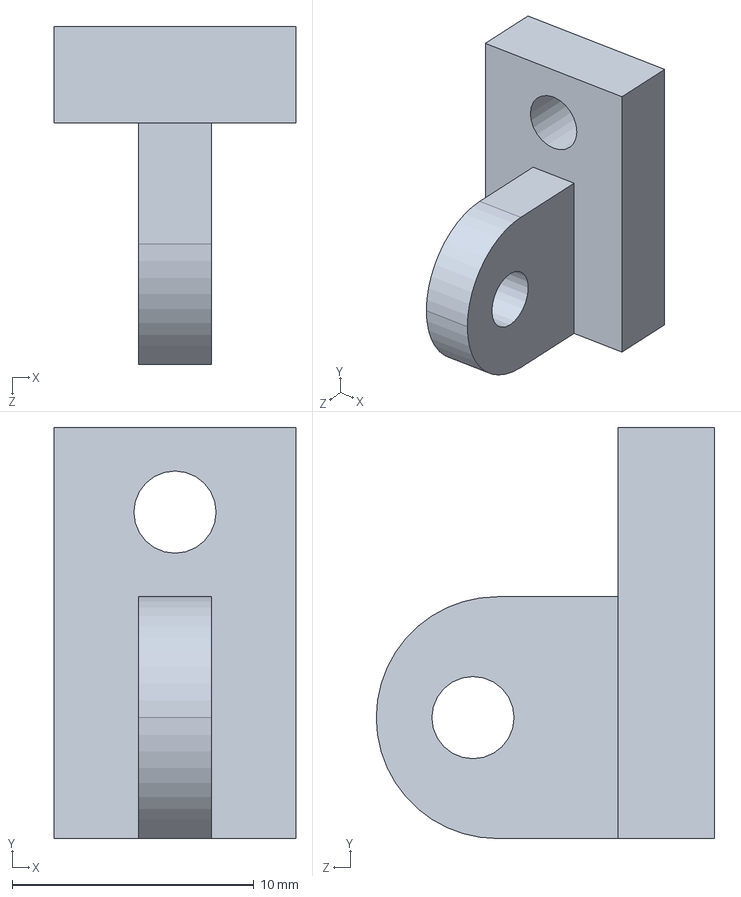
[picture p137: CAD file, 2013-07-25]
Hardware/IR Sensor/OP 805 Blinder/Mounting bracket.SLDPRT
10.0 x 17.0 x 14.0 mm
