rowan-walsh/BruteforceIgnorance/Hardware/IR Sensor/Tube.SLDPRT

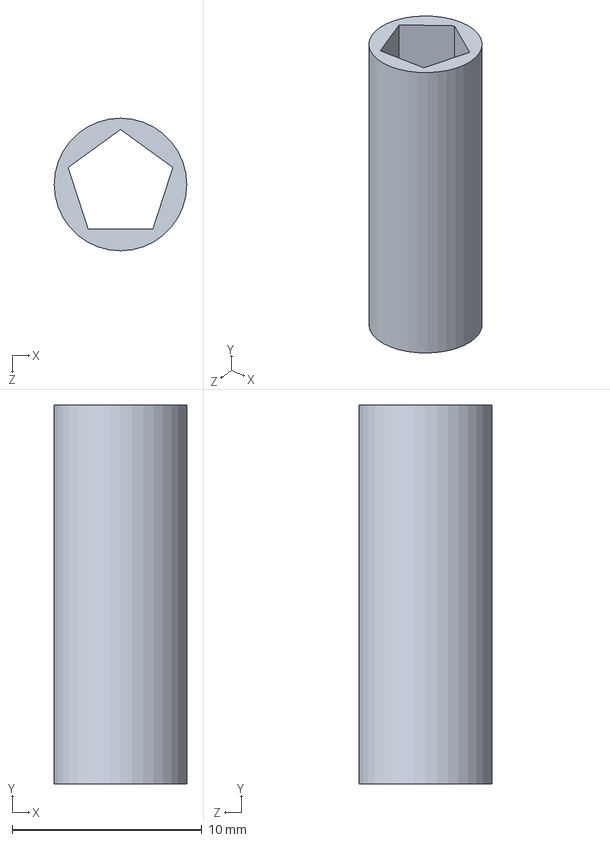
[picture p138: CAD file, 2013-07-13]
Hardware/IR Sensor/Tube.SLDPRT
7.00 x 20.0 x 7.00 mm
