rowan-walsh/BruteforceIgnorance/Hardware/Laser range finder/laser.SLDPRT

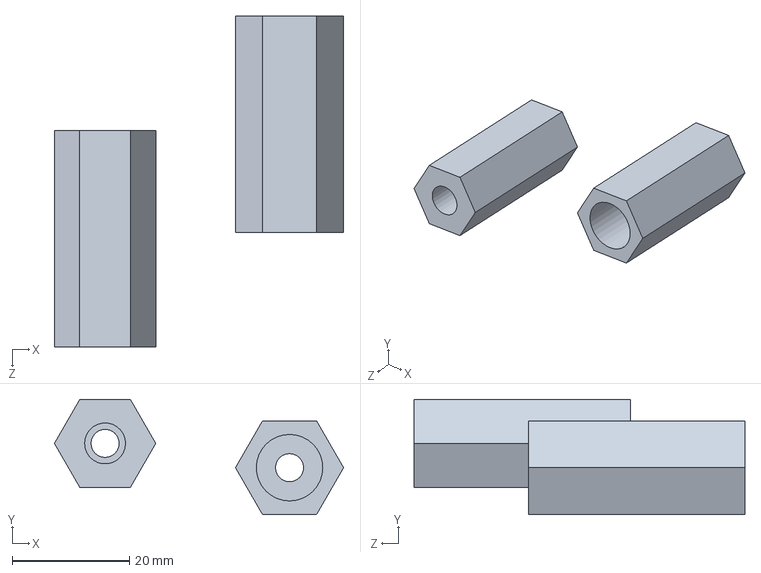
[picture p139: CAD file, 2013-06-26]
Hardware/Laser range finder/laser.SLDPRT
49.4 x 19.6 x 56.5 mm
