rowan-walsh/BruteforceIgnorance/Hardware/Mars Rover Wheels/Motor Bracket.SLDPRT

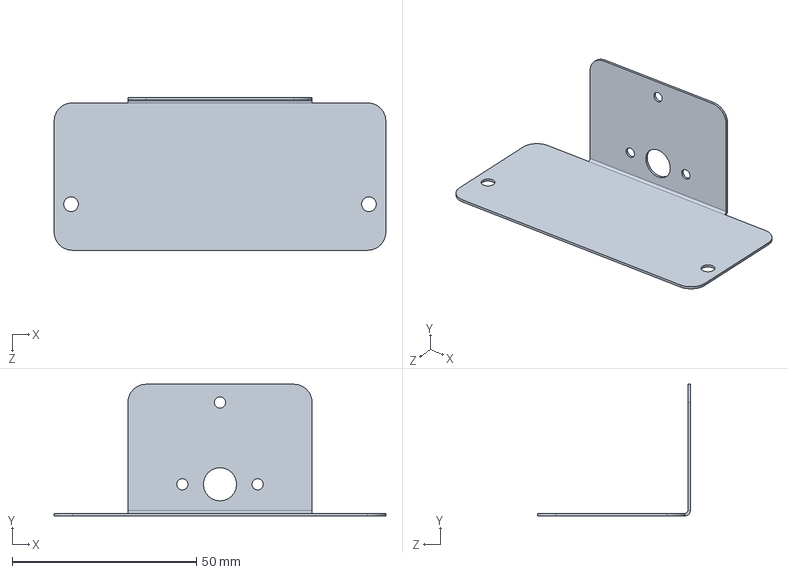
[picture p140: CAD file, 2013-07-06]
Hardware/Mars Rover Wheels/Motor Bracket.SLDPRT
90.0 x 35.7 x 41.4 mm
