rowan-walsh/BruteforceIgnorance/Hardware/Rough Layout/Brush - rough.SLDPRT

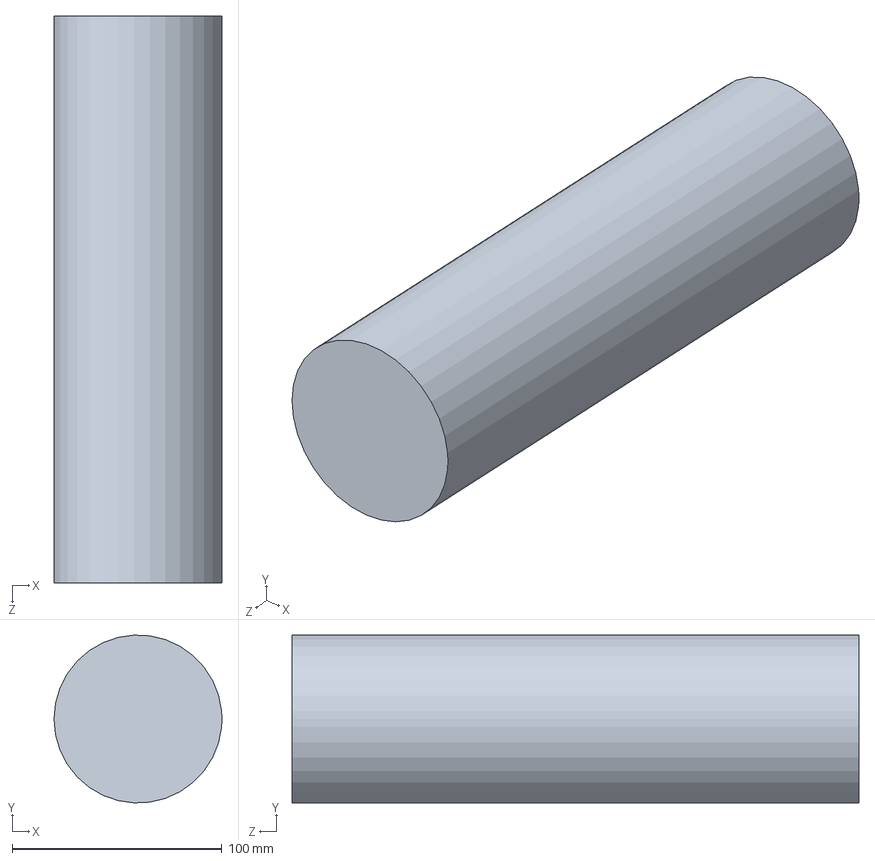
[picture p141: CAD file, 2013-06-07]
Hardware/Rough Layout/Brush - rough.SLDPRT
80.0 x 79.9 x 270.0 mm
