rowan-walsh/BruteforceIgnorance/Enviroment/Official Play Surface/table level.SLDPRT

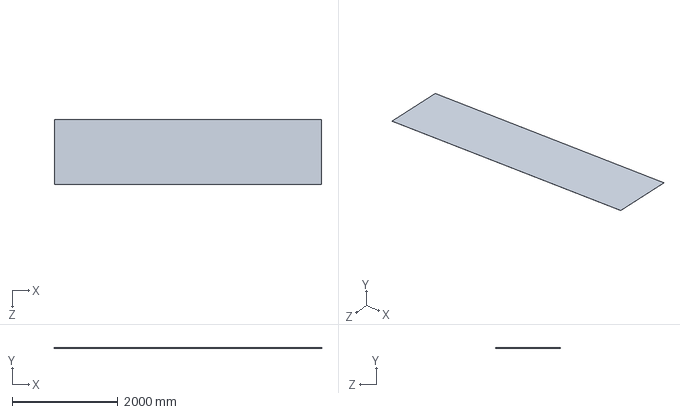
[picture p142: CAD file, 2013-06-11]
Enviroment/Official Play Surface/table level.SLDPRT
5038.9 x 1.00 x 1219.2 mm
