rowan-walsh/BruteforceIgnorance/Hardware/Chassis/010 Chassis.SLDPRT

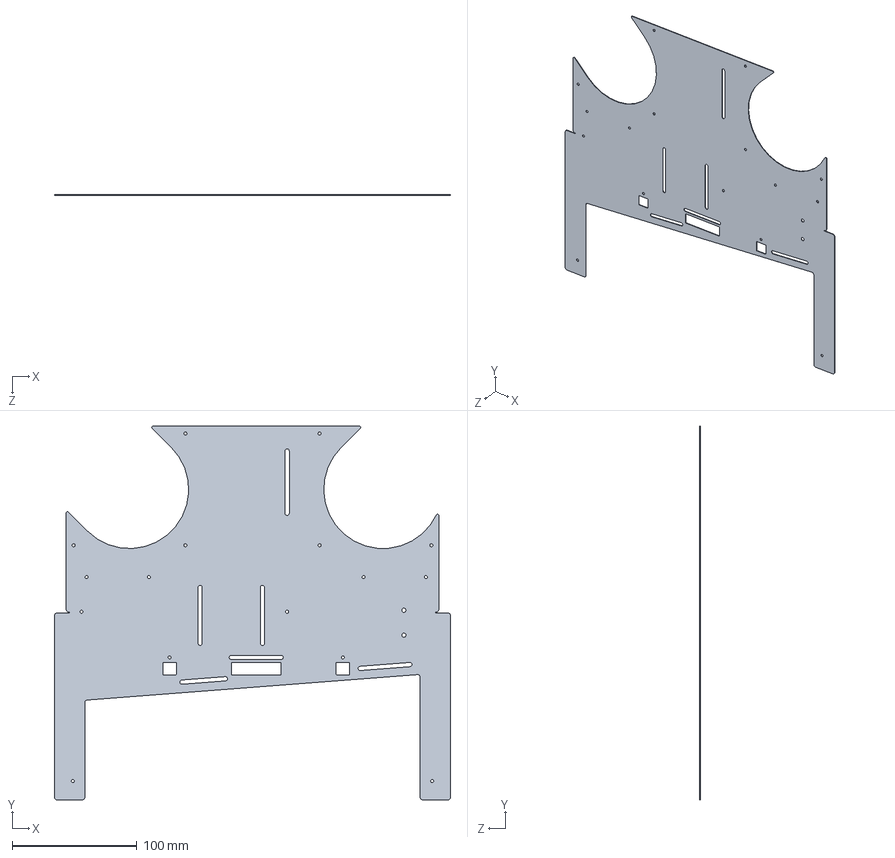
[picture p143: CAD file, 2013-07-26]
Hardware/Chassis/010 Chassis.SLDPRT
317.8 x 300.0 x 0.635 mm
