rowan-walsh/BruteforceIgnorance/Hardware/Electrical Mounting/Touch Sensor Holder - Side.SLDPRT

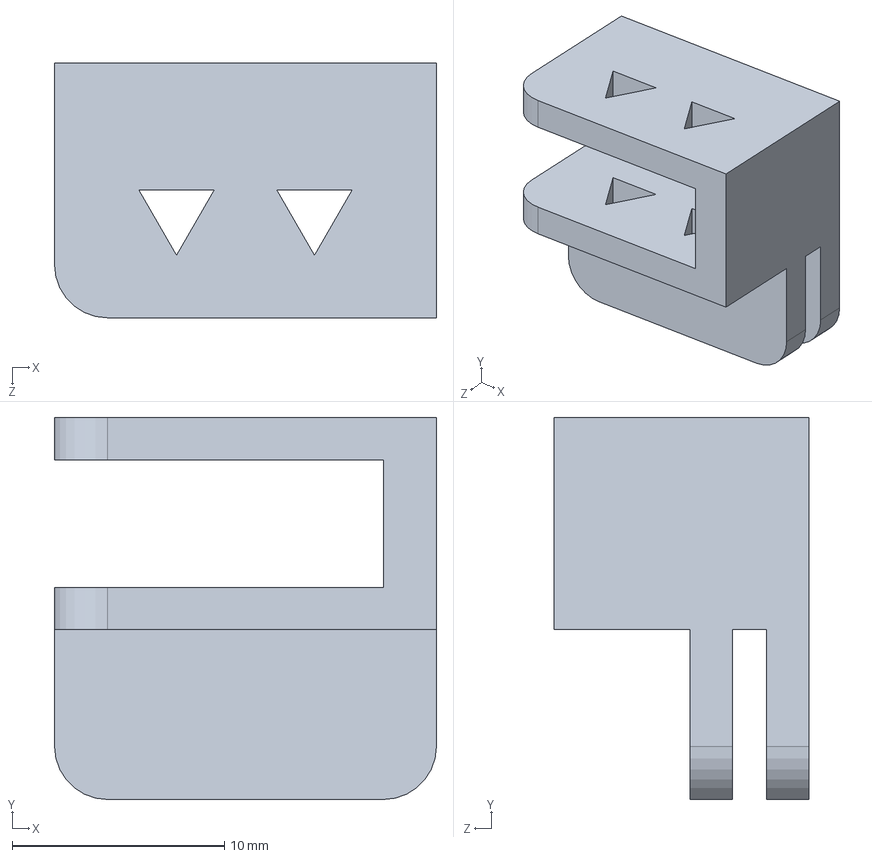
[picture p144: CAD file, 2013-07-19]
Hardware/Electrical Mounting/Touch Sensor Holder - Side.SLDPRT
18.0 x 18.0 x 12.0 mm
