rowan-walsh/BruteforceIgnorance/Hardware/Ferris Wheel/Perimeter Spacer.SLDPRT

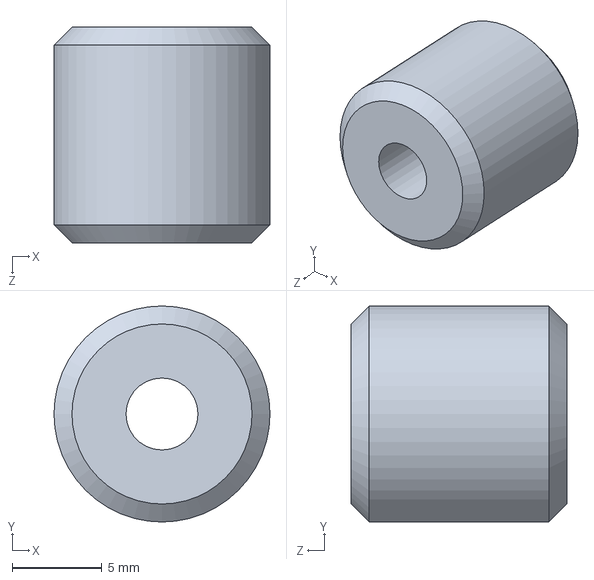
[picture p145: CAD file, 2013-06-09]
Hardware/Ferris Wheel/Perimeter Spacer.SLDPRT
12.0 x 12.0 x 12.0 mm
