rowan-walsh/BruteforceIgnorance/Hardware/Firing mechanism/Camshaft loader/Camshaft base.SLDPRT

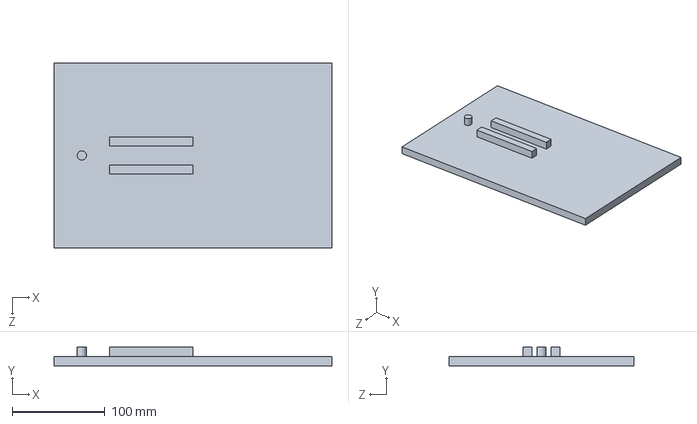
[picture p146: CAD file, 2013-06-15]
Hardware/Firing mechanism/Camshaft loader/Camshaft base.SLDPRT
300.0 x 20.0 x 200.0 mm
