rowan-walsh/BruteforceIgnorance/Hardware/Internal Ball Handling/Gate Servo Bracket 2.SLDPRT

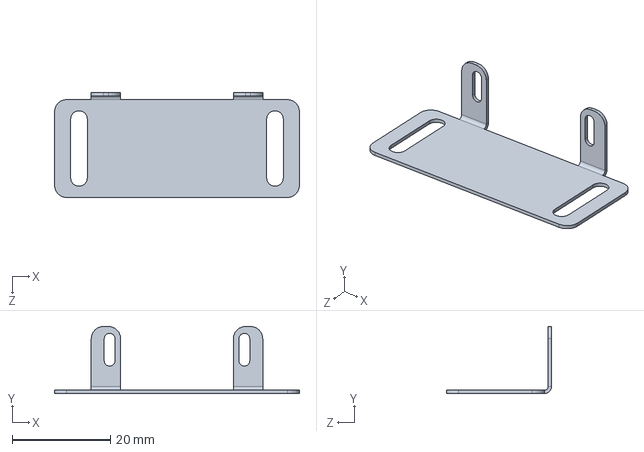
[picture p147: CAD file, 2013-08-02]
Hardware/Internal Ball Handling/Gate Servo Bracket 2.SLDPRT
50.0 x 13.7 x 21.4 mm
