rowan-walsh/BruteforceIgnorance/Hardware/Laser range finder/Laser pointer.SLDPRT

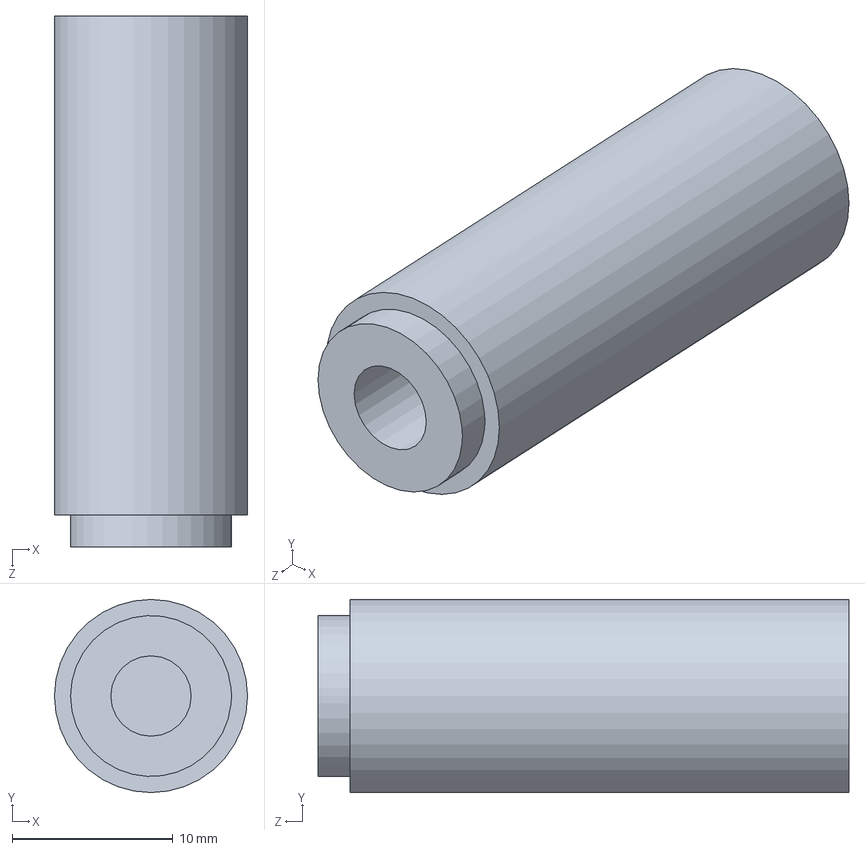
[picture p148: CAD file, 2013-06-26]
Hardware/Laser range finder/Laser pointer.SLDPRT
12.0 x 12.0 x 33.0 mm
