rowan-walsh/BruteforceIgnorance/Hardware/Mars Rover Wheels/Printed Servo Gear.SLDPRT

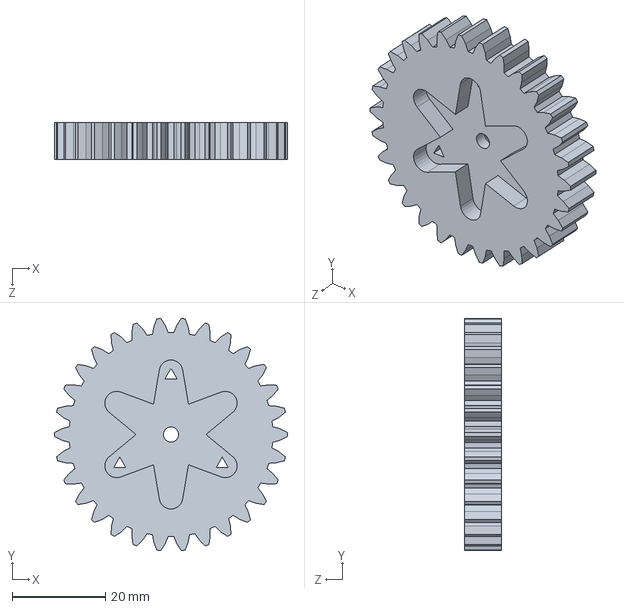
[picture p149: CAD file, 2013-07-06]
Hardware/Mars Rover Wheels/Printed Servo Gear.SLDPRT
50.0 x 49.8 x 8.00 mm
