rowan-walsh/BruteforceIgnorance/Hardware/Supplied Component Models/solarbotics-gm7-solid-model/Solarbotics-GM7-Assem.IGS

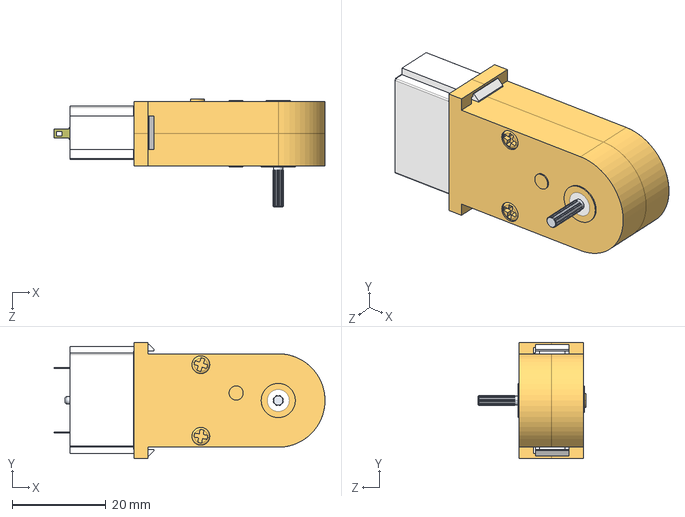
[picture p150: CAD file, 2013-05-31]
Hardware/Supplied Component Models/solarbotics-gm7-solid-model/Solarbotics-GM7-Assem.IGS
57.9 x 24.8 x 23.0 mm
