rowan-walsh/BruteforceIgnorance/Hardware/Supplied Component Models/worm for helical gear.SLDPRT

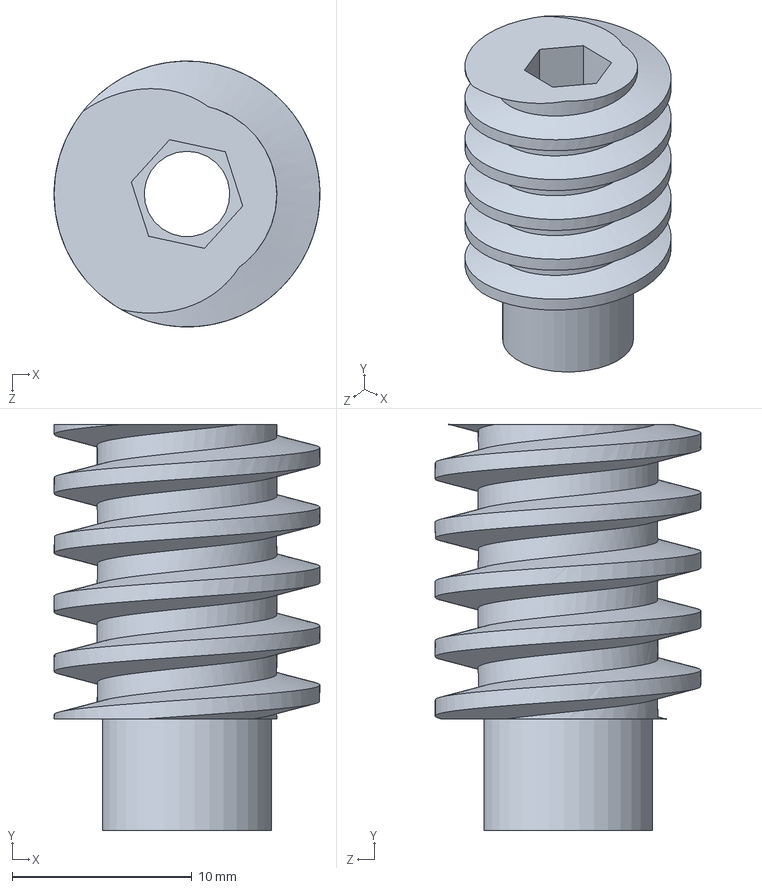
[picture p151: CAD file, 2013-06-15]
Hardware/Supplied Component Models/worm for helical gear.SLDPRT
14.8 x 22.6 x 14.8 mm
