rowan-walsh/BruteforceIgnorance/Hardware/Wall Bearing/Bearing 1-4in ID 11-16in OD.SLDPRT

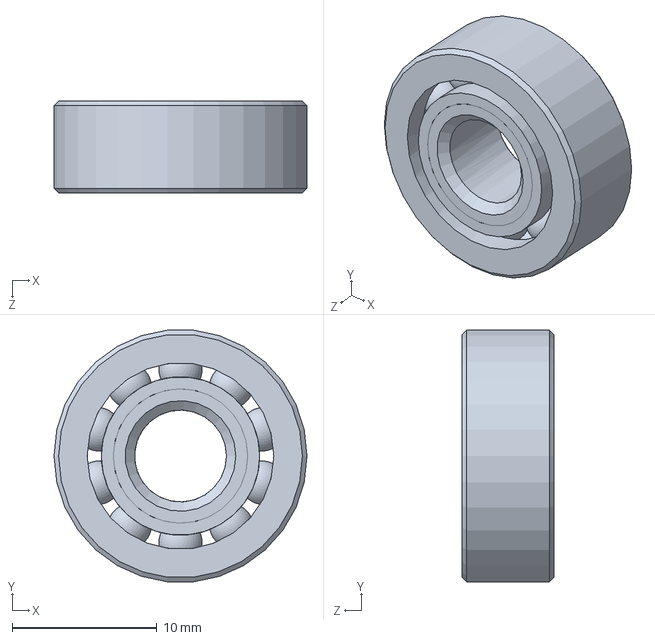
[picture p152: CAD file, 2013-07-25]
Hardware/Wall Bearing/Bearing 1-4in ID 11-16in OD.SLDPRT
17.5 x 17.4 x 6.35 mm
