rowan-walsh/BruteforceIgnorance/Hardware/Ball Collector/Gear 106 teeth.SLDPRT

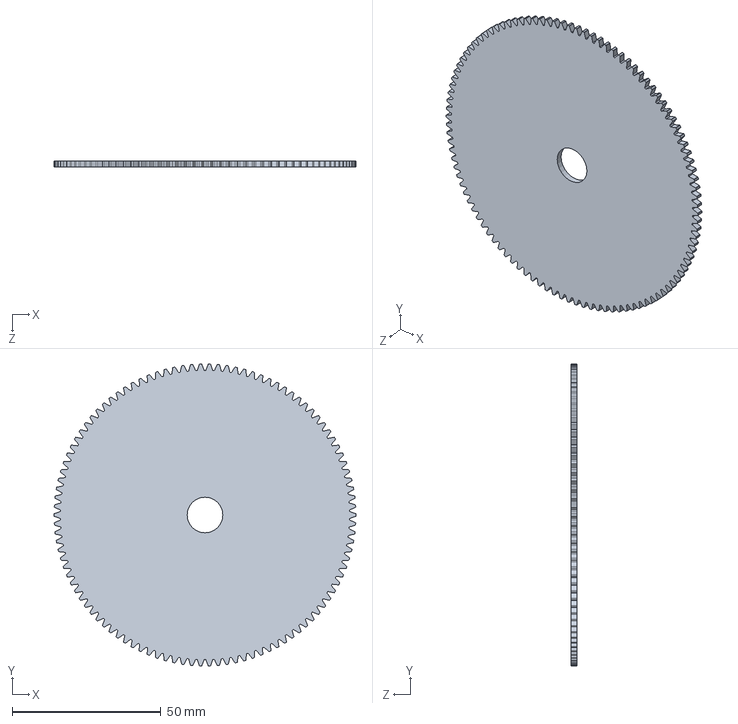
[picture p153: CAD file, 2013-07-07]
Hardware/Ball Collector/Gear 106 teeth.SLDPRT
101.6 x 101.6 x 2.00 mm
