rowan-walsh/BruteforceIgnorance/Hardware/Electrical Mounting/back support.SLDPRT

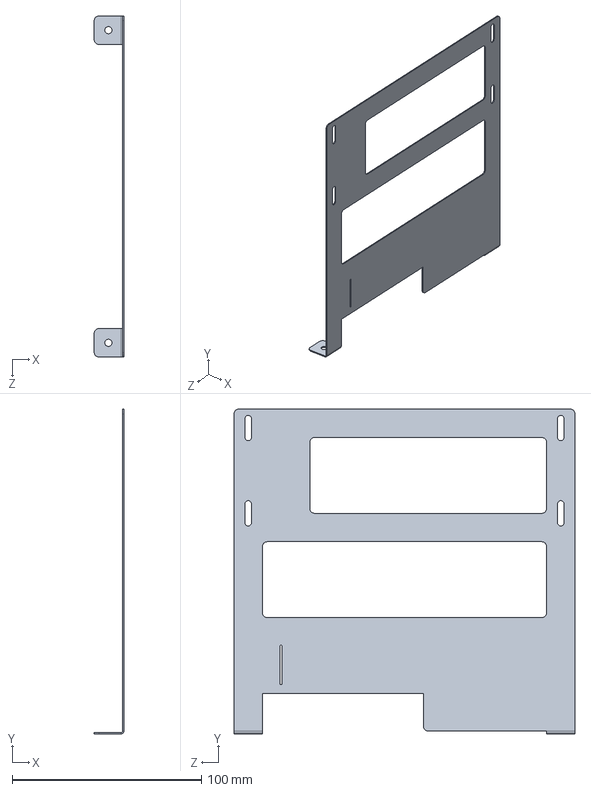
[picture p154: CAD file, 2013-07-19]
Hardware/Electrical Mounting/back support.SLDPRT
15.7 x 171.4 x 180.0 mm
