rowan-walsh/BruteforceIgnorance/Hardware/Firing mechanism/Roller Bushing.SLDPRT

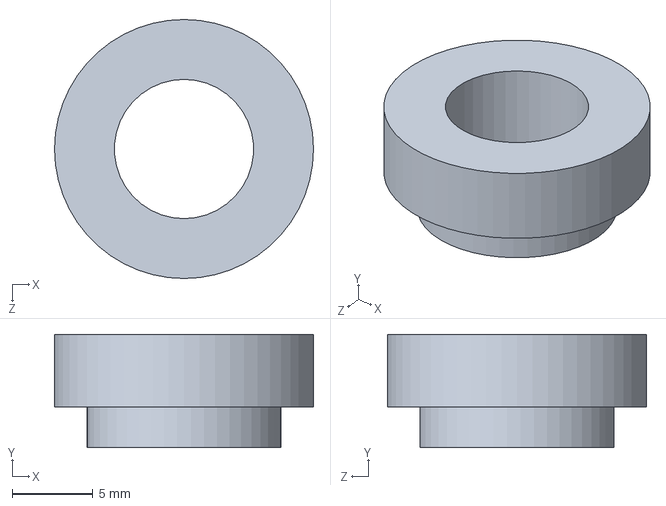
[picture p155: CAD file, 2013-07-19]
Hardware/Firing mechanism/Roller Bushing.SLDPRT
16.0 x 7.00 x 16.0 mm
