rowan-walsh/BruteforceIgnorance/Hardware/Internal Ball Handling/Arm Hoop.SLDPRT

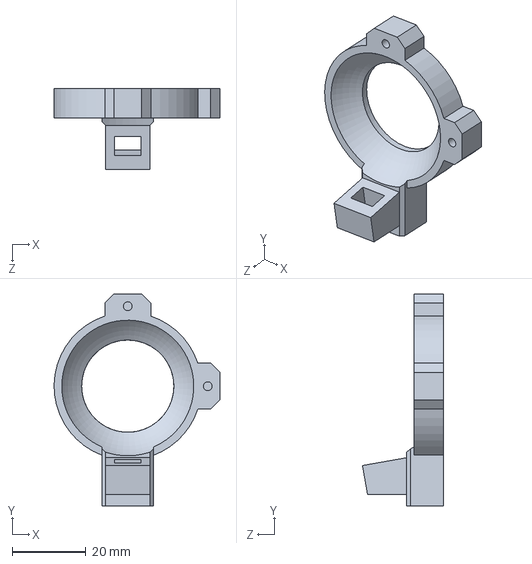
[picture p156: CAD file, 2013-08-02]
Hardware/Internal Ball Handling/Arm Hoop.SLDPRT
45.0 x 57.5 x 22.0 mm
