rowan-walsh/BruteforceIgnorance/Hardware/Laser range finder/Laser Enclosure.SLDPRT

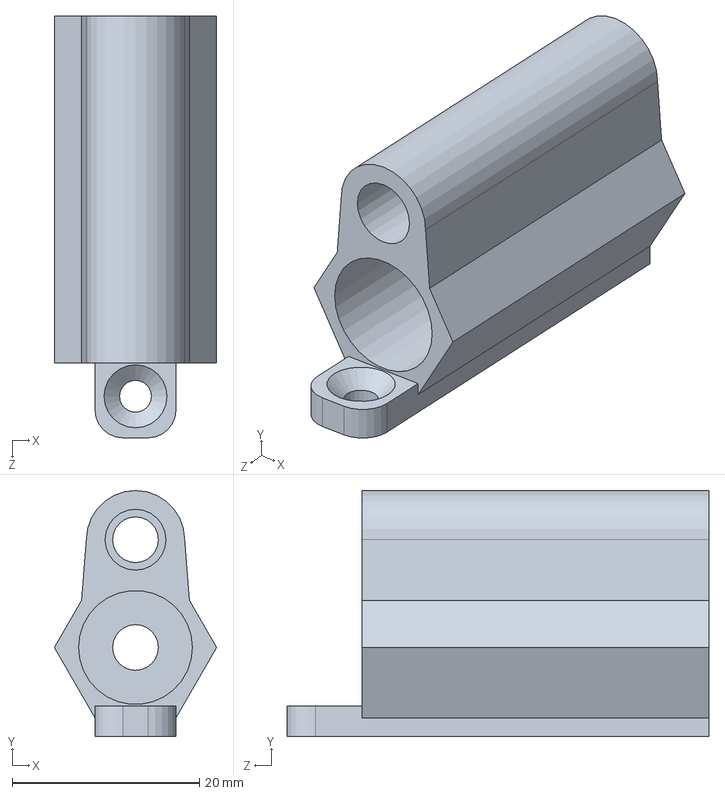
[picture p157: CAD file, 2013-06-26]
Hardware/Laser range finder/Laser Enclosure.SLDPRT
17.3 x 26.3 x 45.0 mm
