rowan-walsh/BruteforceIgnorance/Hardware/Rough Layout/Wheel - rough.SLDPRT

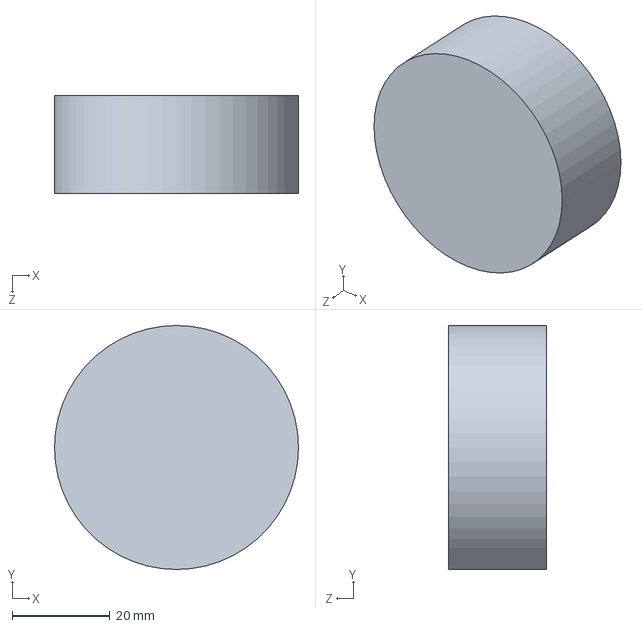
[picture p158: CAD file, 2013-06-06]
Hardware/Rough Layout/Wheel - rough.SLDPRT
50.0 x 50.0 x 20.0 mm
