rowan-walsh/BruteforceIgnorance/Hardware/Supplied Component Models/helical gear 40 teeth.SLDPRT

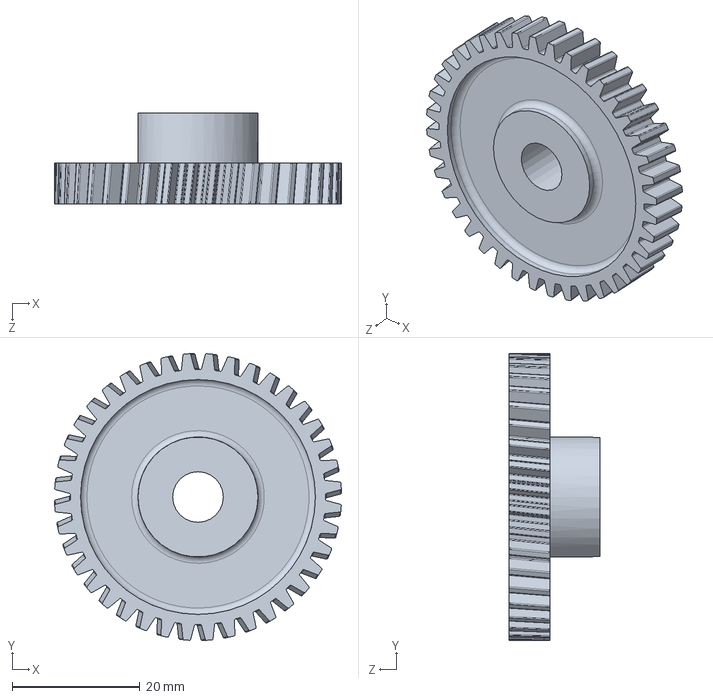
[picture p159: CAD file, 2013-06-15]
Hardware/Supplied Component Models/helical gear 40 teeth.SLDPRT
45.0 x 45.0 x 14.2 mm
