rowan-walsh/BruteforceIgnorance/Hardware/Wall Bearing/Touch Sensor.SLDPRT

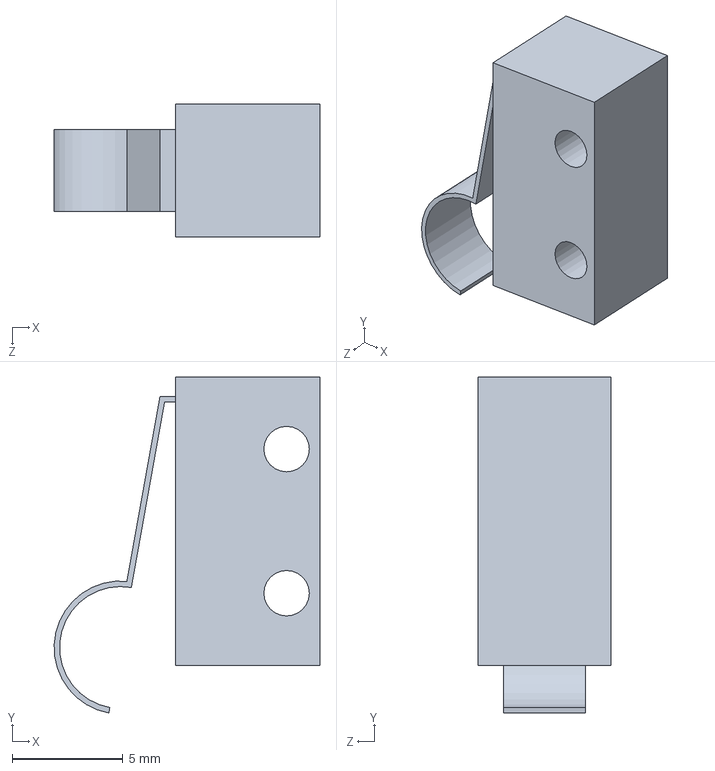
[picture p160: CAD file, 2013-07-25]
Hardware/Wall Bearing/Touch Sensor.SLDPRT
12.0 x 15.2 x 6.00 mm
