rowan-walsh/BruteforceIgnorance/Hardware/Ball Collector/small gear.SLDPRT

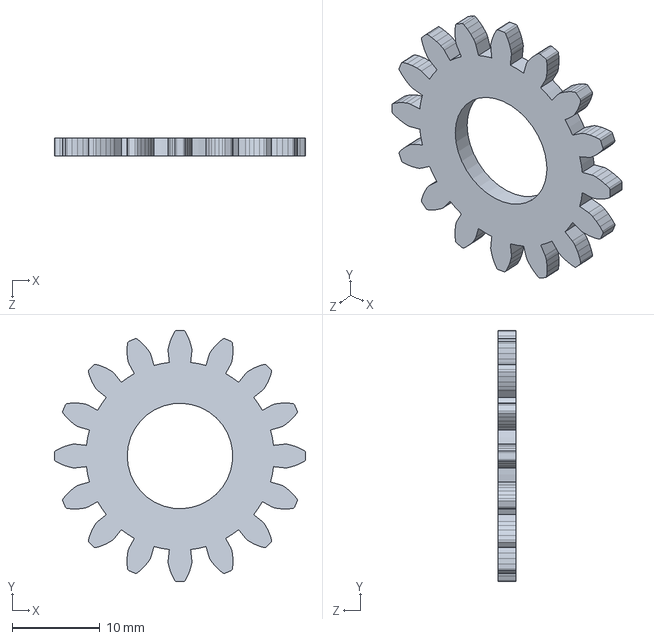
[picture p161: CAD file, 2013-07-07]
Hardware/Ball Collector/small gear.SLDPRT
28.6 x 28.6 x 2.00 mm
