rowan-walsh/BruteforceIgnorance/Hardware/Ferris Wheel/Ferris Plate.SLDPRT

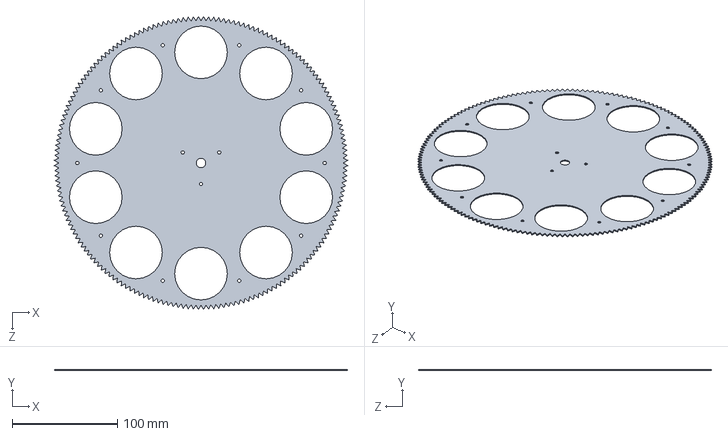
[picture p162: CAD file, 2013-06-09]
Hardware/Ferris Wheel/Ferris Plate.SLDPRT
278.1 x 1.00 x 278.1 mm
