rowan-walsh/BruteforceIgnorance/Hardware/Firing mechanism/Roller Plate.SLDPRT

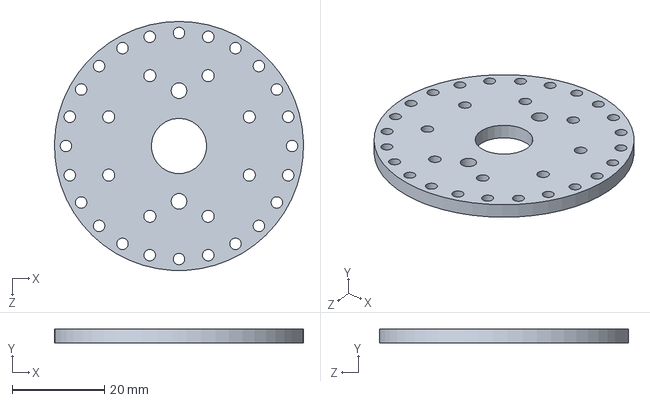
[picture p163: CAD file, 2013-07-19]
Hardware/Firing mechanism/Roller Plate.SLDPRT
54.0 x 3.00 x 54.0 mm
