rowan-walsh/BruteforceIgnorance/Hardware/Internal Ball Handling/Gate Servo Bracket 3.SLDPRT

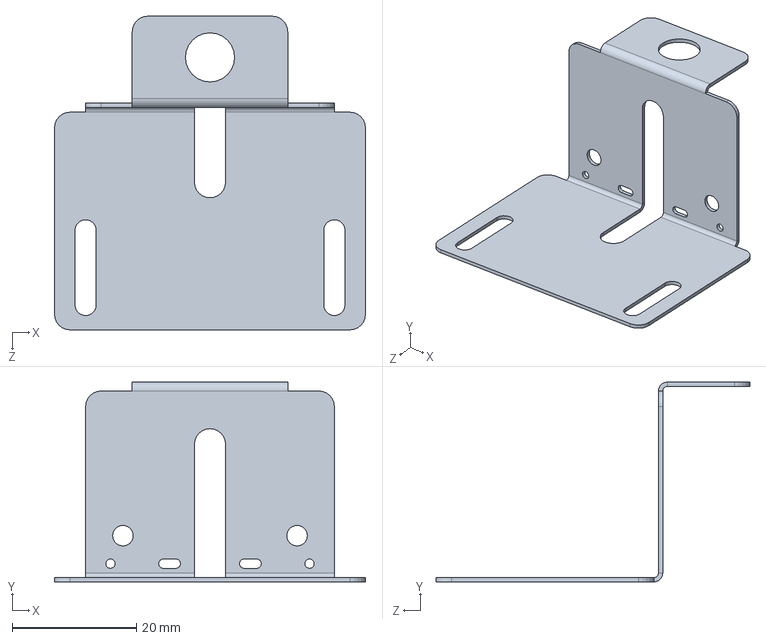
[picture p164: CAD file, 2013-08-02]
Hardware/Internal Ball Handling/Gate Servo Bracket 3.SLDPRT
50.0 x 32.1 x 50.4 mm
