rowan-walsh/BruteforceIgnorance/Hardware/Mars Rover Wheels/Turntable Gear.SLDPRT

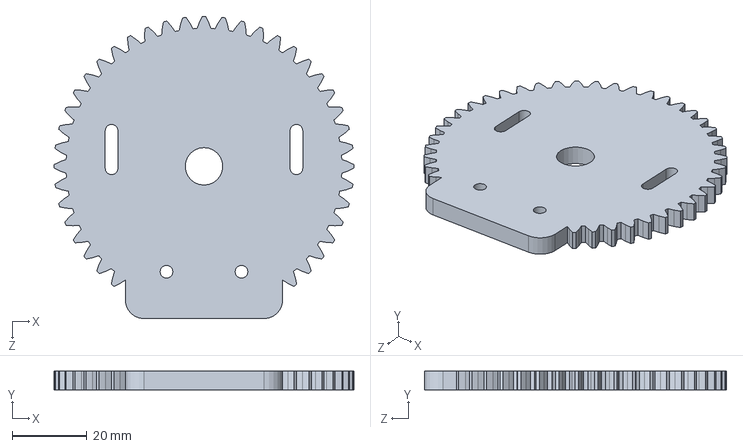
[picture p165: CAD file, 2013-07-06]
Hardware/Mars Rover Wheels/Turntable Gear.SLDPRT
80.0 x 5.00 x 80.6 mm
