rowan-walsh/BruteforceIgnorance/Hardware/Rough Layout/Ball Guide Roller - rough.SLDPRT

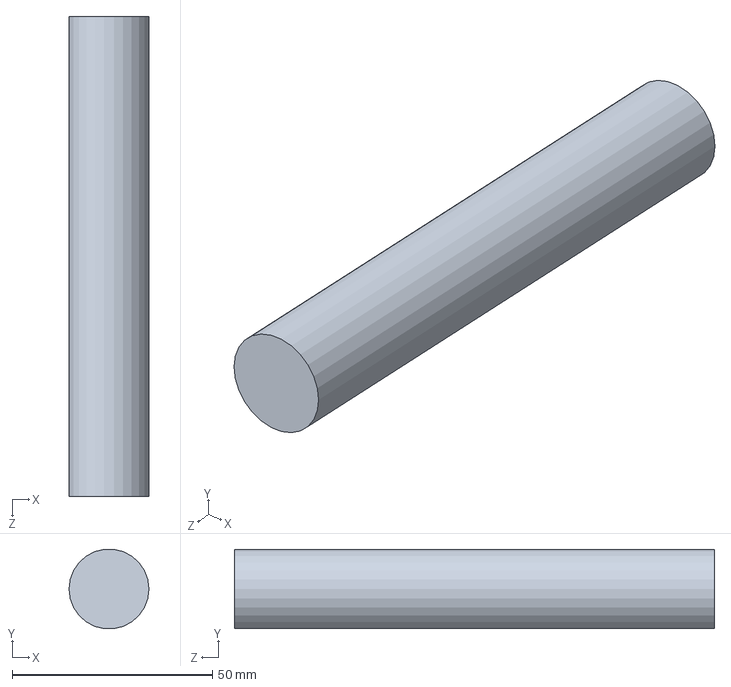
[picture p166: CAD file, 2013-06-06]
Hardware/Rough Layout/Ball Guide Roller - rough.SLDPRT
20.0 x 19.9 x 120.0 mm
