rowan-walsh/BruteforceIgnorance/Hardware/Supplied Component Models/Meccano Gear 39mm.SLDPRT

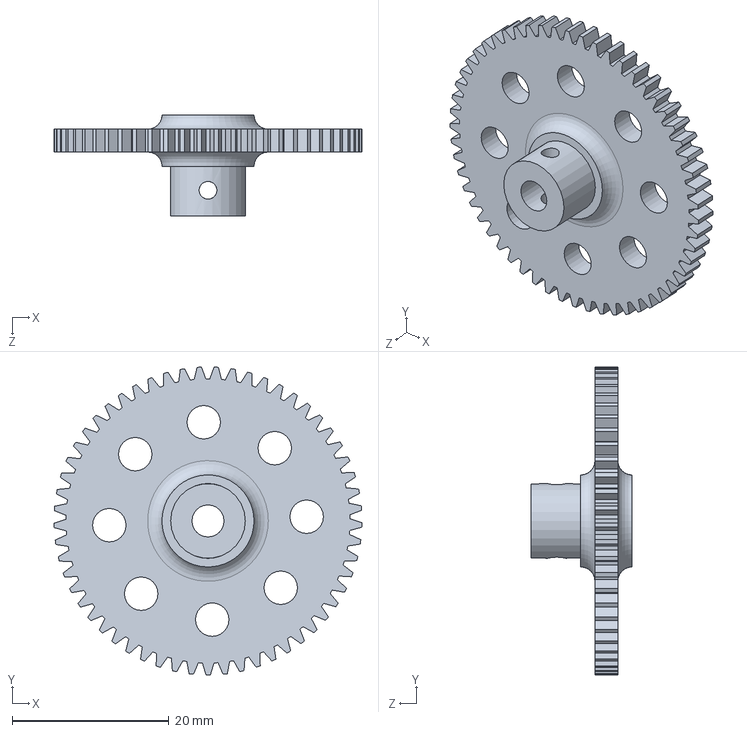
[picture p167: CAD file, 2013-06-15]
Hardware/Supplied Component Models/Meccano Gear 39mm.SLDPRT
39.3 x 39.3 x 12.9 mm
