rowan-walsh/BruteforceIgnorance/Enviroment/Official Play Surface/10kHz IR emitter beacon.SLDPRT

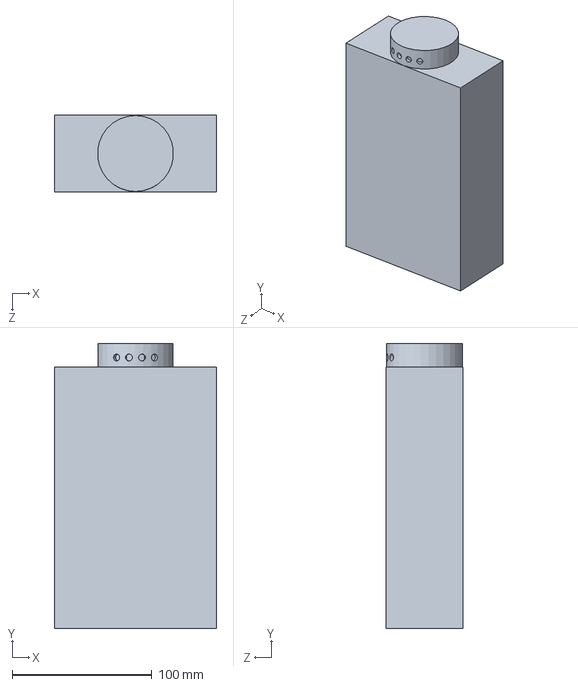
[picture p168: CAD file, 2013-06-11]
Enviroment/Official Play Surface/10kHz IR emitter beacon.SLDPRT
116.0 x 204.0 x 55.0 mm
