rowan-walsh/BruteforceIgnorance/Hardware/Ball Collector/big gear 2.SLDPRT

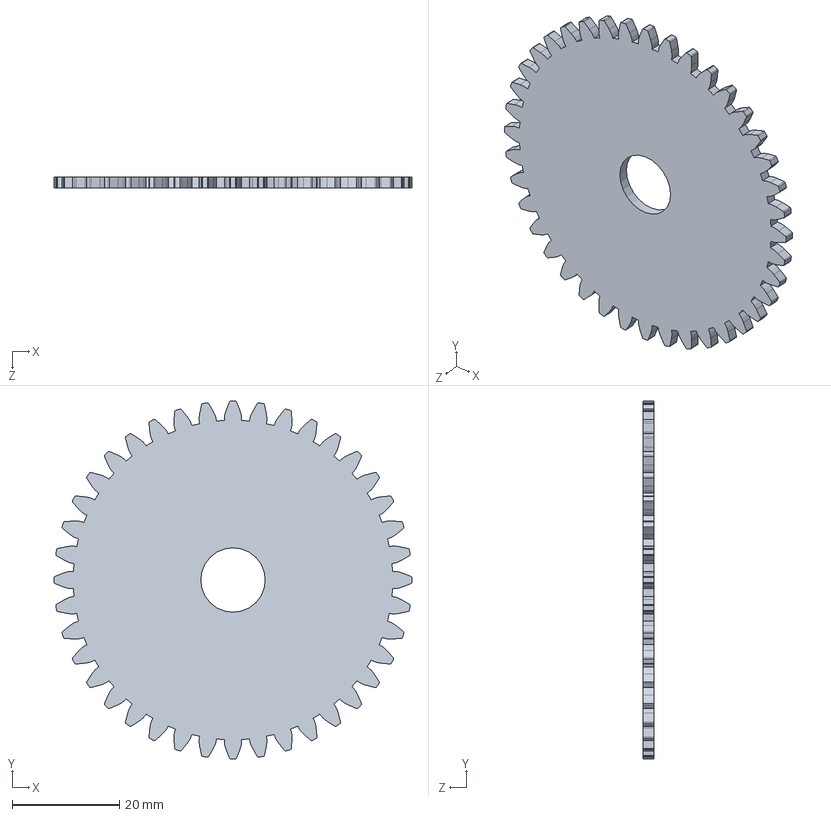
[picture p169: CAD file, 2013-07-07]
Hardware/Ball Collector/big gear 2.SLDPRT
66.7 x 66.7 x 2.00 mm
