rowan-walsh/BruteforceIgnorance/Hardware/Chassis/021 Collector Wall Back.SLDPRT

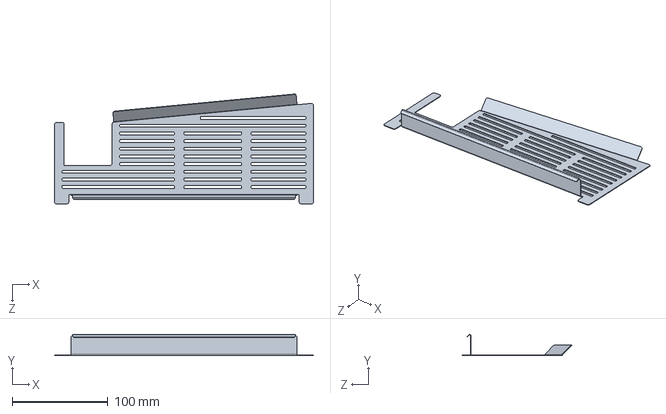
[picture p170: CAD file, 2013-07-26]
Hardware/Chassis/021 Collector Wall Back.SLDPRT
270.0 x 22.0 x 114.5 mm
