rowan-walsh/BruteforceIgnorance/Hardware/Electrical Mounting/Comparator Mount Brace.SLDPRT

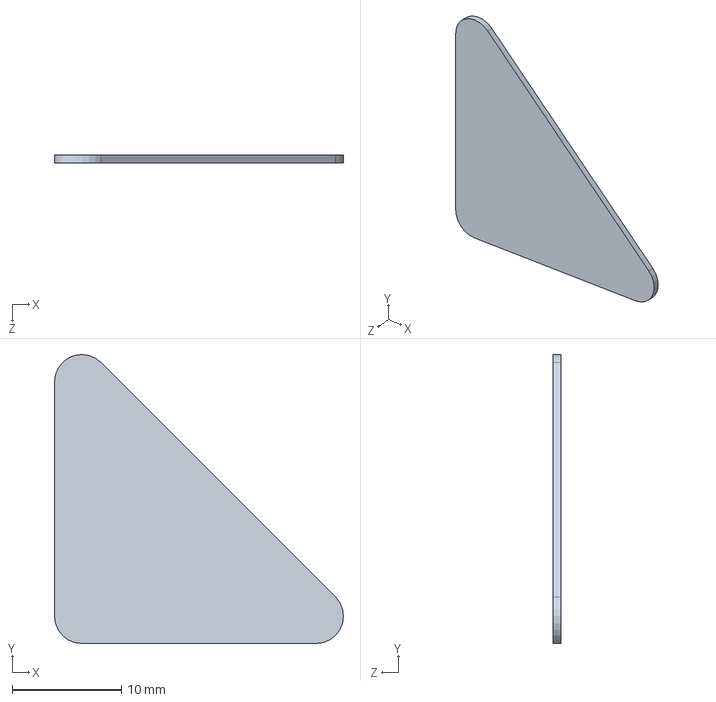
[picture p171: CAD file, 2013-07-19]
Hardware/Electrical Mounting/Comparator Mount Brace.SLDPRT
26.5 x 26.5 x 0.7 mm
