rowan-walsh/BruteforceIgnorance/Hardware/Ferris Wheel/Center Spacer.SLDPRT

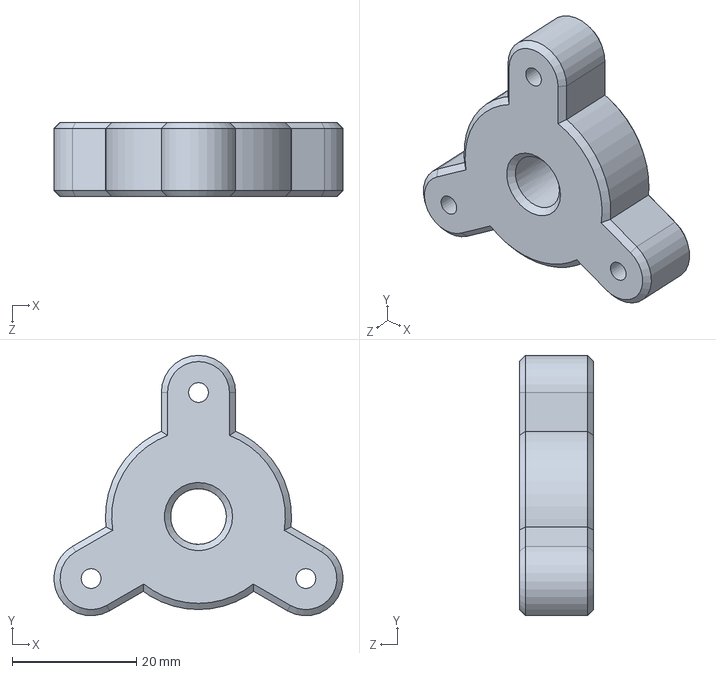
[picture p172: CAD file, 2013-06-09]
Hardware/Ferris Wheel/Center Spacer.SLDPRT
46.6 x 42.0 x 12.0 mm
