rowan-walsh/BruteforceIgnorance/Hardware/Firing mechanism/Roller Gear Spacer.SLDPRT

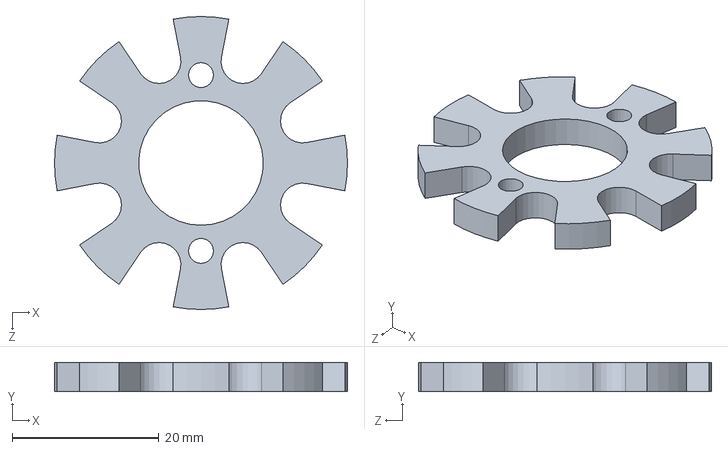
[picture p173: CAD file, 2013-07-19]
Hardware/Firing mechanism/Roller Gear Spacer.SLDPRT
40.0 x 4.00 x 40.0 mm
