rowan-walsh/BruteforceIgnorance/Hardware/Mars Rover Wheels/Wheel.SLDPRT

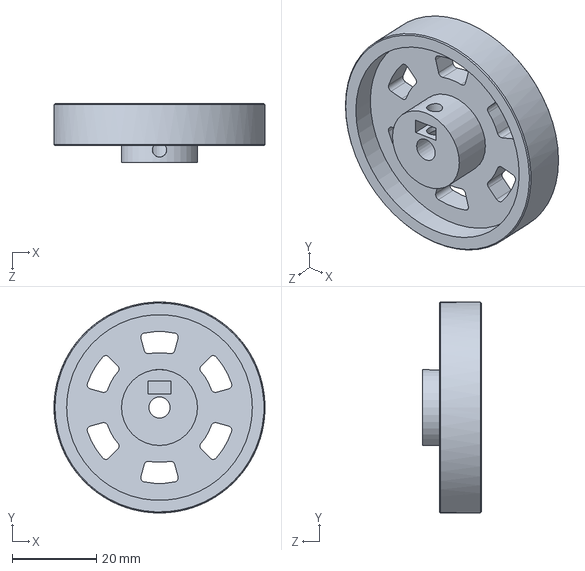
[picture p174: CAD file, 2013-06-26]
Hardware/Mars Rover Wheels/Wheel.SLDPRT
50.0 x 50.0 x 14.0 mm
