rowan-walsh/BruteforceIgnorance/Hardware/Rough Layout/Ball Guides - rough.SLDPRT

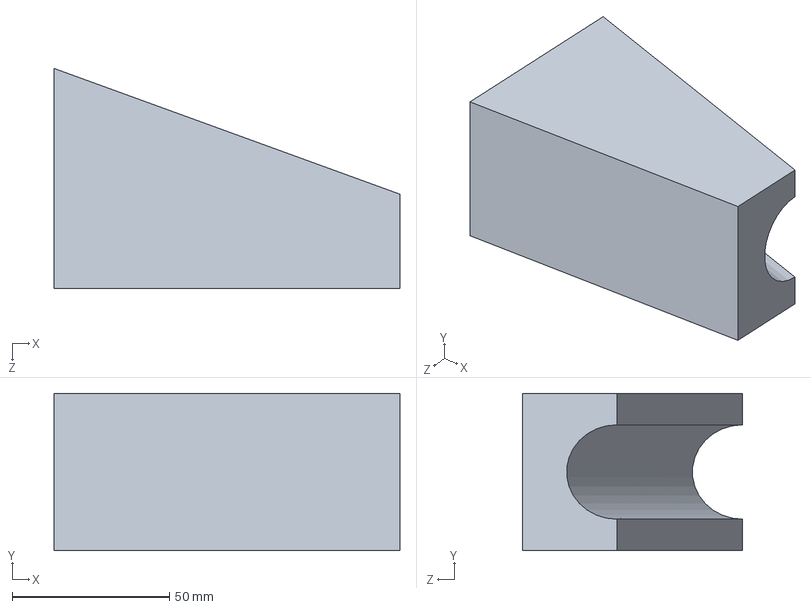
[picture p175: CAD file, 2013-06-06]
Hardware/Rough Layout/Ball Guides - rough.SLDPRT
110.0 x 50.0 x 70.0 mm
