rowan-walsh/BruteforceIgnorance/Hardware/Wall Bearing/chassis arm.SLDPRT

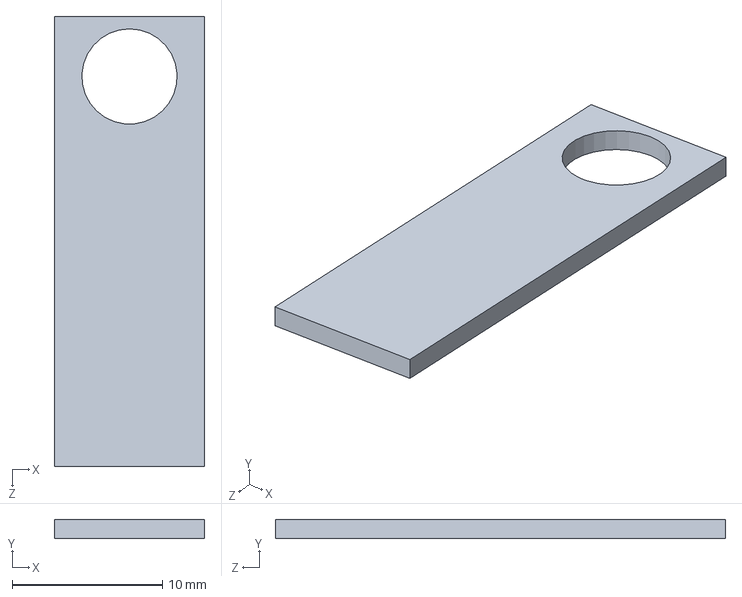
[picture p176: CAD file, 2013-07-25]
Hardware/Wall Bearing/chassis arm.SLDPRT
10.0 x 1.27 x 30.0 mm
