rowan-walsh/BruteforceIgnorance/Enviroment/Official Play Surface/top parts 13mm.SLDPRT

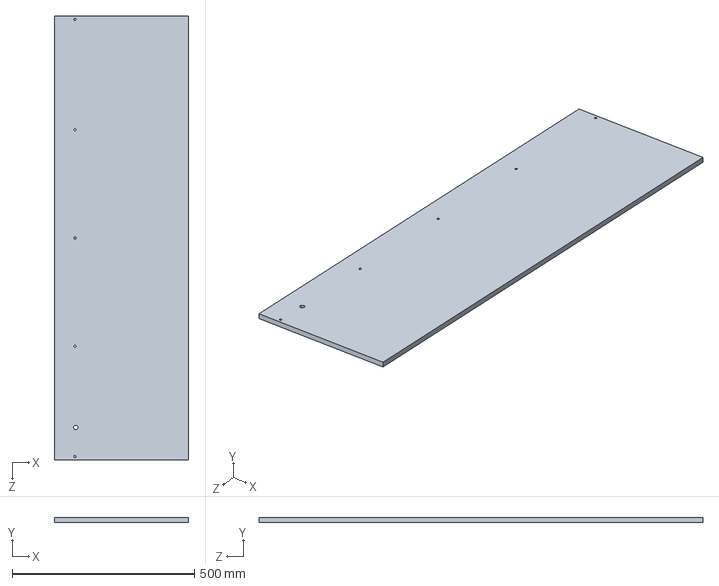
[picture p177: CAD file, 2013-06-11]
Enviroment/Official Play Surface/top parts 13mm.SLDPRT
369.0 x 13.0 x 1219.2 mm
