rowan-walsh/BruteforceIgnorance/Hardware/Ball Collector/Brush_Shaft_Slot_Constraint_Big_End.SLDPRT

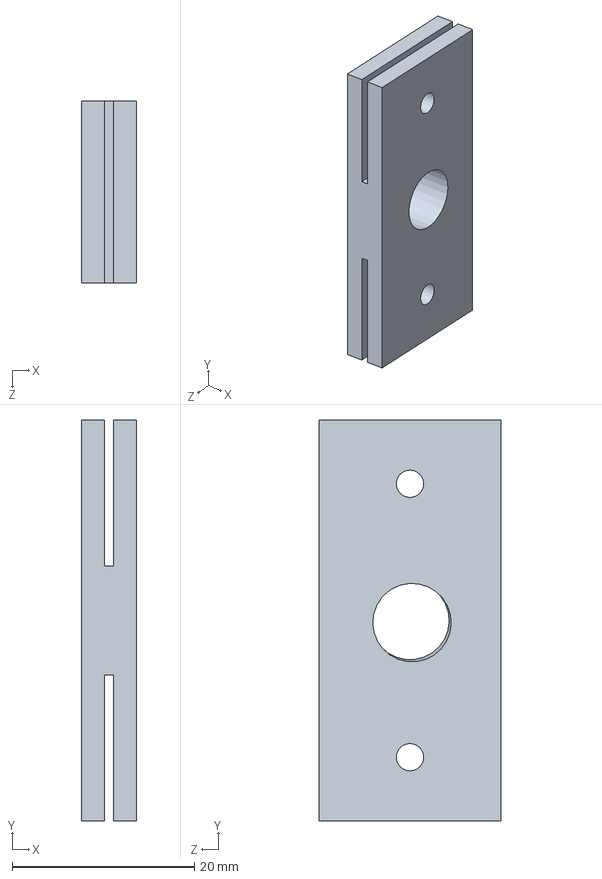
[picture p178: CAD file, 2013-07-07]
Hardware/Ball Collector/Brush_Shaft_Slot_Constraint_Big_End.SLDPRT
6.00 x 44.0 x 20.0 mm
