rowan-walsh/BruteforceIgnorance/Hardware/Chassis/Firing Support.SLDPRT

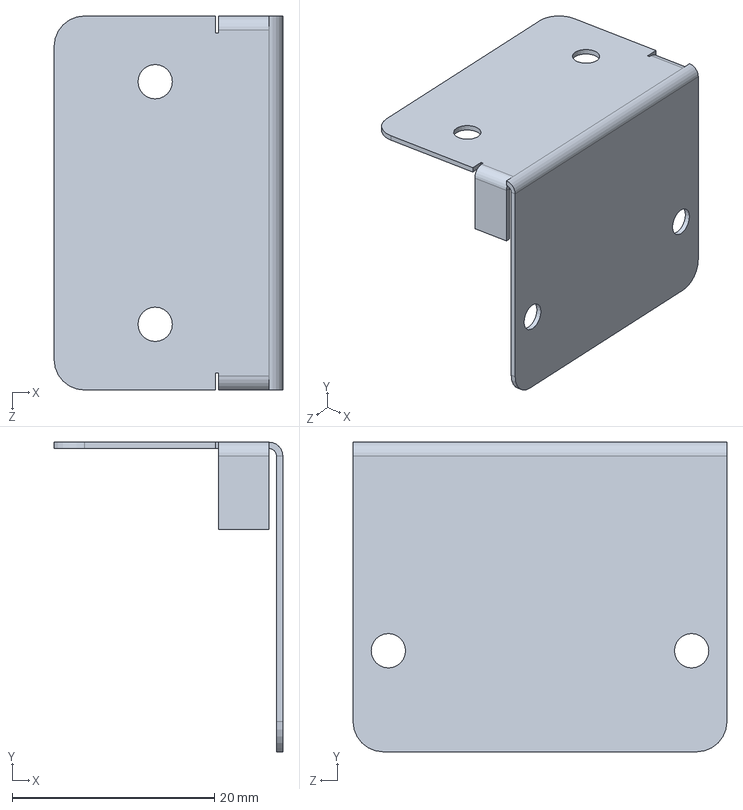
[picture p179: CAD file, 2013-07-26]
Hardware/Chassis/Firing Support.SLDPRT
22.6 x 30.6 x 37.0 mm
