rowan-walsh/BruteforceIgnorance/Hardware/Electrical Mounting/end support.SLDPRT

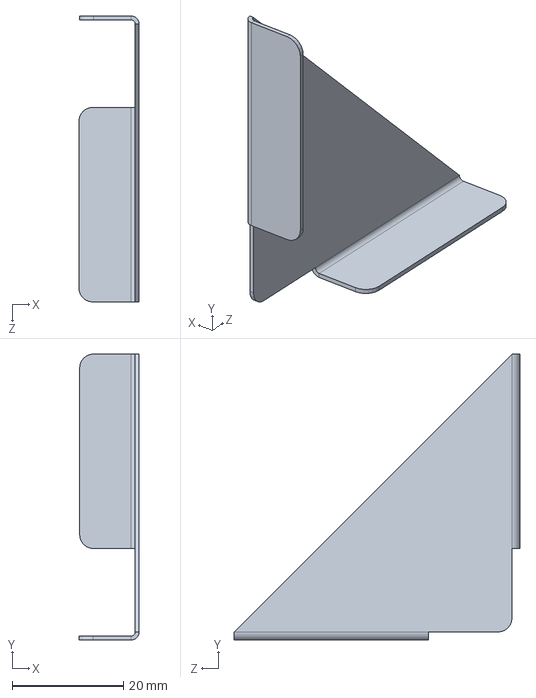
[picture p180: CAD file, 2013-07-19]
Hardware/Electrical Mounting/end support.SLDPRT
10.8 x 51.4 x 51.4 mm
