rowan-walsh/BruteforceIgnorance/Hardware/Firing mechanism/Printed Motor-Roller Gear 2.SLDPRT

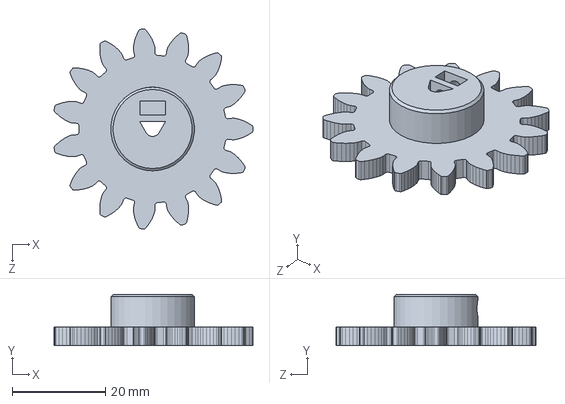
[picture p181: CAD file, 2013-07-16]
Hardware/Firing mechanism/Printed Motor-Roller Gear 2.SLDPRT
42.8 x 11.0 x 43.0 mm
