rowan-walsh/BruteforceIgnorance/Hardware/Internal Ball Handling/Sliding Gate.SLDPRT

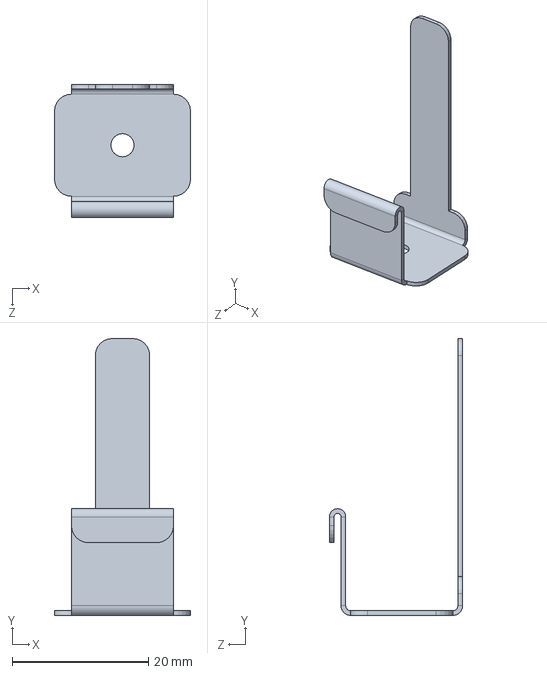
[picture p182: CAD file, 2013-08-02]
Hardware/Internal Ball Handling/Sliding Gate.SLDPRT
20.0 x 40.7 x 19.6 mm
