rowan-walsh/BruteforceIgnorance/Hardware/Supplied Component Models/solarbotics-gm7-solid-model/GM7-Assem.SLDASM

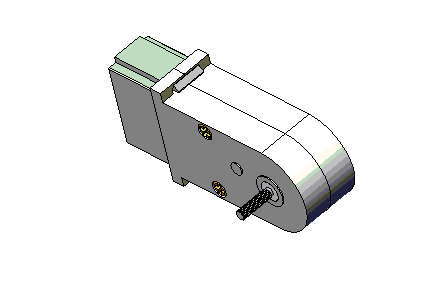
[picture p183: CAD file, 2013-05-31]
Hardware/Supplied Component Models/solarbotics-gm7-solid-model/GM7-Assem.SLDASM
gm7-side2
gm7-side1
GM6-7_motor
phillips head x 2
shaft-gm7
GM6-7_strap
