rowan-walsh/BruteforceIgnorance/Hardware/Supplied Component Models/solarbotics_gm2_solid_models/export/Solarbotics-GM2_Assem.SLDASM

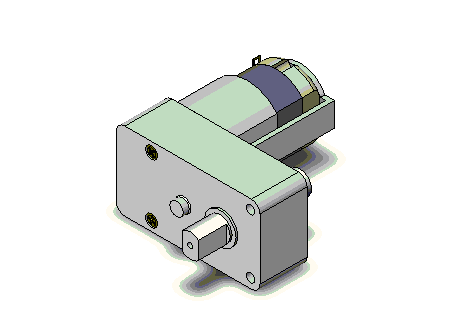
[picture p184: CAD file, 2013-05-31]
Hardware/Supplied Component Models/solarbotics_gm2_solid_models/export/Solarbotics-GM2_Assem.SLDASM
gm2
RM3-regular motor
GMstrap1
screw_head1 x 2
screw_head2 x 2
