rowan-walsh/BruteforceIgnorance/Enviroment/Official Play Surface/01 switch carrier sub.SLDASM

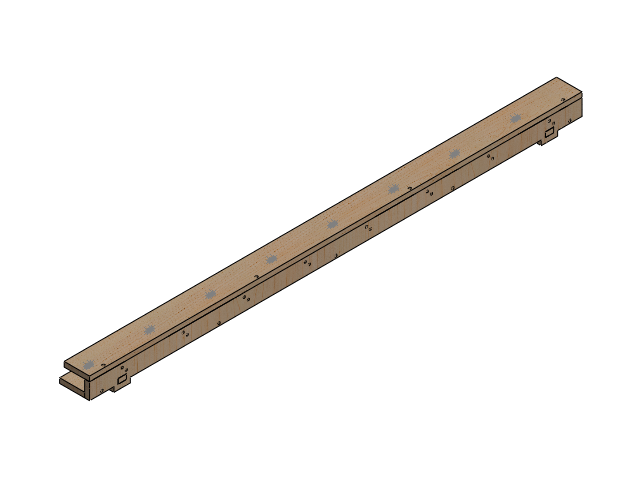
[picture p185: CAD file, 2013-06-11]
Enviroment/Official Play Surface/01 switch carrier sub.SLDASM
LED holder 3 - bottom
LED holder 1
LED 5mm x 8
microswitch x 8
microswitch holder x 8
LED holder 2 - top
