rowan-walsh/BruteforceIgnorance/Enviroment/Official Play Surface/01 switch sub.SLDASM

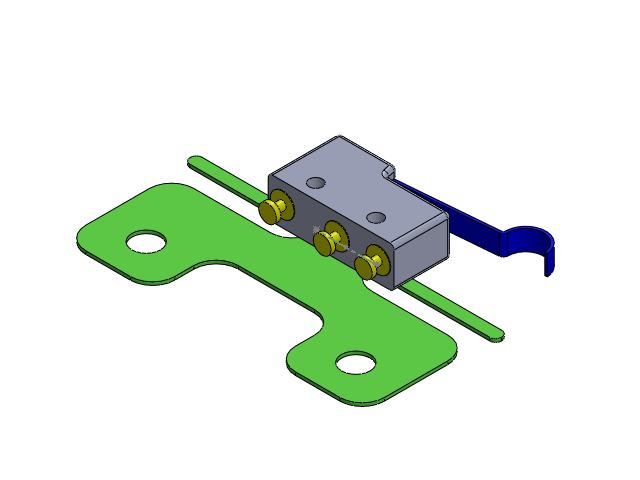
[picture p186: CAD file, 2013-06-11]
Enviroment/Official Play Surface/01 switch sub.SLDASM
microswitch
microswitch holder
