rowan-walsh/BruteforceIgnorance/(list of files, cad)

Other CAD files:
Enviroment/Official Play Surface/LED holder 2 - top.SLDPRT
Hardware/Ferris Wheel/Holder Diagram.SLDPRT
Hardware/Supplied Component Models/solarbotics-gm7-solid-model/shaft-gm7.SLDPRT
Hardware/Supplied Component Models/solarbotics-gm7-solid-model/gm7-side2.SLDPRT
Hardware/Supplied Component Models/solarbotics-gm7-solid-model/gm7-side1.SLDPRT
Hardware/Supplied Component Models/solarbotics_gm2_solid_models/export/GMstrap1.SLDPRT
Hardware/Supplied Component Models/solarbotics_gm2_solid_models/export/gm2.SLDPRT
Enviroment/Official Play Surface/LED holder 3 - bottom.SLDPRT
Hardware/Supplied Component Models/solarbotics_gm2_solid_models/export/RM3-regular motor.SLDPRT
Enviroment/Official Play Surface/microswitch.SLDPRT
Hardware/Chassis/Firing Support Support (mirror).SLDPRT
Enviroment/Official Play Surface/LED 5mm.SLDPRT
Enviroment/Official Play Surface/bottom 13mm.SLDPRT
Enviroment/Official Play Surface/cover flaps.SLDPRT
Enviroment/Official Play Surface/layout.SLDPRT
Enviroment/Official Play Surface/microswitch holder.SLDPRT
Enviroment/Official Play Surface/play surface.SLDPRT
Enviroment/Official Play Surface/side shape 19mm ns.SLDPRT
Hardware/Ball Collector/Ball Bearing 1cm.SLDPRT
Hardware/Ball Collector/Brush Drive Gear Large.SLDPRT
Hardware/Ball Collector/Brush Drive Gear Small.SLDPRT
Hardware/Ball Collector/Brush Drive Gear.dxf
Hardware/Ball Collector/Brush Motor Belt Gear.SLDPRT
Hardware/Ball Collector/Brush Shaft Constraint 2D.SLDPRT
Hardware/Ball Collector/Brush Shaft Holder 3D Female.SLDPRT
Hardware/Ball Collector/Brush Shaft Holder 3D.SLDPRT
Hardware/Ball Collector/Brush Wheel 3.SLDPRT
Hardware/Ball Collector/Brush Wheel.SLDPRT
Hardware/Ball Collector/Brush_Monofilament.SLDPRT
Hardware/Ball Collector/Brush_Shaft_Slot_Constraint.SLDPRT
Hardware/Ball Collector/Brush_Shaft_Slot_Constraint_Small_End.SLDPRT
Hardware/Ball Collector/Brush_Wheel_Big.SLDPRT
Hardware/Ball Collector/Brush_Wheel_Small.SLDPRT
Hardware/Ball Collector/Brush_Wheel_Tensioner.SLDPRT
Hardware/Ball Collector/Gear 22 teeth.SLDPRT
Hardware/Ball Collector/M8 Washer.SLDPRT
Hardware/Ball Collector/Machined Brush Axle.SLDPRT
Hardware/Ball Collector/Old/Brush Wheel 3.SLDPRT
Hardware/Ball Collector/Old/Brush Wheel.SLDPRT
Hardware/Ball Collector/Old/Machined Brush Axle.SLDPRT
Hardware/Ball Collector/Old/String.SLDPRT
Hardware/Ball Collector/Omni_Bearing_Holder.SLDPRT
Hardware/Ball Collector/Screw SC M2.5 x 6.SLDPRT
Hardware/Ball Collector/Screw SC M3 x 5.SLDPRT
Hardware/Ball Collector/Screw SC M3 x 8.SLDPRT
Hardware/Ball Collector/Solid_Brush.SLDPRT
Hardware/Ball Collector/Space Rod Cap.SLDPRT
Hardware/Ball Collector/Spacer Tube.SLDPRT
Hardware/Ball Collector/String.SLDPRT
Hardware/Ball Collector/big gear.SLDPRT
Hardware/Ball Collector/small gear 2.SLDPRT
Hardware/Chassis/01 Base.SLDPRT
Hardware/Chassis/02 Brush Mount.SLDPRT
Hardware/Chassis/022 Brush Shaft Holder Large.SLDPRT
Hardware/Chassis/023 Brush Shaft Holder Small.SLDPRT
Hardware/Chassis/Bearings.SLDPRT
Hardware/Chassis/Bearings.STL
Hardware/Chassis/Chassis.SLDPRT
Hardware/Chassis/Old/01 Base.SLDPRT
Hardware/Chassis/Old/02 Brush Mount.SLDPRT
Hardware/Chassis/Old/Chassis.SLDPRT
Hardware/Chassis/Old/Chassis_One_Piece.SLDPRT
Hardware/Chassis/flange wall side.SLDPRT
Hardware/Chassis/large corner guard.SLDPRT
Hardware/Chassis/small corner guard.SLDPRT
Hardware/Electrical Mounting/Capacitor mount.STL
Hardware/Electrical Mounting/Comparator Board Mount.SLDPRT
Hardware/Electrical Mounting/Header board support.SLDPRT
Hardware/Electrical Mounting/Header board support.STL
Hardware/Electrical Mounting/base right flange.SLDPRT
Hardware/Electrical Mounting/battery harness mount.SLDPRT
Hardware/Electrical Mounting/battery tinah mount.SLDPRT
Hardware/Electrical Mounting/natasha.SLDPRT
Hardware/Electrical Mounting/right angle.SLDPRT
Hardware/Ferris Wheel/Axle Bolt Head Holder.SLDPRT
Hardware/Ferris Wheel/Axle Bolt Nut Holder.SLDPRT
Hardware/Firing mechanism/18t_gear.dxf
Hardware/Firing mechanism/18t_gear_2.dxf
Hardware/Firing mechanism/48t_gear.dxf
Hardware/Firing mechanism/Ball Guide Bracket.SLDPRT
Hardware/Firing mechanism/Ball Guide.SLDPRT
Hardware/Firing mechanism/Firing Mounting Bracket.SLDPRT
Hardware/Firing mechanism/Kicker Tests/Kicker arm test bed.DXF
Hardware/Firing mechanism/Kicker Tests/Kicker arm.DXF
Hardware/Firing mechanism/Mirrored Firing Mounting Bracket.SLDPRT
Hardware/Firing mechanism/Motor-Roller Gear 2.SLDPRT
Hardware/Firing mechanism/Motor-Roller Gear.SLDPRT
Hardware/Firing mechanism/Old Firing Rollers/Roller Mechanism Plates.SLDPRT
Hardware/Firing mechanism/Old Firing Rollers/Roller Section.SLDPRT
Hardware/Firing mechanism/Printed Motor-Roller Gear.SLDPRT
Hardware/Firing mechanism/Roller Gear.SLDPRT
Hardware/Firing mechanism/Roller Mechanism Plates.SLDPRT
Hardware/Firing mechanism/Roller Section.SLDPRT
Hardware/Firing mechanism/Roller Spacer.SLDPRT
Hardware/Firing mechanism/Space Rod Cap.SLDPRT
Hardware/Firing mechanism/String.SLDPRT
Hardware/Firing mechanism/Upright Motor Bracket.SLDPRT
Hardware/IR Sensor/IR Box Bottom.DXF
Hardware/IR Sensor/IR Box Top.DXF
Hardware/IR Sensor/OP 805 Blinder/Blinder.SLDPRT
Hardware/IR Sensor/OP 805 Blinder/Blinder.STL
Hardware/IR Sensor/OP 805 Blinder/GLaDOS blinder.STL
Hardware/IR Sensor/OP 805 Blinder/GLaDOS faceplate.STL
Hardware/IR Sensor/Tube.STL
Hardware/Internal Ball Handling/Arm Rod.SLDPRT
Hardware/Internal Ball Handling/Arm-Servo Mount.SLDPRT
Hardware/Internal Ball Handling/Base Plate.SLDPRT
Hardware/Internal Ball Handling/Corner Brace.SLDPRT
Hardware/Internal Ball Handling/Gate Servo Bracket.SLDPRT
Hardware/Internal Ball Handling/Gate Servo Lever.SLDPRT
Hardware/Internal Ball Handling/Lifting Servo Bracket 2.SLDPRT
Hardware/Internal Ball Handling/Lifting Servo Bracket.SLDPRT
Hardware/Internal Ball Handling/Lower Ramp 2.SLDPRT
Hardware/Internal Ball Handling/Lower Ramp 3.SLDPRT
Hardware/Internal Ball Handling/Lower Ramp.SLDPRT
Hardware/Internal Ball Handling/Ramp Brace.SLDPRT
Hardware/Internal Ball Handling/Spring Retaining Washer.SLDPRT
Hardware/Internal Ball Handling/Upper Ramp 2.SLDPRT
Hardware/Internal Ball Handling/Upper Ramp.SLDPRT
Hardware/Mars Rover Wheels/01 Servo Assembly.SLDASM
Hardware/Mars Rover Wheels/24-tooth_gear.dxf
Hardware/Mars Rover Wheels/30-tooth_gear.dxf
Hardware/Mars Rover Wheels/3inch Turntable.SLDPRT
Hardware/Mars Rover Wheels/48-tooth_gear.dxf
Hardware/Mars Rover Wheels/4inch Turntable Bottom.SLDPRT
Hardware/Mars Rover Wheels/4inch Turntable Top.SLDPRT
Hardware/Mars Rover Wheels/4inch Turntable.SLDPRT
Hardware/Mars Rover Wheels/Gear Bracket.SLDPRT
Hardware/Mars Rover Wheels/Servo Bracket 2.1.SLDPRT
Hardware/Mars Rover Wheels/Servo Bracket 2.2.SLDPRT
Hardware/Mars Rover Wheels/Servo Bracket.SLDPRT
Hardware/Mars Rover Wheels/Servo Connector.SLDPRT
Hardware/Mars Rover Wheels/Servo Gear (24t).SLDPRT
Hardware/Mars Rover Wheels/Servo Gear (30t).SLDPRT
Hardware/Mars Rover Wheels/rubber wheel cover.SLDPRT
Hardware/Old Draft Work/Ferris Wheel/Axle Bolt Head Holder.SLDPRT
Hardware/Old Draft Work/Ferris Wheel/Axle Bolt Nut Holder.SLDPRT
Hardware/Old Draft Work/Ferris Wheel/Holder Diagram.SLDPRT
Hardware/Supplied Component Models/solarbotics-gm7-solid-model/GM7_Imperial.SLDDRW
Hardware/Supplied Component Models/solarbotics-gm7-solid-model/GM7_Metric.SLDDRW
Hardware/Supplied Component Models/solarbotics_gm2_solid_models/export/screw_head1.SLDPRT
Hardware/Supplied Component Models/solarbotics_gm2_solid_models/export/screw_head2.SLDPRT
Hardware/Wall Bearing/Nut 1-4-20.SLDPRT
Hardware/Wall Bearing/Screw 1-4in 3-4in long.SLDPRT
Hardware/Wall Bearing/Washer 0.26ID 0.5OD.SLDPRT
Hardware/Wall Bearing/Washer 1-4in.SLDPRT
