rowan-walsh/BruteforceIgnorance/(list of files, drawings)

Other design files:
Electronics/BatteryHarness2.fzz
Electronics/BatteryHarness.fzz
Electronics/H-bridge-real.fzz
Electronics/H-bridge.fzz
Electronics/IR sensor.fzz
Electronics/LM311 Comparator Circuit.fzz
Electronics/Miniature H-bridge.fzz
Electronics/Natasha.fzz
