rowan-walsh/BruteforceIgnorance/(commit log)

2013-05-30 Added rough shape of bot
    [Rough Shape.SLDPRT]
2013-05-31 Added motor solidworks files
    [GM2_assembly.IGS, GM7-Assem.SLDASM, GM7_Imperial.SLDDRW, GM7_Metric.SLDDRW, GMstrap1.SLDPRT, RM3-regular motor.SLDPRT, Solarbotics gm2.STL, Solarbotics-GM2_Assem.SLDASM]
2013-05-31 Base plate for Proto-Bot
    [Base Plate.SLDPRT, Rough Shape 2.SLDPRT, Rough Shape.SLDPRT]
2013-06-01 Zap-strap holes in base plate
    [Base Plate.SLDPRT]
2013-06-01 Competition Surface (To Scale)
    [PlaySurfaceToScale.SLDPRT]
2013-06-01 Added 10kHz emitter
    [PlaySurfaceToScale.SLDPRT]
2013-06-01 Squash Ball
    [SquashBall.SLDPRT]
2013-06-06 Re-organized, feel free to add subfolders
    [Base Plate.SLDPRT, GM2_assembly.IGS, GM7-Assem.SLDASM, GM7_Imperial.SLDDRW, GM7_Metric.SLDDRW, GMstrap1.SLDPRT, PlaySurfaceToScale.SLDPRT, RM3-regular motor.SLDPRT]
2013-06-06 Started the Rough Layout Assembly
    [Ball Guide Roller - rough.SLDPRT, Ball Guides - rough.SLDPRT, Brush - rough.SLDPRT, Collection Rough Assembly.SLDASM, Drive Wheel Rough Assembly.SLDASM, Motor Barber Coleman geared.SLDPRT, Rough Layout Assembly.SLDASM, Wheel - rough.SLDPRT]
2013-06-07 More detailed collector assembly
    [Ball Guide 2 - rough.SLDPRT, Brush - rough.SLDPRT, Collection 2 Rough Assembly.SLDASM]
2013-06-08 Tweaked Rough Collection Assembly
    [Collection 2 Rough Assembly.SLDASM, String Wheel.DXF]
2013-06-09 Initial Ferris Wheel commit
    [Axle Bolt Head Holder.SLDPRT, Axle Bolt Nut Holder.SLDPRT, Center Spacer.SLDPRT, Containment Plate.SLDPRT, Ferris Assembly.SLDASM, Ferris Plate.SLDPRT, Holder Diagram.SLDPRT, Perimeter Spacer.SLDPRT]
2013-06-09 Initial Collector commit
    [Brush Assembly.SLDASM, Brush Axle.SLDPRT, Brush Wheel.SLDPRT, String.SLDPRT]
2013-06-09 Changes to Ferris and Collector
    [Ball Guide 2 - rough.SLDPRT, Brush Assembly.SLDASM, Brush Wheel 3.SLDPRT, Brush Wheel.SLDPRT, Center Spacer.SLDPRT, Chassis.SLDPRT, Containment Plate.SLDPRT, Fancy Brush Assembly.SLDASM]
2013-06-09 Moved Ferris to Old Draft Work
    [Axle Bolt Head Holder.SLDPRT, Axle Bolt Nut Holder.SLDPRT, Center Spacer.SLDPRT, Containment Plate.SLDPRT, Ferris Assembly.SLDASM, Ferris Plate.SLDPRT, Holder Diagram.SLDPRT, Insertion Ramp.SLDPRT]
2013-06-11 Added official play area
    [00 target assmbly full size.SLDASM, 01 switch carrier sub.SLDASM, 01 switch sub.SLDASM, 10kHz IR emitter beacon.SLDPRT, LED 5mm.SLDPRT, LED holder 1.SLDPRT, LED holder 2 - top.SLDPRT, LED holder 3 - bottom.SLDPRT]
2013-06-13 Added PID tuning instructions for ENPH 253 Lab #5
2013-06-13 Added Lazy Susan Bearing models
    [3inch Turntable.SLDPRT, 4inch Turntable.SLDPRT]
2013-06-13 General improvements to PID
2013-06-15 Mars Rover Wheels initial commit
    [4inch Turntable Assembly.SLDASM, 4inch Turntable Bottom.SLDPRT, 4inch Turntable Top.SLDPRT, 4inch Turntable.SLDPRT, Mars Rover Wheel Assembly.SLDASM, Motor Assembly.SLDASM, Motor Bracket.SLDPRT, Wheel.SLDPRT]
2013-06-15 Solenoid test platform, camshaft mechanism
    [Brush Wheel 3.SLDPRT, Cam.SLDPRT, Camshaft base.SLDPRT, Camshaft circle.SLDASM, Kicker arm base.DXF, Kicker arm test bed.DXF, Kicker arm test bed.SLDPRT, Kicker arm.DXF]
2013-06-15 Removed useless file
    [Kicker arm base.DXF]
2013-06-15 Added servo connector
    [00 Mars Rover Wheel Assembly.SLDASM, 01 4inch Turntable Assembly.SLDASM, 01 Motor Assembly.SLDASM, Mars Rover Wheel Assembly.SLDASM, Motor Assembly.SLDASM, Motor Bracket.SLDPRT, Servo Connector.SLDPRT]
2013-06-15 Added some of the supplied gear models
    [Meccano Gear 39mm.SLDPRT, helical gear 40 teeth.SLDPRT, worm and gear assembly.SLDASM, worm for helical gear.SLDPRT]
2013-06-15 Sheet metal chassis and brush mounting
    [Brush_Assembly.SLDASM, Brush_Monofilament.SLDPRT, Brush_Rod.SLDPRT, Brush_Shaft_Slot_Constraint.SLDPRT, Brush_Top_Guard.SLDPRT, Brush_Wheel_Big.SLDPRT, Brush_Wheel_Small.SLDPRT, Chassis Assembly.SLDASM]
2013-06-15 Initial Emitter commit
    [00 Emitter.SLDASM, Kicker arm test bed.DXF, Kicker arm test bed.SLDPRT, Kicker arm.DXF, Kicker arm.SLDPRT, Roller Assembly.SLDASM, Roller Axle.SLDPRT, Roller Mechanism Plates.SLDPRT]
2013-06-15 Reorganized brush file locations
    [Brush Wheel 3.SLDPRT, Brush Wheel.SLDPRT, Brush_Assembly.SLDASM, Brush_Monofilament.SLDPRT, Brush_Rod.SLDPRT, Brush_Shaft_Slot_Constraint.SLDPRT, Brush_Top_Guard.SLDPRT, Brush_Wheel_Big.SLDPRT]
2013-06-15 Update references
    [Chassis Assembly.SLDASM, Chassis.SLDPRT, Chassis_One_Piece.SLDPRT]
2013-06-15 Broke chassis into multiple pieces; omni-bearing
    [00 Chassis Assembly.SLDASM, 00 Mars Rover Wheel Assembly.SLDASM, 01 4inch Turntable Assembly.SLDASM, 01 Base.SLDPRT, 02 Brush Mount.SLDPRT, Ball Bearing 1cm.SLDPRT, Chassis Assembly.SLDASM, Chassis_One_Piece.SLDPRT]
2013-06-15 Chassis Update
    [00 Chassis Assembly.SLDASM, 01 Base.SLDPRT, 02 Brush Mount.SLDPRT, Chassis_One_Piece.SLDPRT, Omni_Bearing.SLDASM, Omni_Bearing_Holder.SLDPRT]
2013-06-15 Added servo models
    [Servo Assembly Futaba S3003.SLDASM, Servo Futaba S3003.SLDPRT, Servo Rotor.SLDPRT, Servo Spindle.SLDPRT]
2013-06-15 Servo mount for turning rover wheel
    [01 Servo Assembly.SLDASM, Servo Assembly Futaba S3003.SLDASM, Servo Bracket.SLDPRT, Servo Futaba S3003.SLDPRT, Servo Rotor.SLDPRT, Servo Spindle.SLDPRT]
2013-06-15 More servo mount changes
    [00 Mars Rover Wheel Assembly.SLDASM, 01 4inch Turntable Assembly.SLDASM, 01 Motor Assembly.SLDASM, 24-tooth_gear.dxf, 30-tooth_gear.dxf, 48-tooth_gear.dxf, Gear Bracket.SLDPRT, Motor Bracket.SLDPRT]
2013-06-15 Added sensor circuit (schematic, protoboard)
    [IR detection circuit.fzz]
2013-06-16 Software 95% done. Has flowcharts + pseudocode
    Added software section, pseudocode, flowcharts. Covered all the
    sections. At this point it is just editing and minor revisions left for
    the software and algorithm parts.
2013-06-16 Mars Rover wheel changes
2013-06-16 Sensor system
2013-06-16 Chassis and ball collector update
    [00 Chassis Assembly.SLDASM, 01 Base.SLDPRT, 01 Chassis Base.SLDPRT, 02 Brush Mount.SLDPRT, 02 Chassis Wall.SLDPRT, Brush_Assembly.SLDASM, Brush_Shaft_Slot_Constraint_Big_End.SLDPRT, Brush_Shaft_Slot_Constraint_Small_End.SLDPRT]
2013-06-16 Deleted old assembly
    [Robot Assembly.SLDASM]
2013-06-16 Drive System documentation and images
    [00 Mars Rover Wheel Assembly.SLDASM, 01 4inch Turntable Assembly.SLDASM, 01 Motor Assembly.SLDASM, Motor Barber Coleman geared.SLDPRT, Motor Bracket.SLDPRT, Servo Futaba S3003.SLDPRT, Wheel.SLDPRT]
2013-06-16 Sensor system and Electrical Design
    [IR detection circuit.fzz]
2013-06-16 Firing system models
    [01 Firing Assembly.SLDASM, 02 Roller Assembly.SLDASM, 48t_gear.dxf, Part1.SLDPRT, Roller Axle.SLDPRT, Roller Bracket.SLDPRT, Roller Plate.SLDPRT, Roller Spacer.SLDPRT]
2013-06-16 Moved old firing mechanism stuff
    [Roller Assembly.SLDASM, Roller Mechanism Plates.SLDPRT, Roller Section.SLDPRT]
2013-06-16 Added TINAH, drive system to chassis, team tasks to design report.
    [00 Chassis Assembly.SLDASM, 01 Chassis Base.SLDPRT, 02 Chassis Wall.SLDPRT, Brush_Shaft_Slot_Constraint_Big_End.SLDPRT, Brush_Shaft_Slot_Constraint_Small_End.SLDPRT, Brush_Top_Guard.SLDPRT, Tinah Board representation.SLDPRT]
2013-06-17 Firing mechanism documentation and model
    [01 Firing Assembly.SLDASM, 02 Roller Assembly.SLDASM, Roller Plate.SLDPRT, SquashBall.SLDPRT, String.SLDPRT]
2013-06-17 Design doc and more complete robot
    [00 Chassis Assembly.SLDASM, 00 Mars Rover Wheel Assembly.SLDASM, 01 Chassis Base.SLDPRT, 01 Motor Assembly.SLDASM, 01 Servo Assembly.SLDASM, 02 Chassis Wall.SLDPRT, Brush Drive Motor Mount.SLDPRT, Brush Drive.SLDASM]
2013-06-17 Roller Graphic, now with acrylic gear!
    [01 Firing Assembly.SLDASM, 02 Roller Assembly.SLDASM, Roller Axle.SLDPRT, Roller Gear.SLDPRT, Roller Plate.SLDPRT, String.SLDPRT]
2013-06-17 Latex PID Tuning Instructions
2013-06-17 Added Scott/Liam PID instructions
2013-06-17 Final Latex PID Tuning Instructions edits
2013-06-18 Updated Design Proposal
    [LM311 Comparator Circuit.fzz]
2013-06-18 Added motor gear to Firing Assembly
    [01 Firing Assembly.SLDASM, 02 Roller Assembly.SLDASM, 18t_gear.dxf, 18t_gear_2.dxf, Motor-Roller Gear.SLDPRT, Roller Gear Spacer.SLDPRT, Roller Gear.SLDPRT]
2013-06-18 Changed drive motor bracket to M3 Holes
    [00 Mars Rover Wheel Assembly.SLDASM, 01 Motor Assembly.SLDASM, Gear Bracket.SLDPRT, Motor Bracket.SLDPRT, Servo Bracket.SLDPRT, Turntable Gear.SLDPRT]
2013-06-19 Tidying up Mars Rover Wheels
    [00 Mars Rover Wheel Assembly.SLDASM, 01 Motor Assembly.SLDASM, Motor Bracket.SLDPRT, Printed Servo Gear.SLDPRT, Servo Bracket.SLDPRT, Servo Gear (30t).SLDPRT, Wheel.SLDPRT]
2013-06-19 Updated roller bearings, QRD holder
    [00 Chassis Assembly.SLDASM, 01 Chassis Base.SLDPRT, 02 Chassis Wall.SLDPRT, Ball Bearing 1cm.SLDPRT, Omni_Bearing.SLDASM, Omni_Bearing_Holder.SLDPRT, QRD Holder.SLDPRT, Robot Assembly.SLDASM]
2013-06-21 H-bridge in Fritzing
    It actually works, and it will take about an hour to assemble--hopefully
    less.
    [H-bridge-real.fzz, H-bridge.fzz]
2013-06-22 Added motor to firing mechanism
    Firing mechanism assembly has meshing gears too.
    [01 Firing Assembly.SLDASM, 02 Motor Assembly.SLDASM, 02 Roller Assembly.SLDASM, Motor BarbCole Ungeared.SLDPRT, Motor-Roller Gear.SLDPRT, Part1.SLDPRT, Printed Motor-Roller Gear.SLDPRT, Roller Bracket.SLDPRT]
2013-06-22 Late Mars Rover Wheels tweaks commit
    [00 Mars Rover Wheel Assembly.SLDASM, 01 Motor Assembly.SLDASM, Printed Servo Gear.SLDPRT, Turntable Gear.SLDPRT, Wheel.SLDPRT]
2013-06-25 Rubber wheels, brush updates
    [00 Chassis Assembly.SLDASM, 01 Chassis Base.SLDPRT, 02 Chassis Wall.SLDPRT, Brush_Wheel_Big.SLDPRT, Brush_Wheel_Small.SLDPRT, Robot Assembly.SLDASM, Space Rod Cap.SLDPRT, rubber wheel cover.SLDPRT]
2013-06-25 Mars Rover Wheels v2
    [00 Mars Rover Wheel Assembly.SLDASM, 01 Motor Assembly.SLDASM, 01 Servo Assembly v2.SLDASM, 01 Servo Assembly.SLDASM, Gear Bracket.SLDPRT, Lower Turntable Gear.SLDPRT, Motor Bracket.SLDPRT, Printed Servo Gear.SLDPRT]
2013-06-26 Added laser range finder
    [Laser Enclosure.SLDPRT, Laser Range Finder.SLDPRT, Laser pointer.SLDPRT, Laser range finder assembly.SLDASM, OP805.SLDPRT, laser.SLDPRT]
2013-06-26 Finalized mars rover wheels v2
    [00 Mars Rover Wheel Assembly.SLDASM, 01 Motor Assembly.SLDASM, Lower Turntable Gear.SLDPRT, Wheel.SLDPRT]
2013-06-26 Firing rollers, string locks
    [01 Firing Assembly.SLDASM, 02 Motor Assembly.SLDASM, 02 Roller Assembly.SLDASM, Motor-Roller Gear.SLDPRT, Printed Motor-Roller Gear.SLDPRT, Roller Bracket.SLDPRT, Roller Gear Spacer.SLDPRT, Roller Gear.SLDPRT]
2013-06-26 Liam's electrical mounting initial commit
    [base right flange.SLDPRT, battery harness mount.SLDPRT, battery tinah mount.SLDPRT, electrical mounting assembly.SLDASM, main vertical support.SLDPRT, natasha.SLDPRT, right angle.SLDPRT]
2013-06-27 Battery harness 0.1
    [BatteryHarness.fzz, H-bridge-real.fzz]
2013-06-27 Battery harness 0.5, specs
    [BatteryHarness.fzz]
2013-06-29 Update collector wall,
    [00 Chassis Assembly.SLDASM, 00 Mars Rover Wheel Assembly.SLDASM, 01 Chassis Base.SLDPRT, 01 Motor Assembly.SLDASM, 020 Collector Structure.SLDASM, 021 Collector Wall Back.SLDPRT, 022 Collector Wall Big End.SLDPRT, 023 Collector Wall Small End.SLDPRT]
2013-06-29 Updated firing mechanism (built)
    [01 Firing Assembly.SLDASM, 02 Motor Assembly.SLDASM, 02 Roller Assembly.SLDASM, Lower Turntable Gear.SLDPRT, Motor-Roller Gear.SLDPRT, Printed Motor-Roller Gear.SLDPRT, Roller Bracket.SLDPRT, Roller Gear Spacer.SLDPRT]
2013-06-29 IR sensor, Natasha board
    [IR detection circuit.fzz, IR sensor.fzz, Natasha.fzz]
2013-06-30 Fixed commit error, added wall follow code
    [Basic_PID_Wall_Following.pde, Wall Follow.cpp]
2013-07-05 Final final firing assembly
    [01 Firing Assembly.SLDASM, 02 Motor Assembly.SLDASM, 02 Roller Assembly.SLDASM, Ball Guide Bracket.SLDPRT, Ball Guide.SLDPRT, Motor-Roller Gear 2.SLDPRT, Motor-Roller Gear.SLDPRT, Printed Motor-Roller Gear 2.SLDPRT]
2013-07-05 Initial ramps commit
    [00 Ball Handler.SLDASM, Base Plate.SLDPRT, Lower Ramp.SLDPRT, Upper Ramp.SLDPRT]
2013-07-05 Battery harness, IR sensor, small H-bridge
    [BatteryHarness.fzz, IR sensor.fzz, Miniature H-bridge.fzz]
2013-07-06 Ramp Arm added
    [00 Ball Handler.SLDASM, 02 Arm Assembly.SLDASM, Arm Hoop.SLDPRT, Arm Rod.SLDPRT, Arm-Servo Mount.SLDPRT, Lower Ramp.SLDPRT]
2013-07-06 Ball handler draft (doesn't yet fit)
    [00 Ball Handler.SLDASM, 00 Chassis Assembly.SLDASM, 00 Mars Rover Wheel Assembly.SLDASM, 01 Firing Assembly.SLDASM, 01 Lifting Assembly.SLDASM, 01 Motor Assembly.SLDASM, 01 Servo Assembly v2.SLDASM, 02 Arm Assembly.SLDASM]
2013-07-06 Heat pipe lab
    [IR sensor.fzz]
2013-07-07 Brush Drive and collector structure
    [00 Chassis Assembly.SLDASM, 020 Collector Structure.SLDASM, 021 Collector Wall Back.SLDPRT, 022 Collector Wall Big End.SLDPRT, 023 Collector Wall Small End.SLDPRT, Brush Drive Gear Large.SLDPRT, Brush Drive Gear Small.SLDPRT, Brush Drive Gear.dxf]
2013-07-08 Ball handler design 1
    [00 Ball Handler.SLDASM, 01 Lifting Assembly.SLDASM, 02 Arm Assembly.SLDASM, Arm Hoop.SLDPRT, Arm Rod.SLDPRT, Base Plate.SLDPRT, Corner Brace.SLDPRT, Lower Ramp 2.SLDPRT]
2013-07-08 IR sensor, battery harness, h-bridge
    [BatteryHarness.fzz, IR sensor.fzz, Miniature H-bridge.fzz]
2013-07-09 Ball handler design 2
    [00 Ball Handler.SLDASM, 00 Chassis Assembly.SLDASM, 01 Firing Assembly.SLDASM, 01 Lifting Assembly.SLDASM, 02 Arm Assembly.SLDASM, Arm Rod.SLDPRT, Arm-Servo Mount.SLDPRT, Base Plate.SLDPRT]
2013-07-09 Ball handler design 3
    [00 Ball Handler 2.SLDASM, 00 Ball Handler.SLDASM, 01 Firing Assembly.SLDASM, 01 Lifting Assembly.SLDASM, Corner Brace.SLDPRT, Firing Mounting Bracket.SLDPRT, Lifting Servo Bracket 2.SLDPRT, Lifting Servo Bracket.SLDPRT]
2013-07-10 Workable Ball handler (mwahaha)
    [00 Ball Handler 2.SLDASM, 00 Emitter.SLDASM, 01 Lifting Assembly.SLDASM, Lifting Servo Bracket 2.SLDPRT, Ramp Brace.SLDPRT, Robot Assembly.SLDASM, Upper Ramp 2.SLDPRT]
2013-07-10 Added render images. Added lab setup assembly
    [AluminiumRod.SLDPRT, Conduction Setup.SLDASM, Insulation.SLDPRT, Resistor.SLDPRT, Water.SLDPRT, WaterContainer.SLDPRT, Wire.SLDPRT]
2013-07-11 Finalized ball handler, added printed guide ramp
    Included means of adjusting the rod length.
    [00 Ball Handler 2.SLDASM, 00 Emitter.SLDASM, 01 Lifting Assembly.SLDASM, 02 Arm Assembly.SLDASM, Arm Rod.SLDPRT, Arm-Servo Mount.SLDPRT, Gate Servo Bracket.SLDPRT, Lifting Servo Bracket 2.SLDPRT]
2013-07-11 IR sensor updated
    [IR detection circuit.fzz, IR sensor.fzz]
2013-07-13 Final battery harness, printed bits
    [BatteryHarness.fzz, Header board support.SLDPRT, Header board support.STL, Tube.SLDPRT, Tube.STL]
2013-07-16 Shifted battery harness position
    [00 Ball Handler 2.SLDASM, 00 Emitter.SLDASM, 00 Mars Rover Wheel Assembly.SLDASM, 02 Arm Assembly.SLDASM, Arm Hoop.SLDPRT, Gate Servo Bracket.SLDPRT, Printed Motor-Roller Gear 2.SLDPRT, Upper Ramp 2.SLDPRT]
2013-07-19 Electrical Mounting and Ball handling
    [01 Firing Assembly.SLDASM, 02 Roller Assembly.SLDASM, Arm Hoop.SLDPRT, Comparator Board Mount.SLDPRT, Comparator Mount Brace.SLDPRT, Gate Servo Bracket 2.SLDPRT, Gate Servo Lever.SLDPRT, Lower Ramp 3.SLDPRT]
2013-07-19 Deleted thermo stuff, added touch sensor mounts
    [AluminiumRod.SLDPRT, Conduction Setup.SLDASM, Insulation.SLDPRT, Resistor.SLDPRT, Roller Bushing.SLDPRT, Touch Sensor Holder - Front.SLDPRT, Touch Sensor Holder - Side.SLDPRT, Water.SLDPRT]
2013-07-21 IR box parts--probably outdated
    [BatteryHarness.fzz, IR Box Bottom.DXF, IR Box Bottom.SLDPRT, IR Box Top.DXF, IR Box Top.SLDPRT, IR Box.SLDASM]
2013-07-22 Added servo set function
2013-07-22 Shorter QRD holder
    [QRD Holder.SLDPRT]
2013-07-23 Front Touch Sensor holder change
    [Touch Sensor Holder - Front.SLDPRT]
2013-07-24 Trying to recover stuff
    [00 Chassis Assembly.SLDASM, 000 Chassis Assembly.SLDASM, 01 Chassis Base.SLDPRT, 010 Chassis.SLDPRT, 02 Chassis Wall.SLDPRT, 020 Collector Assembly.SLDASM, 020 Collector Structure.SLDASM, 022 Brush Shaft Holder Large.SLDPRT]
2013-07-24 Pins in LineFollow code, framework for maneuvers
2013-07-25 Commented out laser stuff, cleaned up code
2013-07-25 Lighter front and wall bearing initial commit
    [00 Emitter.SLDASM, 000 Chassis Assembly.SLDASM, 01 Firing Assembly.SLDASM, 02 Roller Assembly.SLDASM, 020 Collector Assembly.SLDASM, 021 Collector Wall Back.SLDPRT, 022 Brush Shaft Holder Large.SLDPRT, 023 Brush Shaft Holder Small.SLDPRT]
2013-07-25 Code refactoring, added blinder + bracket models
    [Blinder.SLDPRT, Mounting bracket.SLDPRT]
2013-07-25 Battery harness revision and bearings (outdated)
    [BatteryHarness2.fzz, Bearings.SLDPRT, Bearings.STL]
2013-07-25 Fixed the previous refactoring
    [RobotManeuvers.pde]
2013-07-26 Refactored Fire() and fixed a bug
    [RobotManeuvers.pde]
2013-07-26 Can now override the current state for debugging
2013-07-26 Fixed a bug that prevented menu access during loops
    [RobotManeuvers.pde]
2013-07-26 Fixed issue: servo never returns to ball collect. Fixed issue preventing escape from infinite loops
    [RobotManeuvers.pde]
2013-07-26 Fixed issue that caused infinite ball collection
    [RobotManeuvers.pde]
2013-07-26 Fixed error to make it possible to adjust menu
    [RobotManeuvers.pde]
2013-07-26 Added firing calibration test
2013-07-26 Updated firing mounting
    [00 Emitter.SLDASM, 000 Chassis Assembly.SLDASM, 01 Firing Assembly.SLDASM, 010 Chassis.SLDPRT, 020 Collector Assembly.SLDASM, 021 Collector Wall Back.SLDPRT, 031 Big Corner Flange.SLDPRT, Firing Support Support (mirror).SLDPRT]
2013-07-28 Fixed typo in code
    [RobotManeuvers.pde]
2013-07-28 Deleted Heat Pipe Lab
2013-07-29 Added ability to tune the WF front servo angle
2013-07-30 photoshopped wheel
    [00 Ball Handler 2.SLDASM, Robot Assembly.SLDASM]
2013-07-30 Updated blinder
    [Blinder.SLDASM, Blinder.SLDPRT, GLaDOS blinder.SLDPRT, GLaDOS blinder.STL, GLaDOS faceplate.SLDPRT, GLaDOS faceplate.STL, Mounting bracket.SLDPRT]
2013-07-30 Added comp. board menu item, improved SecretLevel
2013-07-30 Corrected bug in line-following
    [RobotManeuvers.pde]
2013-07-30 Corrected firing bug and wall-following typos
    [RobotManeuvers.pde]
2013-07-31 Raised Collection Motor
    [Brush Drive Motor Mount.SLDPRT]
2013-07-31 Bug fixes for last working tests
    [RobotManeuvers.pde]
2013-07-31 Committed microswitch holder
    [MicroswitchHolder.SLDPRT]
2013-07-31 Fixed state menu bug
    [RobotManeuvers.pde]
2013-07-31 New Detent Bracket
    [Gate Servo Bracket 3.SLDPRT]
2013-07-31 Reversed front switch logic
    [Arm Hoop.SLDPRT, Gate Servo Bracket 2.SLDPRT, Gate Servo Bracket 3.SLDPRT]
2013-08-01 More detent iterations
    [Lower Ramp 4.SLDPRT, Sliding Gate.SLDPRT, Spring Retaining Washer.SLDPRT]
2013-08-02 Fixed break beam function
    [RobotManeuvers.pde]
2013-08-02 Breakbeam component mounts
    [Breakbeam Laser Holder.SLDPRT, Breakbeam OP805 Holder.SLDPRT]
2013-08-02 Fixed a bug that prevented rebound collection
    [RobotManeuvers.pde]
2013-08-02 Fixed missing brace and Added Home Beacon IR
    [RobotManeuvers.pde]
2013-08-02 Will now prevent overzealous ball conditions
    [RobotManeuvers.pde]
2013-08-02 Removed obsolete IR(int pin) function
2013-08-02 Refactored WallFollowSensorUpdate and added a new SwitchWallFollowDirection function
2013-08-02 Moved microswitch updates to new function. Fixed syntax error
    [RobotManeuvers.pde]
2013-08-02 IR sensor blinder
    [Blinder.SLDPRT, Blinder.STL, IR sensor.fzz, Touch Sensor Button.SLDPRT]
2013-08-03 Fixed minor syntax errors
    [RobotManeuvers.pde]
2013-08-04 Changed a weird bug related to servo angles
    [RobotManeuvers.pde]
2013-08-04 Fixed some motor directions. Everything needed to be reversed. What the heck happened??
    [RobotManeuvers.pde]
2013-08-04 Resolved most issues with reversed motor dirs
    [RobotManeuvers.pde]
2013-08-04 added motor delay, adjusted constant
2013-08-04 Increased turning velocity
2013-08-05 Reversed turn direction, works pretty well this way
    [RobotManeuvers.pde]
2013-08-06 Added a possible deployable microswitch design
    [DeployableMicroswitch.SLDPRT, DeployableMicroswitchHolder.SLDPRT]
2013-08-06 Brush no longer spins when firing to prevent detent failures
    [RobotManeuvers.pde]
2013-08-06 Fixed break beam. Reverted wheel stop time
    [RobotManeuvers.pde]
2013-08-06 Trimmed turntable gear, added wall to lower ramp
    [Lower Ramp 5.SLDPRT, Lower Turntable Gear.SLDPRT]
2013-08-06 Refactoring, added some LCD messages
    [Lower Turntable Gear.SLDPRT]
2013-08-07 Got motors to stop when cycling balls
2013-08-07 Corrected strafe speed gain bug
    [RobotManeuvers.pde]
2013-08-07 Added Beginning Stat, fixed no Front Angle menu
    [RobotManeuvers.pde]
2013-08-07 fixed float int casting issues
    [RobotManeuvers.pde]
2013-08-07 Going to menu now correctly stops wall-leaving
    [RobotManeuvers.pde]
2013-08-07 Added small wall-bounce-reverse, beginning bugfix
    [RobotManeuvers.pde]
2013-08-07 Commented out bounce-reverse, added acceleration
    [RobotManeuvers.pde]
2013-08-07 Brush stops during collection reverse and spin
    [RobotManeuvers.pde]
2013-08-07 IR sensor, capacitor and regulator mounts
    [Capacitor mount.SLDPRT, Capacitor mount.STL, IR Box Bottom.SLDPRT, IR Box Top.SLDPRT, IR sensor.fzz, Regulator mount.SLDPRT]
2013-08-07 Added LED functions
2013-08-08 Fixed SquareTouch(), some changes to doubleQRDFind
    [RobotManeuvers.pde]
2013-08-08 IR sensor update, absolutely futile
    [IR Box Bottom.SLDPRT, IR Box Top.SLDPRT, IR Box.SLDASM]
